olin-electric-motorsports/oem-monorepo/vehicle/mkviii/hardware/hv/power_thermistor/report.txt

Info: Processing symbol 'JP12:Jumper:SolderJumper-2_P1.3mm_Bridged2Bar_Pad1.0x1.5mm'.
Info: Processing symbol 'TH8:Resistor_SMD:R_0603_1608Metric'.
Info: Processing symbol 'TH7:Resistor_SMD:R_0603_1608Metric'.
Info: Processing symbol 'TH6:Resistor_SMD:R_0603_1608Metric'.
Info: Processing symbol 'TH5:Resistor_SMD:R_0603_1608Metric'.
Info: Processing symbol 'TH4:Resistor_SMD:R_0603_1608Metric'.
Info: Processing symbol 'TH3:Resistor_SMD:R_0603_1608Metric'.
Info: Processing symbol 'TH2:Resistor_SMD:R_0603_1608Metric'.
Info: Processing symbol 'TH1:Resistor_SMD:R_0603_1608Metric'.
Info: Processing symbol 'JP18:Jumper:SolderJumper-2_P1.3mm_Bridged2Bar_Pad1.0x1.5mm'.
Info: Processing symbol 'JP16:Jumper:SolderJumper-2_P1.3mm_Bridged2Bar_Pad1.0x1.5mm'.
Info: Processing symbol 'JP15:Jumper:SolderJumper-2_P1.3mm_Bridged2Bar_Pad1.0x1.5mm'.
Info: Processing symbol 'JP14:Jumper:SolderJumper-2_P1.3mm_Bridged2Bar_Pad1.0x1.5mm'.
Info: Processing symbol 'JP13:Jumper:SolderJumper-2_P1.3mm_Bridged2Bar_Pad1.0x1.5mm'.
Info: Processing symbol 'TH9:Resistor_SMD:R_0603_1608Metric'.
Info: Processing symbol 'JP11:Jumper:SolderJumper-2_P1.3mm_Bridged2Bar_Pad1.0x1.5mm'.
Info: Processing symbol 'JP10:Jumper:SolderJumper-2_P1.3mm_Bridged2Bar_Pad1.0x1.5mm'.
Info: Processing symbol 'JP9:Jumper:SolderJumper-2_P1.3mm_Bridged2Bar_Pad1.0x1.5mm'.
Info: Processing symbol 'JP8:Jumper:SolderJumper-2_P1.3mm_Bridged2Bar_Pad1.0x1.5mm'.
Info: Processing symbol 'F1:Fuse:Fuse_0805_2012Metric'.
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
Info: Processing symbol 'J22:OEM:J_Bond_Pad_4p'.
Info: Processing symbol 'J20:OEM:J_Bond_Pad_4p'.
Info: Processing symbol 'J13:OEM:J_Bond_Pad_4p'.
Connect U1 pin 3 to unconnected-(U1-NC-Pad3).
Reconnect U1 pin 1 from unconnected-(J2-Pad18) to Net-(U1-DQ).
Reconnect U1 pin 8 from unconnected-(J2-Pad19) to Net-(U1-GND).
Update U1 fields.
Update U1 symbol association from  to /2b54b1a4-bebb-4afd-9384-270c4761a90f.
Change U1 value from 21-0036K_MXM to DS18B20U.
Update J51 sheetname to '/Cells[1:16]/'.
Connect U1 pin 7 to unconnected-(U1-NC-Pad7).
Update J51 symbol association from  to /527cbe40-fc1c-43ac-87b7-ccac5898a8e8/6e1ec8d3-67b2-4bda-ad9c-3a10cf44766a.
Reconnect U1 pin 4 from unconnected-(J2-Pad19) to Net-(U1-GND).
Connect U1 pin 5 to unconnected-(U1-NC-Pad5).
Connect U1 pin 6 to unconnected-(U1-NC-Pad6).
Connect U1 pin 2 to unconnected-(U1-NC-Pad2).
Reconnect via from unconnected-(J2-Pad19) to Net-(U1-GND).
Reconnect via from unconnected-(J2-Pad19) to Net-(U1-GND).
Reconnect via from unconnected-(J2-Pad18) to Net-(U1-DQ).
Reconnect via from unconnected-(J2-Pad18) to Net-(U1-DQ).

Update J51 footprint filters to 'Pin* Test*'.
Reconnect J7 pin 1 from CELL3 to CELL1.
Update J7 symbol association from /527cbe40-fc1c-43ac-87b7-ccac5898a8e8/93836322-b0e0-494e-abc4-ad7344204299 to /527cbe40-fc1c-43ac-87b7-ccac5898a8e8/d73f3ac7-a89c-432d-8ecd-a9ae640d3e5f.
Add J5 (footprint 'OEM:J_Bond_Pad_4p').
Reconnect J2 pin 1 from CELL16 to Net-(U1-GND).
Update J2 fields.
Update J2 symbol association from  to /7a9c40b1-4f64-439e-81af-f6b9d247b68d.
Change J2 value from  to J_Molex_Header_01x02_VT.
Change J2 footprint from 'OEM:J_Bond_Pad_4p' to 'OEM:J_Molex_Header_01x02_VT - 43045-02YY_121314'.
Reconnect JP9 pin 2 from Net-(JP1-B) to Net-(JP9-B).
Update JP9 symbol association from  to /527cbe40-fc1c-43ac-87b7-ccac5898a8e8/3d94e6c2-b330-4346-9b97-44dc0a67585e.
Reconnect F5 pin 1 from Net-(JP1-B) to Net-(JP9-B).
Update F5 symbol association from  to /527cbe40-fc1c-43ac-87b7-ccac5898a8e8/400e0c96-6297-4099-a81d-c84855c89f24.
Update J51 sheetfile to 'cells.kicad_sch'.
Error: Multiple footprints found for JP9.
Error: Multiple footprints found for U1.
Error: Multiple footprints found for J51.
Error: Multiple footprints found for F5.
Error: Multiple footprints found for J2.
Error: Multiple footprints found for J7.

Info: Total warnings: 0, errors: 6.
