olin-electric-motorsports/oem-monorepo/vehicle/mkviii/hardware/hv/power_thermistor/PowerThermistorOutlineSketch.DXF

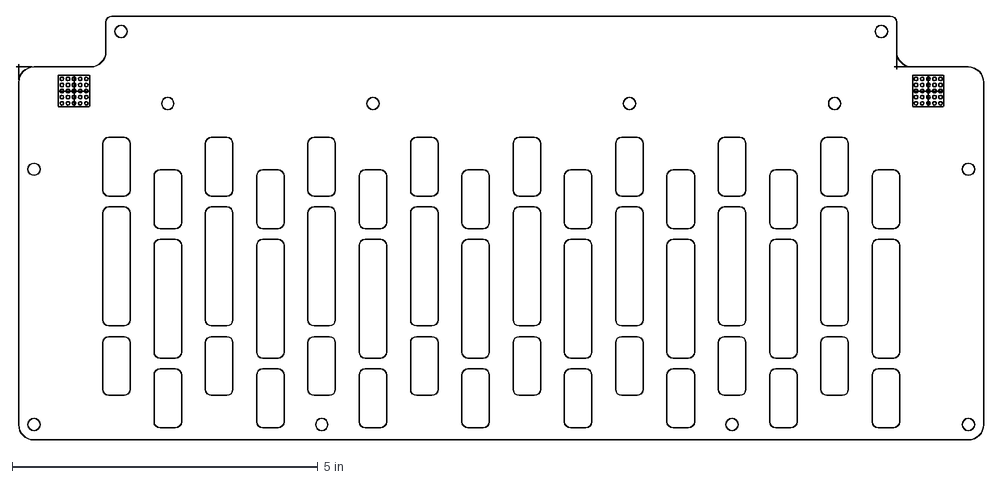
[picture p1: CAD file, 2026-04-11]
vehicle/mkviii/hardware/hv/power_thermistor/PowerThermistorOutlineSketch.DXF
15.8 x 6.93 in
