olin-electric-motorsports/oem-monorepo/parts/3d models/TP_Hook_SMD - 5019--3DModel-STEP-56544.STEP

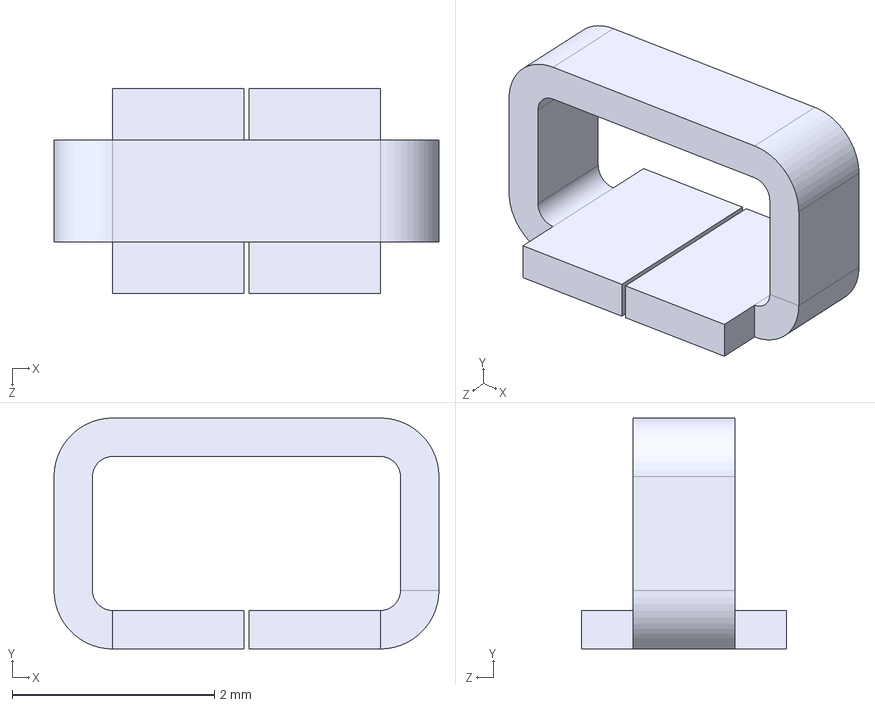
[picture p2: CAD file, 2026-09-20]
parts/3d models/TP_Hook_SMD - 5019--3DModel-STEP-56544.STEP
3.81 x 2.29 x 2.03 mm
