olin-electric-motorsports/oem-monorepo/(list of files, cad)

Other CAD files:
parts/3d models/J_EHT-110-01-F-D - EHT-110-01-F-D.stp
parts/v2.0/3d models/C_100uF_50V_Radial - ESK107M050AG3EA.stp
parts/3d models/J_DE-9_RA - 5745781-4.step
parts/v2.0/3d models/J_Ampseal_23_VT.step
parts/3d models/D_Zener_18V_5W_DO214AA - SMBJ5355B-TP.stp
parts/v2.0/3d models/L_2.2uH_3A_46m_SMD - IHLP1212BZER2R2M11.stp
parts/3d models/J_Molex_Header_02x03_VT - 43045-0614.stp
parts/v2.0/3d models/J_Ampseal_23_RA - 776087-1.step
parts/3d models/J_PCIe_x4 - 2-1761465-2.step
parts/v2.0/3d models/U_1.222V-Buck-Conv_RT6285GSP_ SOP-8.stp
parts/3d models/J_Wurth_7461115 - 7461115.stp
parts/v2.0/3d models/X_12MHz_20pF_SMD - ECS-120-20-33-CKM-TR.stp
parts/3d models/J_PCIe_x1 - 2-1761465-1.step
parts/v2.0/3d models/J_Programming_Pin_Header_Keyed.step
parts/3d models/K_Relay_DPST_NO_10A_12V_TH - G2RG-2A-X_DC12.stp
parts/v2.0/3d models/X_16MHz_18pF_SMD - FA-238_16.0000MB-C0.stp
parts/3d models/J_Molex_Header_01x02_VT - 43045-0212.stp
parts/v2.0/3d models/K_SPST-NO_10A_5V_TH - G5Q-1A4-DC5.stp
parts/3d models/TO247.step
parts/v2.0/3d models/U_SPI-IO-Xpndr_MCP23S17-E_SO_SOIC-28.stp
parts/3d models/8-uSOP.step
parts/v2.0/3d models/R_Pot_50k_0.05W - PTV112-4420A-A503.stp
parts/3d models/TO247-Heatsink - RA-T2X-51E_sp001_sp.step
parts/v2.0/3d models/L_15uH_3.2A_45.5m_SMD - NR10050T150M.stp
parts/3d models/K_Relay_SPST-NC_3A_12V_TH.step
parts/v2.0/3d models/J_Ampseal_14_RA - 1-776266-1.step
parts/v2.0/3d models/C_100uF_100V_Radial - 100ZLH100MEFC12.5X16.step
parts/v2.0/3d models/SW_SPST_0.05A_12V_SMD - B3U-1000P.stp
parts/v2.0/3d models/J_Ampseal_14_VT - AmpSeal-14.step
parts/v2.0/3d models/U_5V-DC-DC_PQME1-S5-S5-M-TR_SMD.stp
parts/v2.0/3d models/L_2.2uH_8.2A_19m_SMD - SPM6530T-2R2M.stp
parts/v2.0/3d models/J_Ampseal_8_VT - 1-776276-1.step
parts/v2.0/3d models/C_10uF_450V_Radial - 450BXC10MEFC10X20.stp
parts/v2.0/3d models/K_SPST-NO_10A_12V_TH - G5Q-1A4-DC12.stp
parts/v2.0/3d models/U_Quad-NAND-RS-Latch_CD4044BDR_16-SOIC - CD4044BDR.stp
parts/v2.0/3d models/SW_SPST_0.05A_12V_SMD - PTS645SM43SMTR92_LFS.stp
parts/v2.0/3d models/L_3.3uH_5A_21m_SMD - SRN6045TA-3R3Y.stp
parts/v2.0/3d models/L_BMS-isoSPI-Transformer_SM91501AL-E_SMD - SM91501ALE.stp
parts/v2.0/3d models/U_Current-Sensor_ACS37010LLZATR-030B5_SOIC-6.stp
parts/v2.0/3d models/J_Ampseal_8_RA - 1-776279-1.step
parts/v2.0/3d models/L_3.9uH_2A_55m_SMD - IND_BOURNS_SRR5018.step
parts/v2.0/3d models/C_1000uF_25V_Radial - UPS1E102MHD.stp
parts/v2.0/3d models/D_Schottky_100V_1A_SOD123W - SS110LW.stp
parts/v2.0/3d models/X_8MHz_12pF_SMD - ECS-80-12-33-JGN-TR.stp
parts/v2.0/3d models/U_NAND-Gate_BU4S11G2-TR_5SSOP - BU4S11G2-TR.stp
parts/archive-v2.0/3d models/X_12MHz_20pF_SMD - ECS-120-20-33-CKM-TR.stp
