olin-electric-motorsports/oem-monorepo/assets/Debugger_window.png

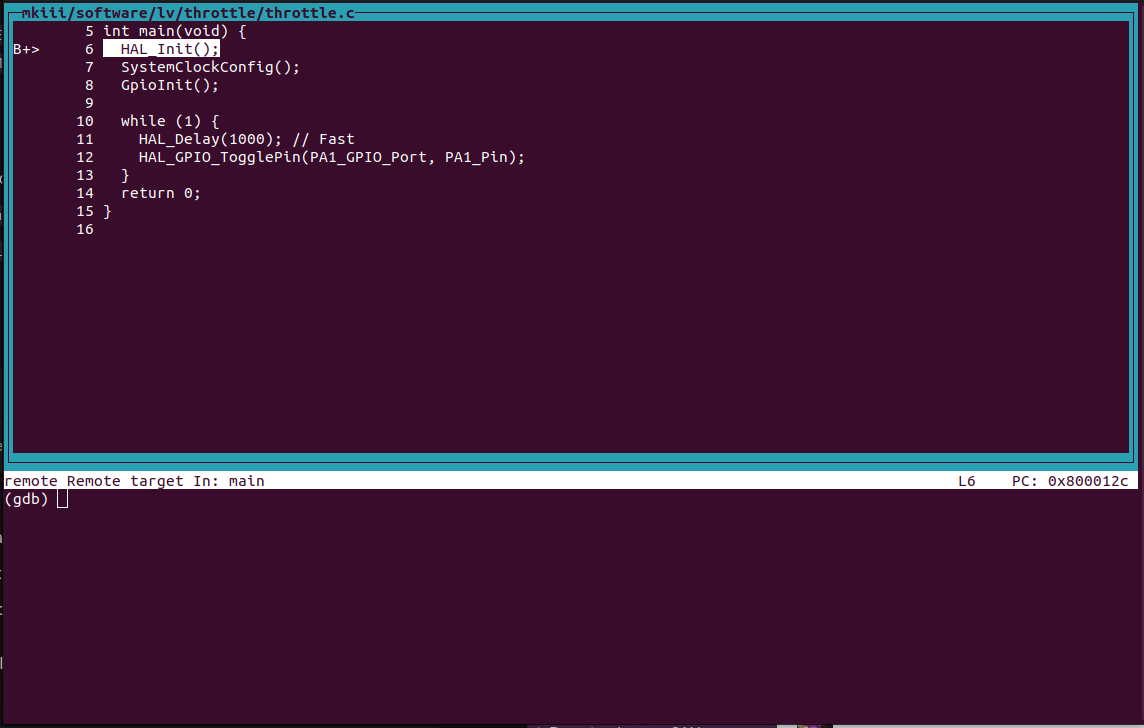
assets/Debugger_window.png
