olin-electric-motorsports/oem-monorepo/vehicle/mkviii/hardware/sensing/brake_temp_sensor/braketemperature.kicad_pcb

## KiCad design vehicle/mkviii/hardware/sensing/brake_temp_sensor/braketemperature.kicad_pcb (2026-11-13)

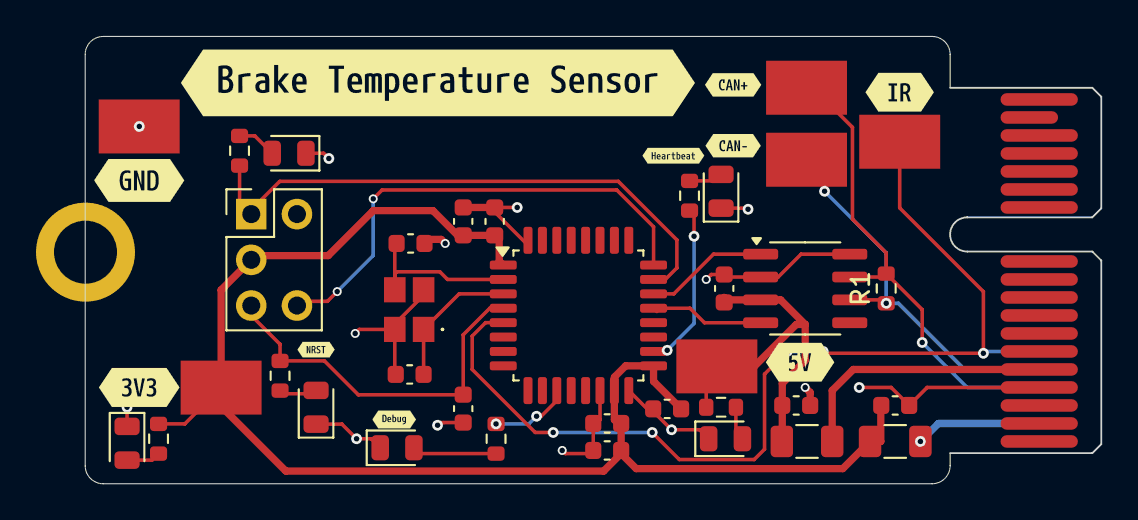
[picture p4: board braketemperature.kicad_pcb from above]

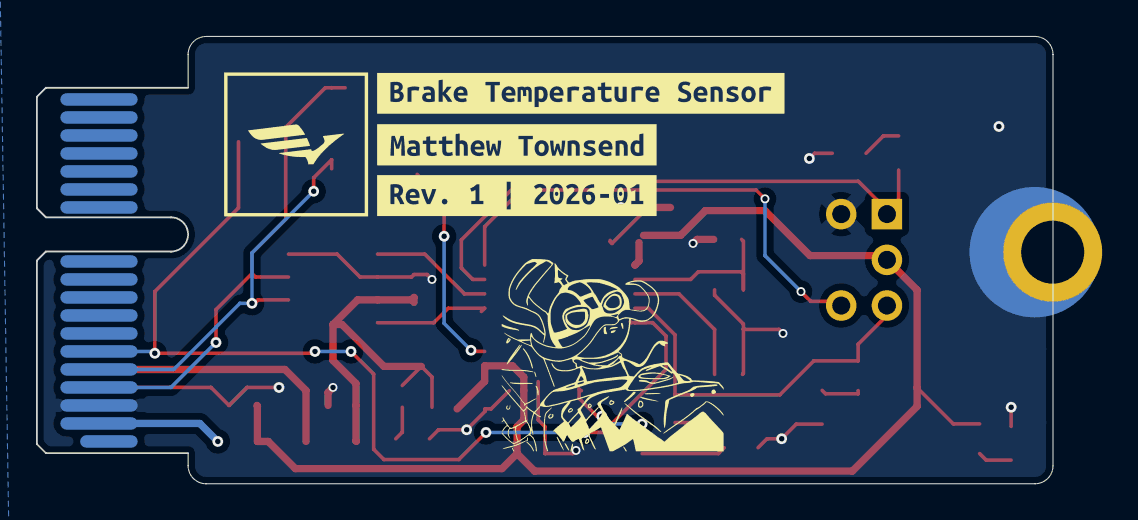
[picture p5: board braketemperature.kicad_pcb from below]

Board: 2 copper layers, 56.4 x 24.9 mm, 51 parts (3 on the bottom side), 23 nets.

Parts:
C1, C2, C4, C7: C_0.1uF; C_0603_1608Metric
C3: C_10nF; C_0603_1608Metric
C5: C_1uF; C_0603_1608Metric
C6: C_4.7uF; C_0603_1608Metric
C8, C9: C_30pF; C_0603_1608Metric
C10, C11: C_10uF_10V; C_0603_1608Metric
D1, D2, D3, D4, D5, D6: D_Red_LED; D_0805_2012Metric
F1, F2: F_500mA_8V; Fuse_1206_3216Metric
H1: H_MountingHole
J1: J_PCIe_x1; J_PCIe_x1_Key
J2: J_Programming_Pin_Header; J_Programming_Pin_Header_Keyed
R1: R_120; R_0603_1608Metric
R2, R3, R4, R5, R6, R7: R_1k; R_0603_1608Metric
TP1, TP2, TP3, TP4, TP5, TP6: TP_SMD; TP_Hook_SMD
U1: MCP2561-E_SN; SOIC-8_3.9x4.9mm_P1.27mm
U2: STM32G441KBT6; LQFP-32_7x7mm_P0.8mm
Y1: X_16MHz_18pF; FA238160000MBC0 (X_16MHz_18pF_SMD - FA-238_16.0000MB-C0)
kibuzzard-697E6E94: G***; kibuzzard-697E6E94
kibuzzard-697E6EEF: G***; kibuzzard-697E6EEF
kibuzzard-697E6F70: G***; kibuzzard-697E6F70
kibuzzard-697E6FE4: G***; kibuzzard-697E6FE4
kibuzzard-697F80A9: G***; kibuzzard-697F80A9
kibuzzard-697F80BA: G***; kibuzzard-697F80BA
kibuzzard-697F802E: G***; kibuzzard-697F802E
kibuzzard-69815F9D: G***; kibuzzard-69815F9D
kibuzzard-69815FEC: G***; kibuzzard-69815FEC
kibuzzard-69815FF8: G***; kibuzzard-69815FF8
kibuzzard-69816079: G***; kibuzzard-69816079
kibuzzard-69816083: G***; kibuzzard-69816083
kibuzzard-69816091: G***; kibuzzard-69816091

Connections:
+3V3: C2.1, C3.1, C4.1, C5.1, C6.1, C11.1, F2.1, J2.3, R3.1, TP3.1, U2.1 (VDD), U2.15 (VDDA), U2.17 (VDD)
+5V: C1.1, C10.1, F1.1, R2.1, TP2.1, U1.3 (VDD)
/CAN_RX: U1.4 (RXD), U2.21 ((FDCAN1_RX/GPIO_EXTI11)PA11)
/CAN_TX: U1.1 (TXD), U2.22 ((FDCAN1_TX/GPIO_EXTI12)PA12)
/Debug LED: R5.1, U2.11 ((TIM3_CH1/TIM16_CH1/GPIO_EXTI6/ADC2_IN3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)
/Heartbeat LED: R4.1, U2.18 ((TIM4_ETR/USART1_CK/GPIO_EXTI8)PA8)
/IR Output - PA0: J1.A6 (io_0), TP1.1, U2.5 ((TIM2_ETR/TIM2_CH1/GPIO_EXTI0/ADC2_IN1/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)
/NRST: C7.1, J2.4, R6.1, U2.4 ((GPIO_EXTI10)PG10-NRST)
/SWCLK: J2.5, U2.24 ((SYS_JTCK-SWCLK/GPIO_EXTI14)PA14)
/SWDIO: J2.1, R7.1, U2.23 ((SYS_JTMS-SWDIO/GPIO_EXTI13)PA13)
GND: C1.2, C2.2, C3.2, C4.2, C5.2, C6.2, C7.2, C8.2, C9.2, C10.2, C11.2, D1.1 (K), D2.1 (K), D3.1 (K), D4.1 (K), D5.1 (K), D6.1 (K), H1.1, J1.A3 (GND), J1.B4 (GND), J2.2, TP6.1, U1.2 (VSS), U1.8 (STBY), U2.14 (VSSA), U2.16 (VSS), U2.32 (VSS), Y1.2, Y1.4
unnamed: D1.2 (A), R2.2
unnamed: D2.2 (A), R3.2
unnamed: D3.2 (A), R4.2
unnamed: D4.2 (A), R5.2
unnamed: D5.2 (A), R6.2
unnamed: D6.2 (A), R7.2
unnamed: F2.2, J1.A2 (3.3V)
unnamed: F1.2, J1.B5 (5V)
unnamed: J1.A4 (CAN+), R1.2, TP4.1, U1.7 (CANH)
unnamed: J1.A5 (CAN-), R1.1, TP5.1, U1.6 (CANL)
unnamed: C9.1, U2.2 (PF0-OSC_IN), Y1.3
unnamed: C8.1, U2.3 (PF1-OSC_OUT), Y1.1
