olin-electric-motorsports/oem-monorepo/vehicle/mkviii/hardware/hv/precharge_discharge/prechargedischarge_mkviii.kicad_pcb

## KiCad design vehicle/mkviii/hardware/hv/precharge_discharge/prechargedischarge_mkviii.kicad_pcb (2026-04-04)

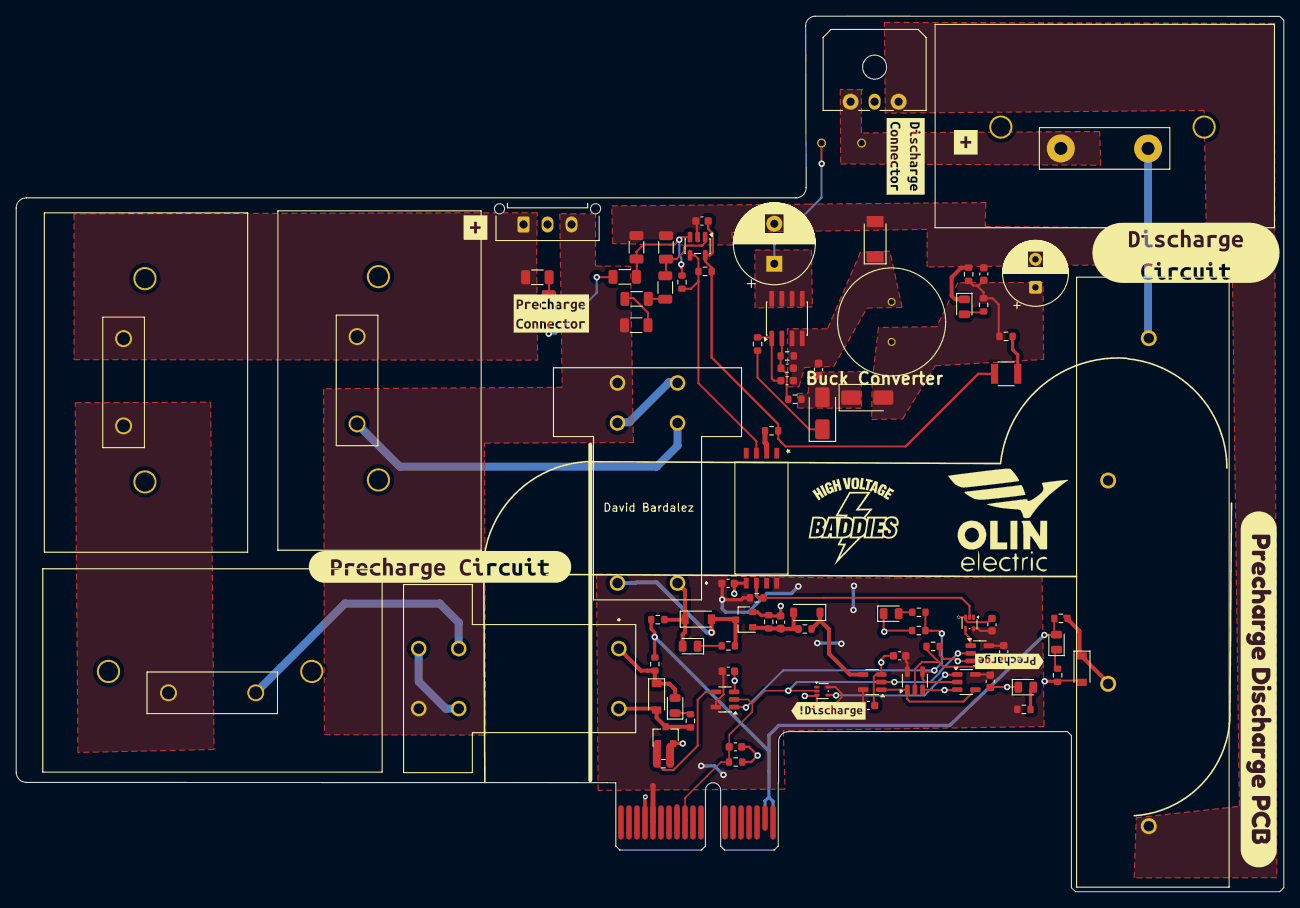
[picture p6: board prechargedischarge_mkviii.kicad_pcb from above]

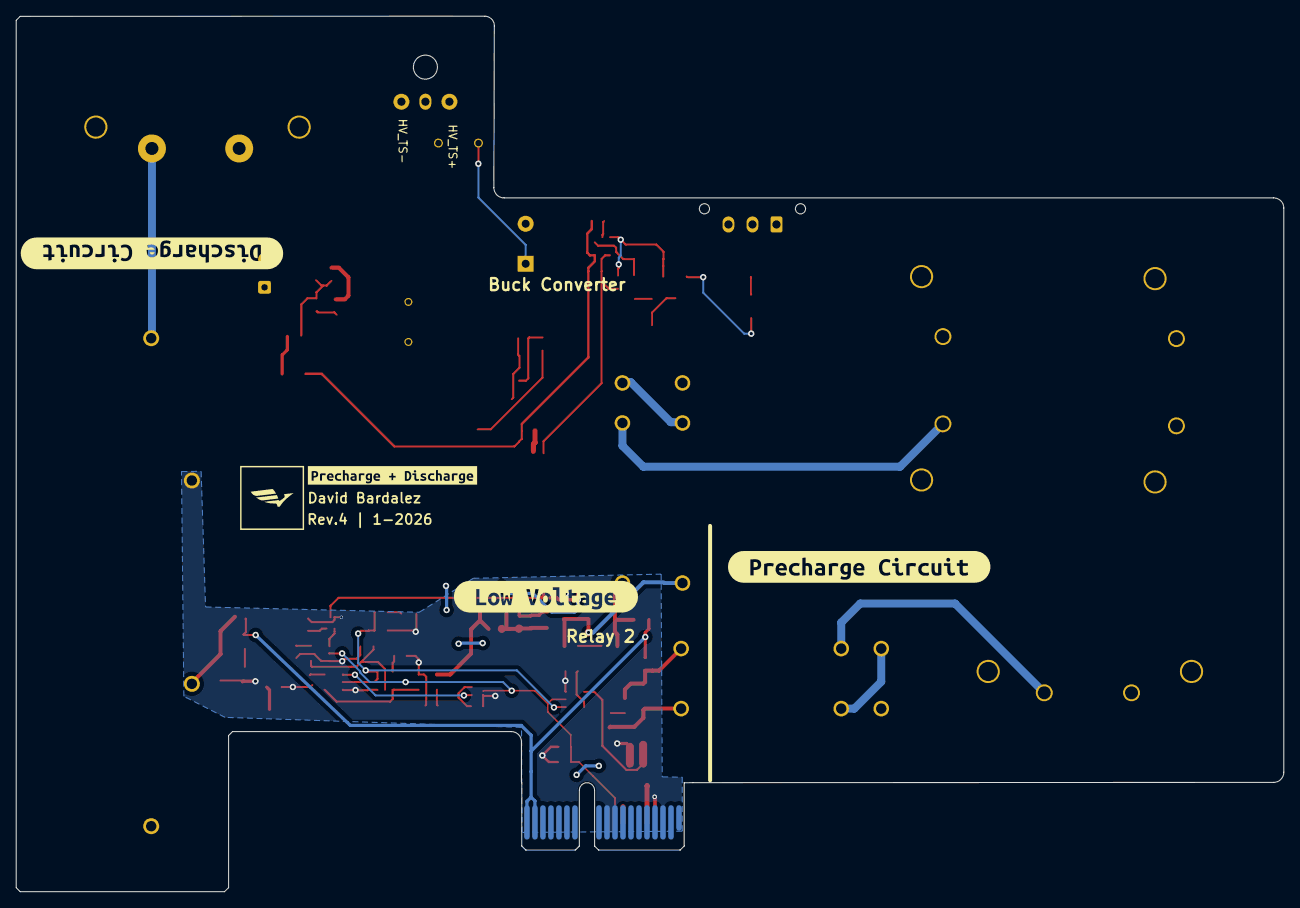
[picture p7: board prechargedischarge_mkviii.kicad_pcb from below]

Board: 2 copper layers, 158.4 x 109.4 mm, 100 parts (4 on the bottom side), 51 nets.

Parts:
C1, C5, C6, C10, C14, C15, C16: 0.1 µF; C_0603_1608Metric
C2: C_2.2uF; C_0603_1608Metric
C3: C_470pF; C_0603_1608Metric
C4: C_.22uF; C_0603_1608Metric
C7: 100uF+; CP_Radial_D8.0mm_P3.50mm
C8: C_1uF; C_0603_1608Metric
C9: 10uF+; CP_Radial_D10.0mm_P5.00mm
C11: C_2.2uF_25V; C_0603_1608Metric
C12, C13: C_0.1uF; C_0603_1608Metric
C17: C_10nF; C_0603_1608Metric
D1, D3, D6: SS110LW; D_SOD-123
D2, D4, D5: LED_WHITE; D_0805_2012Metric
D7, D9: STTH1R06AF; D_SMA
D8: STTH1R06AF; D_SOD-128
D10, D13: LED_WHITE; LED_0805_2012Metric
D11: 1N4148W; D_SOD-123
D12: BSPD_TRIP_LED; D_0805_2012Metric
F1: F_21mA_420V
F2: F_500mA_16V; Fuse_1210
J2: Conn_01x03_Pin; Molex_Micro-Fit_3.0_43650-0300_1x03_P3.00mm_Horizontal
J3: CONN_pcie_x1; pcie_x1
J4: Conn_01x03_Pin; Molex_Micro-Fit_3.0_43650-0315_1x03_P3.00mm_Vertical
K1, K3: G2RG-2A-X_DC12; K_Relay_DPST_NO_10A_12V_TH
K2: 3350-4275-126; Relay_Comus_3350
L1: L_1.2mH
Q1, Q2: SSM3K333R; SOT-23F
R1: 10KR; R_0603
R2, R10: 12R; R_0603_1608Metric
R3, R4: 560R-100W; R_TO247-Heatsink
R5: 12R; R_0603
R6: 3KR-100W; R_TO247-Heatsink
R7, R8, R11: 1KR; R_0603
R9: 120R-100W; R_TO247-Heatsink
R12: 270kR; R_0603
R13, R14, R17, R18: 2.2 MΩ; R_1206_3216Metric
R15, R19: 330 kΩ; R_1206_3216Metric
R16: 36 kΩ; R_1206_3216Metric
R20: 25 kΩ; R_1206_3216Metric
R21: R_71.5K; R_0603_1608Metric
R22: R_6.04K; R_0603_1608Metric
R23: R_3K; R_0603_1608Metric
R24, R27, R30: R_1K; R_0603_1608Metric
R25: R_0_2512; R_0603_1608Metric
R26: 330Ω; R_0603_1608Metric
R28, R32: R_10K; R_0603_1608Metric
R29: R_4.7M; R_0603_1608Metric
R31: R_71.5k; R_0603_1608Metric
R33, R36: R_10k; R_0603_1608Metric
R34, R35: 100 kΩ; R_0603_1608Metric
U1, U6: U_GATE_SN74LVC1G02DBVR; SOT-23-5
U2: LM397; SOT-23-5
U3: MP9488; SOIC-8_3.9x4.9mm_P1.27mm
U4: ACNT-H50L-500E
U5, U9: 74LVC1GU04DRL; SOT-553
U7, U8, U10: SN74LVC1G08DBVR; SOT-23-5
kibuzzard-679E7E49, kibuzzard-679E7E49#2: G***; kibuzzard-679E7E49
kibuzzard-679E7E71: G***; kibuzzard-679E7E71
kibuzzard-679E7EA1: G***; kibuzzard-679E7EA1
kibuzzard-679E816B: G***; kibuzzard-679E816B
kibuzzard-679E8163: G***; kibuzzard-679E8163
kibuzzard-679E8270: G***; kibuzzard-679E8270
kibuzzard-679EBF0B, kibuzzard-679EBF0B#2: G***; kibuzzard-679EBF0B
kibuzzard-6784D6A3: G***; kibuzzard-6784D6A3
kibuzzard-6784D6E2: G***; kibuzzard-6784D6E2
kibuzzard-6784D698: G***; kibuzzard-6784D698
kibuzzard-639639B8: G***; kibuzzard-639639B8

Connections:
+5V: C5.1, C6.1, C10.1, C12.1, C13.1, C14.1, C15.1, C16.1, J3.B5 (5V), R27.1, R36.2, U1.5 (VCC), U4.8, U5.5 (VCC), U6.5 (VCC), U7.5 (VCC), U8.5 (VCC), U9.5 (VCC), U10.5 (VCC)
/+5V_TS_FUSED: C1.1, F2.1, R26.1, R33.2, U2.5 (V+)
/DONE_ISO: R36.1, U4.6, U5.2
/DONE_ISO_N: U5.4, U10.1
/DONE_ISO_SET: R35.2, U1.2 (in), U10.4
/DONE_LATCHED: U1.1 (in), U6.4 (out), U7.1
/DONE_LATCHED_N: R30.1, R32.1, U1.4 (out), U6.2 (in), U8.1
/FB: C3.1, R21.2, R22.1, U3.2 (FB)
/FINAL_SHUTDOWN: D2.2 (A), J3.A17 (SHDN_IN/io_22), J3.A18 (SHDN_IN/io_24), R2.1, R5.1, R10.1
/HV_BAT+: J4.1, R4.1, R9.1, R13.2
/HV_TS+: F1.2, J2.1, R6.1
/HV_TS+_Fuse: J4.3, K1.5 (NO_(-)), K3.5 (NO_(-)), R17.2
/HV_TS-: C1.2, C7.2, C8.2, C9.2, D8.2 (A), D10.1 (K), J2.3, K2.1, R16.2, R20.2, R23.2, U2.2 (V-)
/PRECHARGE_DONE_N: R29.1, R33.1, U2.4, U4.3
/PRECHARGE_LSD: C17.2, J3.B9 (io_7), R34.2, U7.2, U8.2, U9.2, U10.2
/PRECHARGE_LSD_1: Q1.1 (G), R1.1, U8.4
/PRECHARGE_LSD_2: D11.1 (K), R31.2, U7.4
/PRECHARGE_LSD_N: U6.1 (in), U9.4
/SW: C2.2, C3.2, C4.2, D8.1 (K), L1.1, R22.2, U3.3 (SW), U3.4 (SW)
/TS+_FUSED: C9.1, F1.1, U3.5 (NC), U3.6 (NC), U3.7 (VIN), U3.8 (NC)
/VCC: C2.1, R28.2, U3.1 (VCC)
/V_DC_SENSE: R15.1, R16.1, R29.2, U2.3 (+)
/V_PACK_SENSE: R19.1, R20.1, U2.1 (-)
GND: C5.2, C6.2, C10.2, C11.2, C12.2, C13.2, C14.2, C15.2, C16.2, C17.1, D3.2 (A), D12.1 (K), D13.1 (K), J3.A3 (GND), J3.A9 (io_6), J3.A10 (io_8), J3.B4 (GND), K2.3 (-), Q1.2 (S), Q2.2 (S), R1.2, R7.2, R12.2, R32.2, R34.1, R35.1, U1.3 (GND), U4.5, U5.3 (GND), U6.3 (GND), U7.3 (GND), U8.3 (GND), U9.3 (GND), U10.3 (GND)
unnamed: D1.2 (A), K1.8 (COIL_2), Q1.3 (D), R8.2
unnamed: D1.1 (K), D4.2 (A), K1.1 (COIL_1), R2.2
unnamed: D2.1 (K), R7.1
unnamed: D3.1 (K), K2.2 (+), R5.2
unnamed: D4.1 (K), R8.1
unnamed: D5.2 (A), D6.1 (K), K3.1 (COIL_1), R10.2
unnamed: D5.1 (K), R11.1
unnamed: D6.2 (A), K3.8 (COIL_2), Q2.3 (D), R11.2
unnamed: C4.1, D7.2 (A), D9.1 (K), R21.1
unnamed: D7.1 (K), R28.1
unnamed: C7.1, C8.1, D9.2 (A), L1.2, R23.1, R24.1, R25.2
unnamed: D10.2 (A), R24.2
unnamed: C11.1, D11.2 (A), Q2.1 (G), R12.1, R31.1
unnamed: D12.2 (A), R30.2
unnamed: D13.2 (A), R27.2
unnamed: F2.2, R25.1
unnamed: K1.4 (NO), K1.6 (COM)
unnamed: K1.3 (COM_(+)), R3.2
unnamed: K2.4, R6.2
unnamed: K3.4 (NO), K3.6 (COM)
unnamed: K3.3 (COM_(+)), R9.2
unnamed: R3.1, R4.2
unnamed: R13.1, R14.2
unnamed: R14.1, R15.2
unnamed: R17.1, R18.2
unnamed: R18.1, R19.2
unnamed: R26.2, U4.2
