olin-electric-motorsports/oem-monorepo/vehicle/mkviii/hardware/sensing/tire_temp_sensor/tire_temp_sensor.kicad_pcb

## KiCad design vehicle/mkviii/hardware/sensing/tire_temp_sensor/tire_temp_sensor.kicad_pcb (2026-02-10)

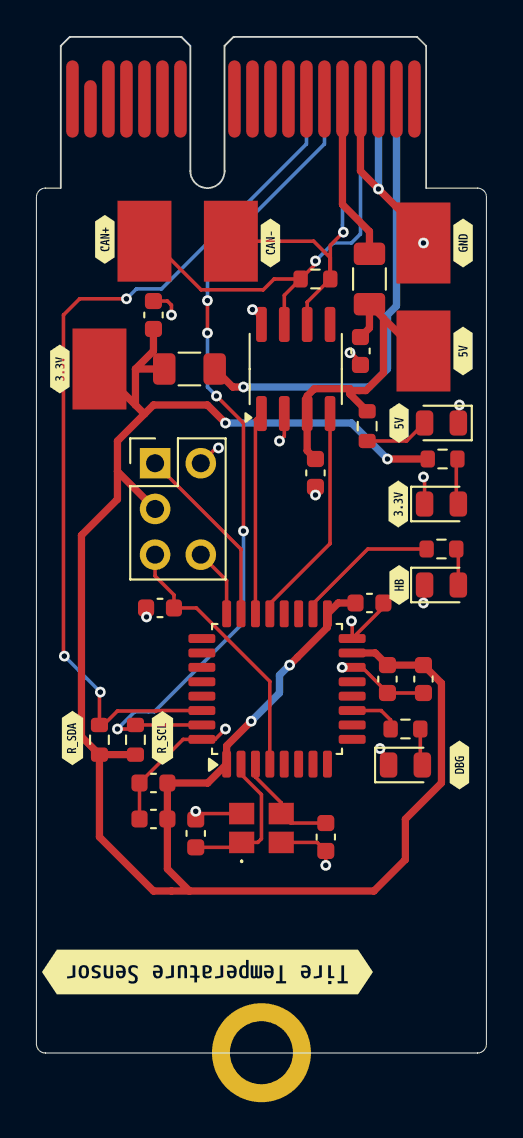
[picture p8: board tire_temp_sensor.kicad_pcb from above]

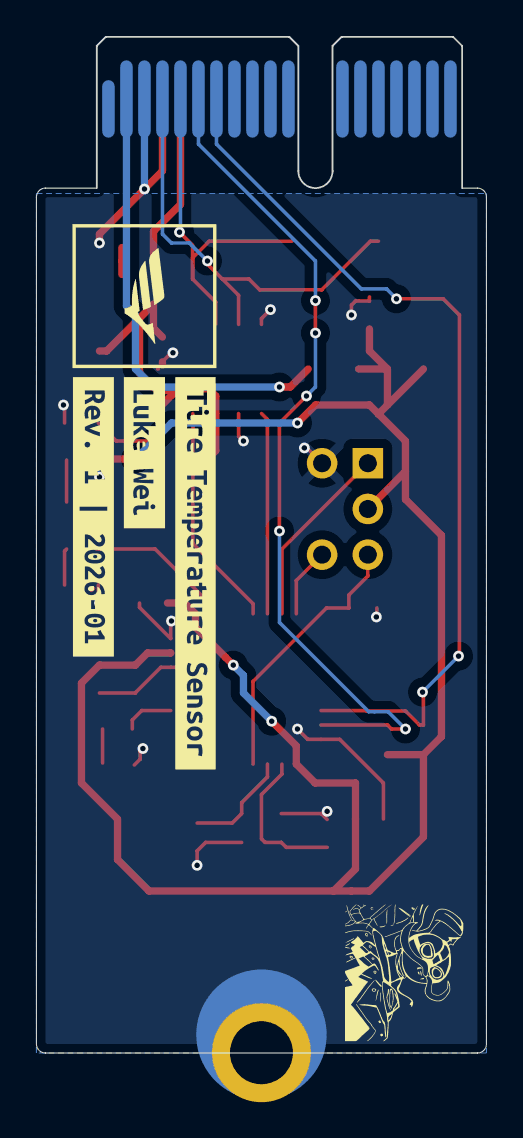
[picture p9: board tire_temp_sensor.kicad_pcb from below]

Board: 2 copper layers, 25.0 x 56.5 mm, 50 parts (3 on the bottom side), 22 nets.

Parts:
C1: C_4.7uF_25V; C_0603_1608Metric
C2, C5, C7, C11: C_0.1uF_16V; C_0603_1608Metric
C3, C6: C_30pF_50V; C_0603_1608Metric
C4: C_1uF_50V; C_0603_1608Metric
C8, C9: C_10uF_10V; C_0603_1608Metric
C10: C_10nF_50V; C_0603_1608Metric
D1, D2, D3, D4: D_Blue_LED; D_0805_2012Metric
F1, F3: F_500mA_8V; Fuse_1206_3216Metric
H2: H_MountingHole
J2: J_PCIe_x1; J_PCIe_x1_Key
J3: J_Programming_Pin_Header; J_Programming_Pin_Header_Keyed
R1, R2: R_2.2k_0.1W; R_0603_1608Metric
R3: R_120; R_0603_1608Metric
R4, R5, R6, R7: R_1k; R_0603_1608Metric
TP1, TP2, TP3, TP4, TP5: TP_SMD; TP_Hook_SMD
U1: STM32G441KBT6; LQFP-32_7x7mm_P0.8mm
U2: MCP2561-E_SN; SOIC-8_3.9x4.9mm_P1.27mm
Y1: X_16MHz_18pF; FA238160000MBC0 (X_16MHz_18pF_SMD - FA-238_16.0000MB-C0)
kibuzzard-697E5AB9: G***; kibuzzard-697E5AB9
kibuzzard-697E5B7C: G***; kibuzzard-697E5B7C
kibuzzard-697E5B13: G***; kibuzzard-697E5B13
kibuzzard-697E5B64: G***; kibuzzard-697E5B64
kibuzzard-697E5B74: G***; kibuzzard-697E5B74
kibuzzard-697E5BB9: G***; kibuzzard-697E5BB9
kibuzzard-697E5C85: G***; kibuzzard-697E5C85
kibuzzard-697E5DCC: G***; kibuzzard-697E5DCC
kibuzzard-697E5E44: G***; kibuzzard-697E5E44
kibuzzard-697E730B: G***; kibuzzard-697E730B
kibuzzard-6980A3A7: G***; kibuzzard-6980A3A7
kibuzzard-6980A425: G***; kibuzzard-6980A425
kibuzzard-6980A498: G***; kibuzzard-6980A498
kibuzzard-698147C7: G***; kibuzzard-698147C7
kibuzzard-69814769: G***; kibuzzard-69814769

Connections:
+3.3V: C1.1, C4.1, C5.1, C8.1, C10.1, C11.1, F3.1, J3.3, R1.1, R2.1, R6.1, TP1.1, U1.1 (VDD), U1.15 (VDDA), U1.17 (VDD)
+5V: C7.1, C9.1, F1.1, R7.1, TP3.1, U2.3 (VDD)
/CAN_+: J2.A4 (CAN+), R3.1, TP5.1, U2.7 (CANH)
/CAN_-: J2.A5 (CAN-), R3.2, TP4.1, U2.6 (CANL)
/CAN_RX: U1.21 ((FDCAN1_RX/GPIO_EXTI11)PA11), U2.4 (RXD)
/CAN_TX: U1.22 ((FDCAN1_TX/GPIO_EXTI12)PA12), U2.1 (TXD)
/Debug LED: R5.1, U1.11 ((TIM3_CH1/TIM16_CH1/GPIO_EXTI6/ADC2_IN3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)
/Heartbeat LED: R4.1, U1.18 ((TIM4_ETR/USART1_CK/GPIO_EXTI8)PA8)
/I2C1_SCL: J2.A6 (io_0), R1.2, U1.31 ((TIM4_CH3/TIM16_CH1/GPIO_EXTI8)PB8-BOOT0)
/I2C1_SDA: J2.A7 (io_2), R2.2, U1.30 ((TIM3_CH4/TIM4_CH2/TIM17_CH1N/GPIO_EXTI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)
/NRST: C2.1, J3.4, U1.4 ((GPIO_EXTI10)PG10-NRST)
/SWCLK: J3.5, U1.24 ((SYS_JTCK-SWCLK/GPIO_EXTI14)PA14)
/SWDIO: J3.1, U1.23 ((SYS_JTMS-SWDIO/GPIO_EXTI13)PA13)
GND: C1.2, C2.2, C3.2, C4.2, C5.2, C6.2, C7.2, C8.2, C9.2, C10.2, C11.2, D1.1 (K), D2.1 (K), D3.1 (K), D4.1 (K), H2.1, J2.A3 (GND), J2.B4 (GND), J3.2, TP2.1, U1.14 (VSSA), U1.16 (VSS), U1.32 (VSS), U2.2 (VSS), U2.8 (STBY), Y1.2, Y1.4
unnamed: D1.2 (A), R5.2
unnamed: D2.2 (A), R4.2
unnamed: D3.2 (A), R6.2
unnamed: D4.2 (A), R7.2
unnamed: F3.2, J2.A2 (3.3V)
unnamed: F1.2, J2.B5 (5V)
unnamed: C6.1, U1.2 (PF0-OSC_IN), Y1.1
unnamed: C3.1, U1.3 (PF1-OSC_OUT), Y1.3
