olin-electric-motorsports/oem-monorepo/vehicle/mkviii/hardware/sensing/angle_sensor/TorqueSensor.kicad_pcb

## KiCad design vehicle/mkviii/hardware/sensing/angle_sensor/TorqueSensor.kicad_pcb (2026-02-10)

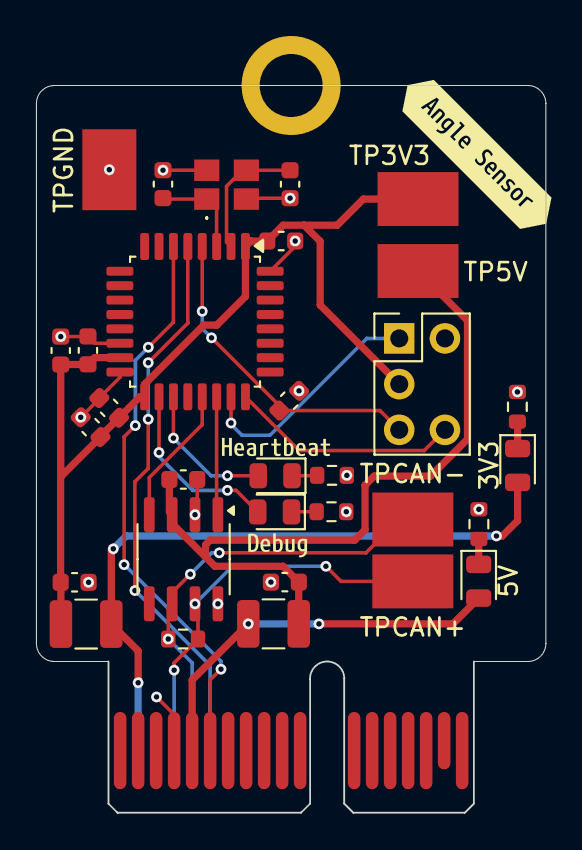
[picture p10: board TorqueSensor.kicad_pcb from above]

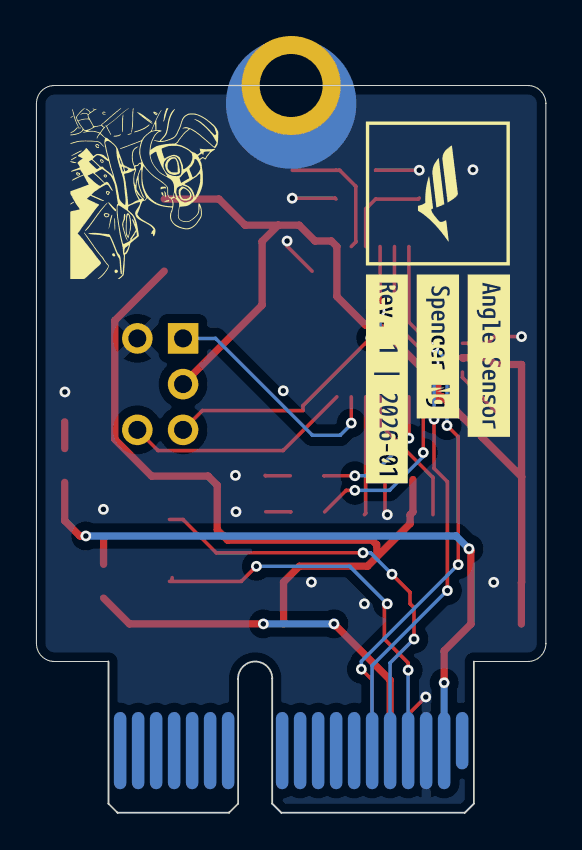
[picture p11: board TorqueSensor.kicad_pcb from below]

Board: 2 copper layers, 28.3 x 40.4 mm, 39 parts (3 on the bottom side), 22 nets.

Parts:
3V3, 5V: LED_WHITE; D_0805_2012Metric
C1: C_0.1uF_16V; C_0603_1608Metric
C2, C9: C_30pF_50V; C_0603_1608Metric
C3: C_4.7uF_25V; C_0603_1608Metric
C4, C5, C8: C_0.1uF_50V; C_0603_1608Metric
C6: C_1uF_50V; C_0603_1608Metric
C7: C_10nF_50V; C_0603_1608Metric
C10, C11: C_10uF_10V; C_0603_1608Metric
D1: LED_AMBER; D_0805_2012Metric
D2: LED_WHITE; D_0805_2012Metric
F1, F2: F_500mA_16V; Fuse_1210_3225Metric
H1: H_MountingHole
J1: J_PCIe_x1; J_PCIe_x1_Key
J2: J_Programming_Pin_Header; J_Programming_Pin_Header_Keyed
R1, R3, R4, R5: R_1k; R_0603_1608Metric
R2: R_120; R_0603_1608Metric
TP3V3, TP5V: TP_SMD; TP_Hook_SMD
TPCAN+: TP_SMD; TP_Hook_SMD
TPCAN-: TP_SMD; TP_Hook_SMD
TPGND: TP_SMD; TP_Hook_SMD
U2: STM32G441KBT6; LQFP-32_7x7mm_P0.8mm
U3: MCP2561-E_SN; SOIC-8_3.9x4.9mm_P1.27mm
Y1: X_16MHz_18pF; FA238160000MBC0 (X_16MHz_18pF_SMD - FA-238_16.0000MB-C0)
kibuzzard-697FF3E2: G***; kibuzzard-697FF3E2
kibuzzard-697FF3F7: G***; kibuzzard-697FF3F7
kibuzzard-697FF4A8: G***; kibuzzard-697FF4A8
kibuzzard-697FF7D3: G***; kibuzzard-697FF7D3
kibuzzard-697FF82D: G***; kibuzzard-697FF82D
kibuzzard-697FF937: G***; kibuzzard-697FF937

Connections:
+3V3: C3.1, C4.1, C5.1, C6.1, C7.1, C10.1, F1.1, J2.3, TP3V3.1, U2.1 (VDD), U2.15 (VDDA), U2.17 (VDD)
+5V: C1.1, C11.1, F2.1, TP5V.1, U3.3 (VDD)
/CAN_+: J1.A4 (CAN+), R2.2, TPCAN+.1, U3.7 (CANH)
/CAN_-: J1.A5 (CAN-), R2.1, TPCAN-.1, U3.6 (CANL)
/CAN_RX: U2.21 ((FDCAN1_RX/GPIO_EXTI11)PA11), U3.4 (RXD)
/CAN_TX: U2.22 ((FDCAN1_TX/GPIO_EXTI12)PA12), U3.1 (TXD)
/DEBUG_LED: D1.2 (A), U2.18 ((TIM4_ETR/USART1_CK/GPIO_EXTI8)PA8)
/HEARTBEAT_LED: D2.2 (A), U2.19 ((TIM2_CH3/TIM15_BKIN/USART1_TX/GPIO_EXT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)
/NRST: C8.1, J2.4, U2.4 ((GPIO_EXTI10)PG10-NRST)
/PWM_Input: J1.A6 (io_0), U2.5 ((TIM2_ETR/TIM2_CH1/GPIO_EXTI0/ADC2_IN1/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)
/SWCLK: J2.5, U2.24 ((SYS_JTCK-SWCLK/GPIO_EXTI14)PA14)
/SWDIO: J2.1, U2.23 ((SYS_JTMS-SWDIO/GPIO_EXTI13)PA13)
/Status_Signal_Input: J1.B6 (io_1), U2.6 ((TIM15_CH1N/TIM2_CH2/GPIO_EXTI1/ADC2_IN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)
GND: C1.2, C2.2, C3.2, C4.2, C5.2, C6.2, C7.2, C8.2, C9.2, C10.2, C11.2, H1.1, J1.A3 (GND), J1.B4 (GND), J2.2, R1.2, R3.2, R4.2, R5.2, TPGND.1, U2.14 (VSSA), U2.16 (VSS), U2.32 (VSS), U3.2 (VSS), U3.8 (STBY), Y1.2, Y1.4
unnamed: D1.1 (K), R3.1
unnamed: D2.1 (K), R4.1
unnamed: 3V3.2 (A), F1.2, J1.A2 (3.3V)
unnamed: 3V3.1 (K), R1.1
unnamed: 5V.2 (A), F2.2, J1.B5 (5V)
unnamed: 5V.1 (K), R5.1
unnamed: C9.1, U2.2 (PF0-OSC_IN), Y1.3
unnamed: C2.1, U2.3 (PF1-OSC_OUT), Y1.1
