olin-electric-motorsports/oem-monorepo/vehicle/mkviii/hardware/lv/vcu/VCU.kicad_pcb

## KiCad design vehicle/mkviii/hardware/lv/vcu/VCU.kicad_pcb (2026-02-10)

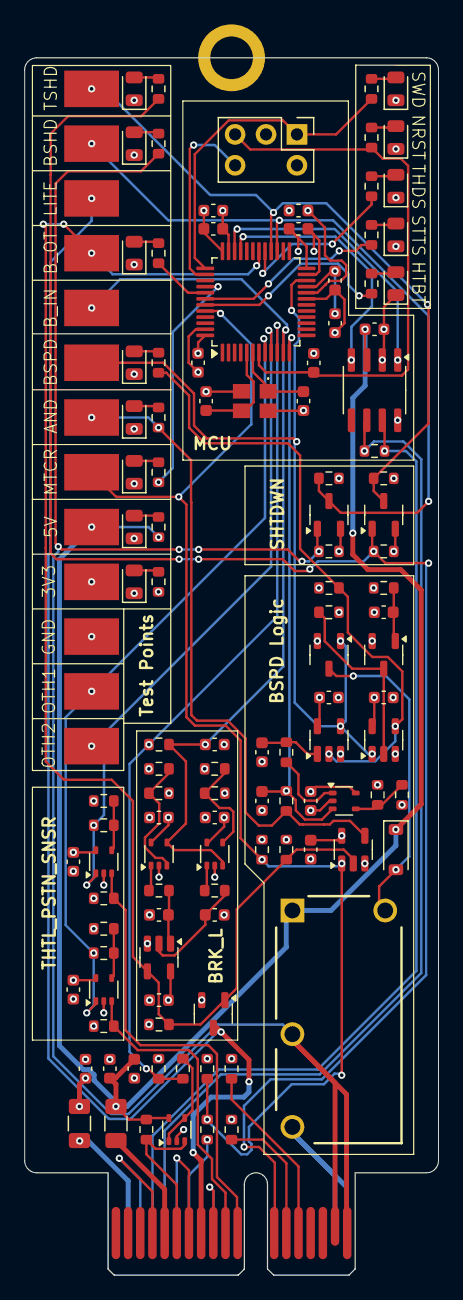
[picture p12: board VCU.kicad_pcb from above]

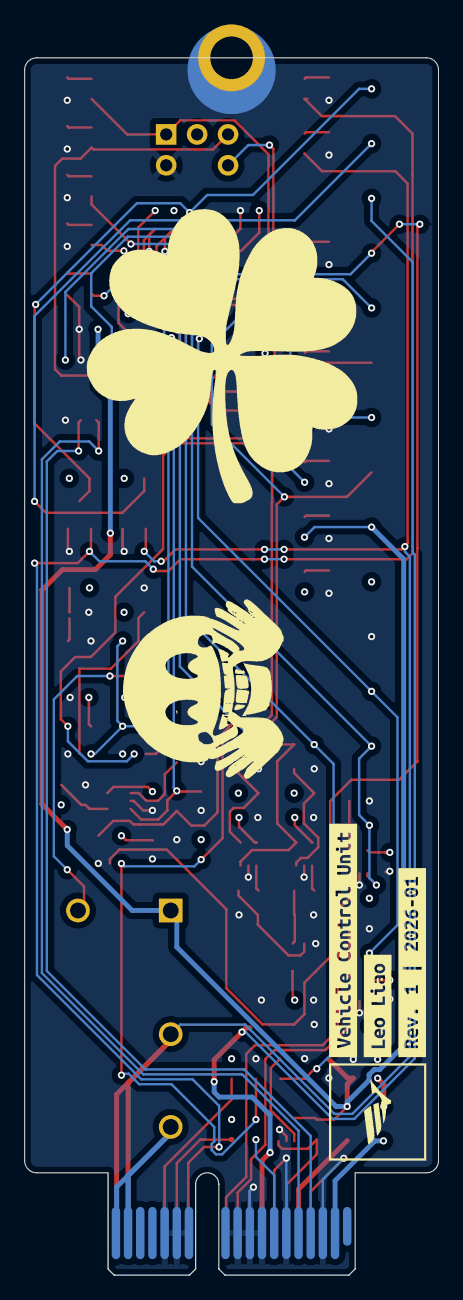
[picture p13: board VCU.kicad_pcb from below]

Board: 4 copper layers, 34.0 x 100.0 mm, 131 parts (3 on the bottom side), 69 nets.

Parts:
C1, C3, C5, C7, C9, C14, C15, C17, C19, C20, C21, C23, C24, C27, C28, C29: C_0.1uF; C_0603_1608Metric
C2: C_10nF; C_0603_1608Metric
C4, C18: C_1uF; C_0603_1608Metric
C6: C_4.7uF; C_0603_1608Metric
C8, C10: C_30pF; C_0603_1608Metric
C11, C26: C_0.1uF_16V; C_0603_1608Metric
C12, C13, C16: C_10uF_10V; C_0603_1608Metric
C22: C_0.22uF_50V; C_0603_1608Metric
C25: C_1uF_25V; C_0603_1608Metric
D1: MOTOR_ON; D_0805_2012Metric
D2: BRAKES; D_0805_2012Metric
D3: BSPD_TRIP; D_0805_2012Metric
D4: HEARTBEAT; D_0805_2012Metric
D5: THROTTLE_DISABLE; D_0805_2012Metric
D6: 5V; D_0805_2012Metric
D7: 3V3; D_0805_2012Metric
D8: NRST; D_0805_2012Metric
D9: SWDIO; D_0805_2012Metric
D10: D_Amber_LED; D_0805_2012Metric
D11: D_36V_500mW; D_SOD-123
D12: BSPD_TRIP_LED; D_0805_2012Metric
D13, D14: D_Blue_LED; D_0805_2012Metric
F1, F2: F_500mA_8V; Fuse_1206_3216Metric
H1: H_MountingHole
J1: J_Programming_Pin_Header; J_Programming_Pin_Header_Keyed
J2: J_PCIe_x1; J_PCIe_x1_Key
K1: K_10A_5V; G5Q1A4DC5 (K_SPST-NO_10A_5V_TH - G5Q-1A4-DC5)
Q1, Q2, Q3, Q4, Q5: SSM3K333R,LF; SOT-23-3
R1, R2, R3, R4, R5, R7, R8, R9, R12: R_200; R_0603_1608Metric
R6, R20, R27, R33: R_1k; R_0603_1608Metric
R10: R_120; R_0603_1608Metric
R11, R13, R15, R17, R22, R23, R24, R26, R28, R32, R34, R35, R36, R39, R42: R_10k; R_0603_1608Metric
R14, R16: R_5.1k; R_0603_1608Metric
R18, R19, R25, R38, R41: R_100k; R_0603_1608Metric
R21: R_71.5k; R_0603_1608Metric
R29: R_75k; R_0603_1608Metric
R30: R_576; R_0603_1608Metric
R31: R_100; R_0603_1608Metric
R37, R40: R_3k; R_0603_1608Metric
R43, R46: R_1M; R_0603_1608Metric
R44, R47: R_0; R_0603_1608Metric
R45, R48: R_2.2k; R_0603_1608Metric
TP1: 5V; TP_Hook_SMD
TP2: 3V3; TP_Hook_SMD
TP3: GND; TP_Hook_SMD
TP4, TP5, TP6, TP7, TP8, TP9, TP10, TP11, TP12, TP13: TP_SMD; TP_Hook_SMD
U1: STM32G441CBT6; LQFP-48_7x7mm_P0.5mm
U2: MCP2561-E_SN; SOIC-8_3.9x4.9mm_P1.27mm
U3, U5, U8, U9, U11, U12: MCP6001T-I/LT; SOT-353_SC-70-5
U4: SN74LVC1G08DBVR; SOT-23-5
U6, U7: SN74LVC1G02DBVR; SOT-23-5
U10: SN74LVC1G32DBVR; SOT-23-5
Y1: X_16MHz_18pF; FA238160000MBC0 (X_16MHz_18pF_SMD - FA-238_16.0000MB-C0)
kibuzzard-6983BE89: G***; kibuzzard-6983BE89
kibuzzard-6983C564: G***; kibuzzard-6983C564
kibuzzard-6983C636: G***; kibuzzard-6983C636

Connections:
+3V3: C1.1, C2.1, C3.1, C4.1, C5.1, C6.1, C7.1, C13.1, C15.2, C17.1, C20.1, C21.1, C23.1, C24.1, C27.1, C28.1, C29.1, F2.1, J1.3, R7.1, R11.1, R12.1, R18.1, R22.1, R25.1, R26.1, R30.1, R32.1, R39.1, R42.1, R43.1, R46.1, TP2.1, U1.20 (VREF+), U1.21 (VDDA), U1.24 (VDD), U1.36 (VDD), U1.48 (VDD), U4.5 (VCC), U5.5 (V+), U6.5 (VCC), U7.5 (VCC), U8.5 (V+), U9.5 (V+), U10.5 (VCC), U11.5 (V+), U12.5 (V+)
+5V: C11.1, C12.1, C14.1, D11.1 (K), F1.1, K1.1, R6.1, R13.1, TP1.1, U2.3 (VDD), U3.5 (V+)
/BSPD/BRAKELIGHT_LL: Q3.1 (G), R19.1, R36.1, TP8.1, U1.30 ((EVENTOUT/SAI1_SCK_A/SAI1_CK2/TIM4_ETR/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), U4.2, U10.4
/BSPD/BSPD_LL: Q2.1 (G), TP6.1, U1.22 ((EVENTOUT/SAI1_SCK_A/TIM1_BKIN/LPUART1_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), U6.4, U7.1
/BSPD/BSPD_RELAY_IN: J2.A17 (SHDN_IN/io_22), J2.A18 (SHDN_IN/io_24), K1.3
/BSPD/BSPD_RELAY_OUT: J2.B17 (SHDN_OUT/io_23), J2.B18 (SHDN_OUT/io_25), K1.2, Q4.1 (G), R37.1, R38.1
/BSPD/MOTOR_CURRENT_SENSE: R14.2, R15.1, R18.2, TP4.1, U1.44 ((EVENTOUT/LPTIM1_IN2/TIM3_CH4/COMP3_OUT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), U4.1
/BSPD/RC_TIMER_STATUS: C16.1, R21.2, U1.12 ((EVENTOUT/SAI1_FS_B/USART2_CK/SPI3_NSS/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), U5.3 (+)
/BrakeLight/BRAKELIGHT_CONN: J2.B8 (io_5), Q3.3 (D), TP9.1
/BrakeLight/BRAKE_PRESS_SENSE: R16.2, R17.1, R29.1, U1.10 ((EVENTOUT/UCPD1_FRSTX2/UCPD1_FRSTX1/LPU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)
/BrakeLight/BRAKE_PRESS_SENSE_FILTERED: C22.1, R29.2, TP7.1, U1.11 ((EVENTOUT/SAI1_MCLK_A/LPUART1_RX/TIM15_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), U8.4 (-), U9.3 (+)
/Microcontroller - STM32G441CBT6 (page 2)/5KW_LED: R1.1, U1.40 ((EVENTOUT/SAI1_SCK_B/TIM3_ETR/USART2_TX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)
/Microcontroller - STM32G441CBT6 (page 2)/BRAKE_LL_LED: R2.1, U1.41 ((EVENTOUT/SAI1_MCLK_B/TIM17_BKIN/USART2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)
/Microcontroller - STM32G441CBT6 (page 2)/BSPD_SHUTDOWN_SENSE: Q4.3 (D), R39.2, TP10.1, U1.27 ((EVENTOUT/LPUART1_CTS/USART3_NSS/USART3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)
/Microcontroller - STM32G441CBT6 (page 2)/BSPD_TRIP_LED: R3.1, U1.42 ((EVENTOUT/SAI1_SD_B/LPTIM1_IN1/TIM17_CH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)
/Microcontroller - STM32G441CBT6 (page 2)/CAN_+: J2.A4 (CAN+), R10.1, U2.7 (CANH)
/Microcontroller - STM32G441CBT6 (page 2)/CAN_-: J2.A5 (CAN-), R10.2, U2.6 (CANL)
/Microcontroller - STM32G441CBT6 (page 2)/CAN_RX: U1.33 ((EVENTOUT/TIM1_BKIN2/TIM1_CH4/TIM4_CH1/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), U2.4 (RXD)
/Microcontroller - STM32G441CBT6 (page 2)/CAN_TX: U1.34 ((EVENTOUT/TIM1_ETR/TIM4_CH2/FDCAN1_TX/C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), U2.1 (TXD)
/Microcontroller - STM32G441CBT6 (page 2)/HEARTBEAT_LED: R4.1, U1.43 ((EVENTOUT/SAI1_FS_B/LPTIM1_ETR/TIM8_BKI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)
/Microcontroller - STM32G441CBT6 (page 2)/NRST: C9.1, J1.4, R8.1, U1.7 ((EVENTOUT/RCC_MCO/GPIO_EXTI10)PG10-NRST)
/Microcontroller - STM32G441CBT6 (page 2)/OUTPUT_THROTTLE_1: R44.1, TP12.1, U1.8 ((EVENTOUT/TIM2_ETR/TIM8_ETR/TIM8_BKIN/C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), U11.1
/Microcontroller - STM32G441CBT6 (page 2)/OUTPUT_THROTTLE_2: R47.1, TP13.1, U1.9 ((EVENTOUT/TIM15_CH1N/USART2_DE/USART2_R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), U12.1
/Microcontroller - STM32G441CBT6 (page 2)/SS_INERTIA_OUTPUT: Q5.3 (D), R42.2, TP11.1, U1.28 ((EVENTOUT/COMP4_OUT/USART3_RTS/USART3_D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)
/Microcontroller - STM32G441CBT6 (page 2)/SWCLK: J1.5, U1.38 ((EVENTOUT/SAI1_FS_B/USART2_TX/TIM1_BKIN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)
/Microcontroller - STM32G441CBT6 (page 2)/SWDIO: J1.1, R9.1, U1.37 ((EVENTOUT/SAI1_SD_B/TIM4_CH3/USART3_NSS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)
/Microcontroller - STM32G441CBT6 (page 2)/THROTTLE_DISABLE: R5.1, U1.29 ((EVENTOUT/SPI2_MOSI/I2S2_SD/TIM1_CH3N/C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)
/PCIe x1 Connector/INPUT_THROTTLE_1: J2.B10 (io_9), R43.2, U11.3 (+)
/PCIe x1 Connector/INPUT_THROTTLE_2: J2.B11 (io_11), R46.2, U12.3 (+)
/PCIe x1 Connector/SS_INERTIA_SWITCH: J2.B12 (io_13), Q5.1 (G), R40.1, R41.1
/PCIe x1 Connector/THROTTLE_1+: J2.B13 (io_15), R11.2
/PCIe x1 Connector/THROTTLE_2+: J2.B14 (io_17), R12.2
GND: C1.2, C2.2, C3.2, C4.2, C5.2, C6.2, C7.2, C8.2, C9.2, C10.2, C11.2, C12.2, C13.2, C14.2, C15.1, C16.2, C17.2, C18.2, C19.1, C20.2, C21.2, C22.2, C23.2, C24.2, C25.2, C26.2, C27.2, C28.2, C29.2, D1.1 (K), D2.1 (K), D3.1 (K), D4.1 (K), D5.1 (K), D6.1 (K), D7.1 (K), D8.1 (K), D9.1 (K), D10.1 (K), D12.1 (K), D13.1 (K), D14.1 (K), H1.1, J1.2, J2.A3 (GND), J2.A6 (io_0), J2.A8 (io_4), J2.A9 (io_6), J2.A10 (io_8), J2.A11 (io_10), J2.A12 (io_12), J2.A13 (io_14), J2.A14 (io_16), J2.B4 (GND), J2.B7 (io_3), J2.B9 (io_7), Q1.2 (S), Q2.2 (S), Q3.2 (S), Q4.2 (S), Q5.2 (S), R15.2, R17.2, R19.2, R23.2, R28.1, R31.2, R33.2, R36.2, R38.2, R41.2, R45.2, R48.2, TP3.1, U1.19 (VSSA), U1.23 (VSS), U1.35 (VSS), U1.47 (VSS), U2.2 (VSS), U2.8 (STBY), U3.2 (V-), U4.3 (GND), U5.2 (V-), U6.3 (GND), U7.3 (GND), U8.2 (V-), U9.2 (V-), U10.3 (GND), U11.2 (V-), U12.2 (V-), Y1.2, Y1.4
unnamed: C18.1, R24.2, U6.1
unnamed: C25.1, R34.2, U10.1
unnamed: C26.1, R35.2, U10.2
unnamed: D1.2 (A), R1.2
unnamed: D2.2 (A), R2.2
unnamed: D3.2 (A), R3.2
unnamed: D4.2 (A), R4.2
unnamed: D5.2 (A), R5.2
unnamed: D6.2 (A), R6.2
unnamed: D7.2 (A), R7.2
unnamed: D8.2 (A), R8.2
unnamed: D9.2 (A), R9.2
unnamed: D10.2 (A), R20.2
unnamed: D11.2 (A), K1.5, Q2.3 (D)
unnamed: D12.2 (A), R27.2
unnamed: D13.2 (A), R37.2
unnamed: D14.2 (A), R40.2
unnamed: F2.2, J2.A2 (3.3V)
unnamed: F1.2, J2.B5 (5V)
unnamed: J2.B6 (io_1), R13.2, U3.3 (+)
unnamed: J2.A7 (io_2), R14.1
unnamed: Q1.3 (D), R25.2, U7.2
unnamed: C19.2, Q1.1 (G), R26.2
unnamed: R20.1, R21.1, TP5.1, U4.4
unnamed: R24.1, U5.1
unnamed: R27.1, R28.2, U6.2, U7.4
unnamed: R34.1, U8.1
unnamed: R35.1, U9.1
unnamed: C8.1, U1.6 ((EVENTOUT/SPI2_SCK/I2S2_CK/GPIO_EXTI1)P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), Y1.1
unnamed: C10.1, U1.5 ((EVENTOUT/TIM1_CH3N/SPI2_NSS/I2S2_WS/I2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), Y1.3
unnamed: R16.1, U3.1, U3.4 (-)
unnamed: R22.2, R23.1, U5.4 (-)
unnamed: R32.2, R33.1, U8.3 (+)
unnamed: R30.2, R31.1, U9.4 (-)
unnamed: R44.2, R45.1, U11.4 (-)
unnamed: R47.2, R48.1, U12.4 (-)
