olin-electric-motorsports/oem-monorepo/vehicle/mkviii/hardware/hv/bms_csc/bms_csc.kicad_pcb

## KiCad design vehicle/mkviii/hardware/hv/bms_csc/bms_csc.kicad_pcb (2026-01-27)

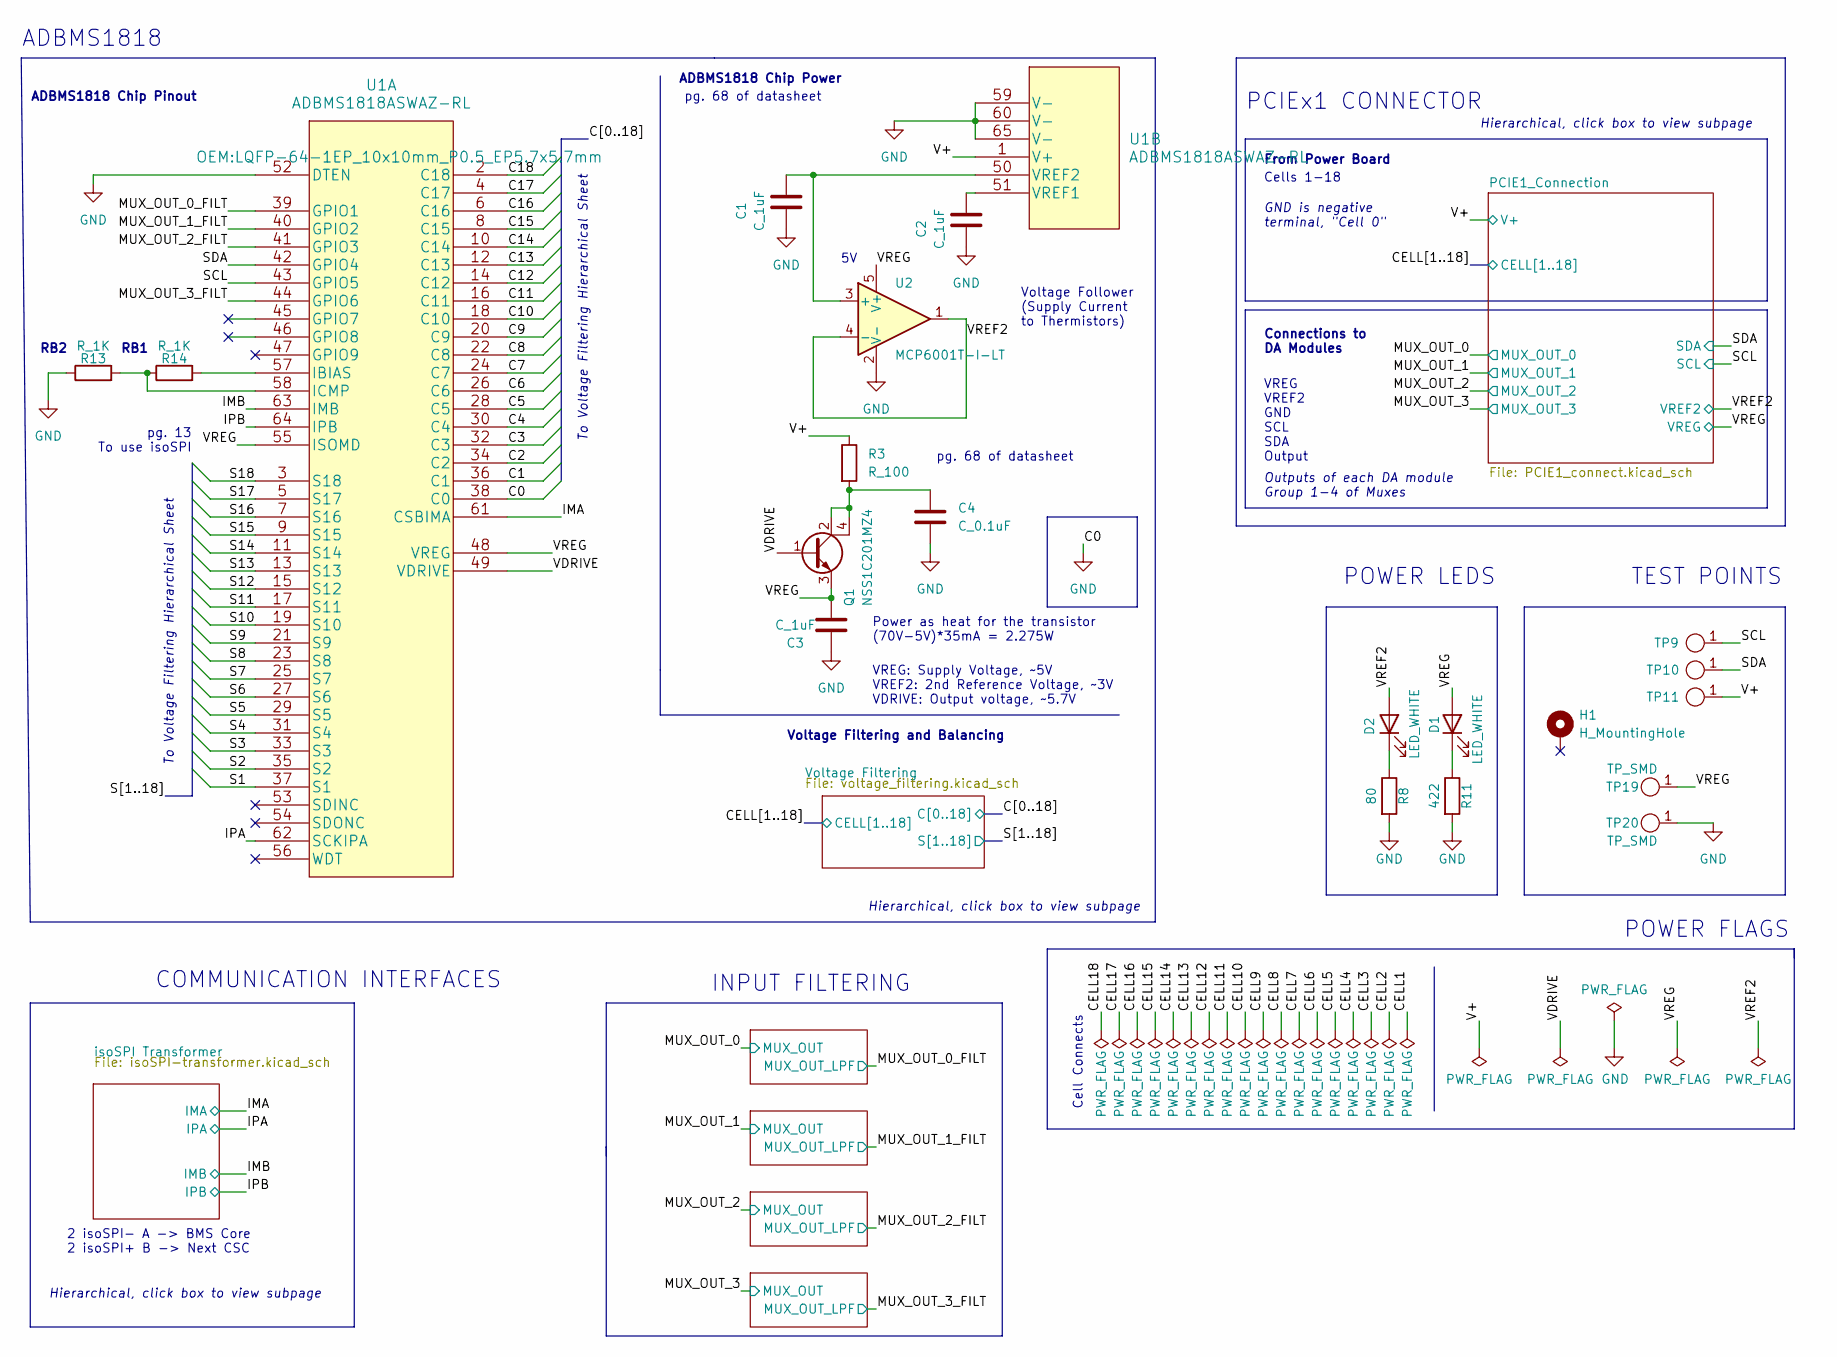
[picture p14: schematic bms_csc.kicad_sch, MkVI BMS Cell Supervisory Circuit]

Parts:
C1, C2, C3: C_1uF; C_0603; MPN CL10B105KA8NNNC
C4: C_0.1uF; C_0603; MPN CL10B104KB8NNWC
D1, D2: LED_WHITE; D_0805_2012Metric; MPN QBLP631-IW
H1: H_MountingHole
Q1: NSS1C201MZ4; SOT230P700X175-4N; MPN NSS1C201MZ4
R3: R_100; R_2512_6332Metric; MPN RMCF0603FT100R
R8: 80; R_0603; MPN RMCF0603FT1K00
R11: 422; R_0603; MPN RMCF0603FT1K00
R13, R14: R_1K; R_0603; MPN RMCF0603FT1K00
TP9, TP10, TP11: TP_1mm; Test_Point_SMD
TP19, TP20: TP_SMD; Test_Point_SMD; MPN 5019
U1: ADBMS1818ASWAZ-RL; LQFP-64-1EP_10x10mm_P0.5_EP5.7x5.7mm; MPN ADBMS1818ASWAZ-RL
U2: MCP6001T-I-LT; SOT-353_SC-70-5; MPN MCP6001T-I/OT

Connections:
/C1: U1.36 (C1); also elsewhere on the board
/C2: U1.34 (C2); also elsewhere on the board
/C3: U1.32 (C3); also elsewhere on the board
/C4: U1.30 (C4); also elsewhere on the board
/C5: U1.28 (C5); also elsewhere on the board
/C6: U1.26 (C6); also elsewhere on the board
/C7: U1.24 (C7); also elsewhere on the board
/C8: U1.22 (C8); also elsewhere on the board
/C9: U1.20 (C9); also elsewhere on the board
/C10: U1.18 (C10); also elsewhere on the board
/C11: U1.16 (C11); also elsewhere on the board
/C12: U1.14 (C12); also elsewhere on the board
/C13: U1.12 (C13); also elsewhere on the board
/C14: U1.10 (C14); also elsewhere on the board
/C15: U1.8 (C15); also elsewhere on the board
/C16: U1.6 (C16); also elsewhere on the board
/C17: U1.4 (C17); also elsewhere on the board
/C18: U1.2 (C18); also elsewhere on the board
/IMA: U1.61 (CSBIMA); also elsewhere on the board
/IMB: U1.63 (IMB); also elsewhere on the board
/IPA: U1.62 (SCKIPA); also elsewhere on the board
/IPB: U1.64 (IPB); also elsewhere on the board
/MUX_OUT_0_FILT: U1.39 (GPIO1); also elsewhere on the board
/MUX_OUT_1_FILT: U1.40 (GPIO2); also elsewhere on the board
/MUX_OUT_2_FILT: U1.41 (GPIO3); also elsewhere on the board
/MUX_OUT_3_FILT: U1.44 (GPIO6); also elsewhere on the board
/S1: U1.37 (S1); also elsewhere on the board
/S2: U1.35 (S2); also elsewhere on the board
/S3: U1.33 (S3); also elsewhere on the board
/S4: U1.31 (S4); also elsewhere on the board
/S5: U1.29 (S5); also elsewhere on the board
/S6: U1.27 (S6); also elsewhere on the board
/S7: U1.25 (S7); also elsewhere on the board
/S8: U1.23 (S8); also elsewhere on the board
/S9: U1.21 (S9); also elsewhere on the board
/S10: U1.19 (S10); also elsewhere on the board
/S11: U1.17 (S11); also elsewhere on the board
/S12: U1.15 (S12); also elsewhere on the board
/S13: U1.13 (S13); also elsewhere on the board
/S14: U1.11 (S14); also elsewhere on the board
/S15: U1.9 (S15); also elsewhere on the board
/S16: U1.7 (S16); also elsewhere on the board
/S17: U1.5 (S17); also elsewhere on the board
/S18: U1.3 (S18); also elsewhere on the board
/SCL: TP9.1, U1.43 (GPIO5); also elsewhere on the board
/SDA: TP10.1, U1.42 (GPIO4); also elsewhere on the board
/V+: R3.1, TP11.1, U1.1 (V+); also elsewhere on the board
/VDRIVE: Q1.1 (B), U1.49 (VDRIVE)
/VREF2: D2.2 (A), U2.1, U2.4 (-); also elsewhere on the board
/VREG: C3.2, D1.2 (A), Q1.3 (E), TP19.1, U1.48 (VREG), U1.55 (ISOMD), U2.5 (V+); also elsewhere on the board
unnamed: C4.1, Q1.2 (C), Q1.4 (C), R3.2
unnamed: D1.1 (K), R11.1
unnamed: D2.1 (K), R8.1
unnamed: R14.2, U1.57 (IBIAS)
unnamed: R13.2, R14.1, U1.58 (ICMP)
unnamed: C2.2, U1.51 (VREF1)
unnamed: C1.2, U1.50 (VREF2), U2.3 (+)

Notes on the sheet:
RB2
Hierarchical, click box to view subpage
INPUT FILTERING
From Power Board
Power as heat for the transistor (70V-5V)*35mA = 2.275W
pg. 68 of datasheet
Cells 1-18
ADBMS1818 Chip Pinout
Outputs of each DA module Group 1-4 of Muxes
2 isoSPI- A -> BMS Core 2 isoSPI+ B -> Next CSC
COMMUNICATION INTERFACES
pg. 13 To use isoSPI
Voltage Filtering and Balancing
Voltage Follower (Supply Current to Thermistors)
ADBMS1818 Chip Power
VREG VREF2 GND SCL SDA Output
VREG: Supply Voltage, ~5V VREF2: 2nd Reference Voltage, ~3V VDRIVE: Output voltage, ~5.7V
Connections to DA Modules
ADBMS1818
Cell Connects
POWER FLAGS
PCIEx1 CONNECTOR
RB1
POWER LEDS
GND is negative terminal, "Cell 0"
To Voltage Filtering Hierarchical Sheet
TEST POINTS

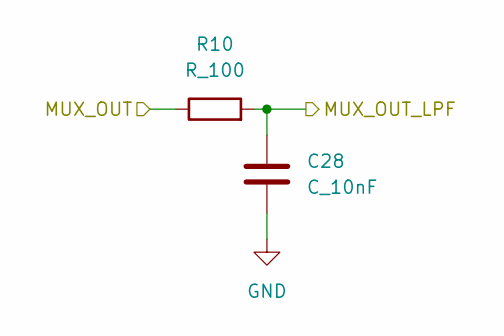
[picture p15: schematic mux_input_lpfs.kicad_sch]

Parts:
C28: C_10nF; C_0603; MPN CL10B104KB8NNWC
R10: R_100; R_0603; MPN RMCF0603FT100R

Connections:
/MUX_OUT_1: R10.1; also elsewhere on the board
/MUX_OUT_1_FILT: C28.1, R10.2; also elsewhere on the board

Parts of its further copies:
C27, C29, C30: C_10nF; C_0603; MPN CL10B104KB8NNWC
R9, R12, R51: R_100; R_0603; MPN RMCF0603FT100R

Connections of its further copies:
/MUX_OUT_0: R9.1; also elsewhere on the board
/MUX_OUT_0_FILT: C27.1, R9.2; also elsewhere on the board
/MUX_OUT_2: R12.1; also elsewhere on the board
/MUX_OUT_2_FILT: C29.1, R12.2; also elsewhere on the board
/MUX_OUT_3: R51.1; also elsewhere on the board
/MUX_OUT_3_FILT: C30.1, R51.2; also elsewhere on the board

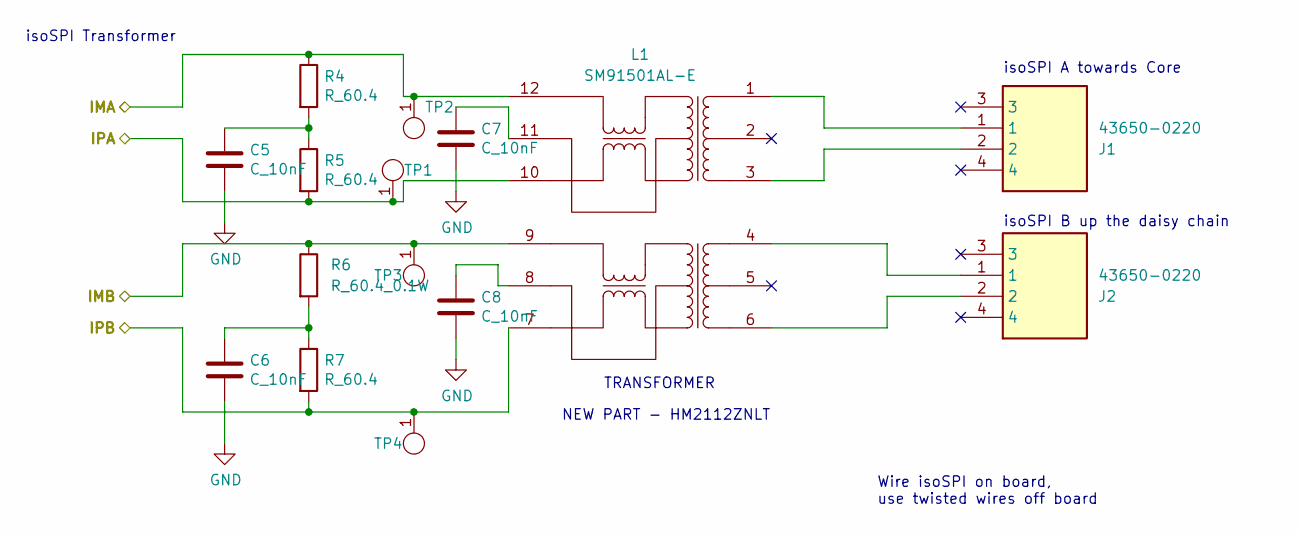
[picture p16: schematic isoSPI-transformer.kicad_sch, MkVI BMS Cell Supervisory Circuit]

Parts:
C5, C6, C7, C8: C_10nF; C_0603; MPN CL10B103KB8NNNC
J1, J2: 43650-0220; 43650-02YY_18192063; Manufacturer_Part_Number 43650-0220; Mouser Part Number 538-43650-0220
L1: SM91501AL-E; SOP200P1473X500-12N (L_BMS-isoSPI-Transformer_SM91501AL-E_S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; MPN SM91501AL-E
R4, R5, R7: R_60.4; R_0603; MPN RMCF0603FT60R4
R6: R_60.4_0.1W; R_0603_1608Metric; MPN RMCF0603FT60R4
TP1, TP2, TP3, TP4: TP_SMD; Test_Point_SMD; MPN 5019

Connections:
/IMA: L1.12, R4.1, TP2.1; also elsewhere on the board
/IMB: L1.9, R6.1, TP3.1; also elsewhere on the board
/IPA: L1.10, R5.2, TP1.1; also elsewhere on the board
/IPB: L1.7, R7.2, TP4.1; also elsewhere on the board
unnamed: C5.1, R4.2, R5.1
unnamed: C6.1, R6.2, R7.1
unnamed: C7.1, L1.11
unnamed: C8.1, L1.8
unnamed: J1.1, L1.1
unnamed: J1.2, L1.3
unnamed: J2.1, L1.4
unnamed: J2.2, L1.6

Notes on the sheet:
isoSPI B up the daisy chain
TRANSFORMER
isoSPI Transformer
NEW PART - HM2112ZNLT
isoSPI A towards Core
Wire isoSPI on board, use twisted wires off board

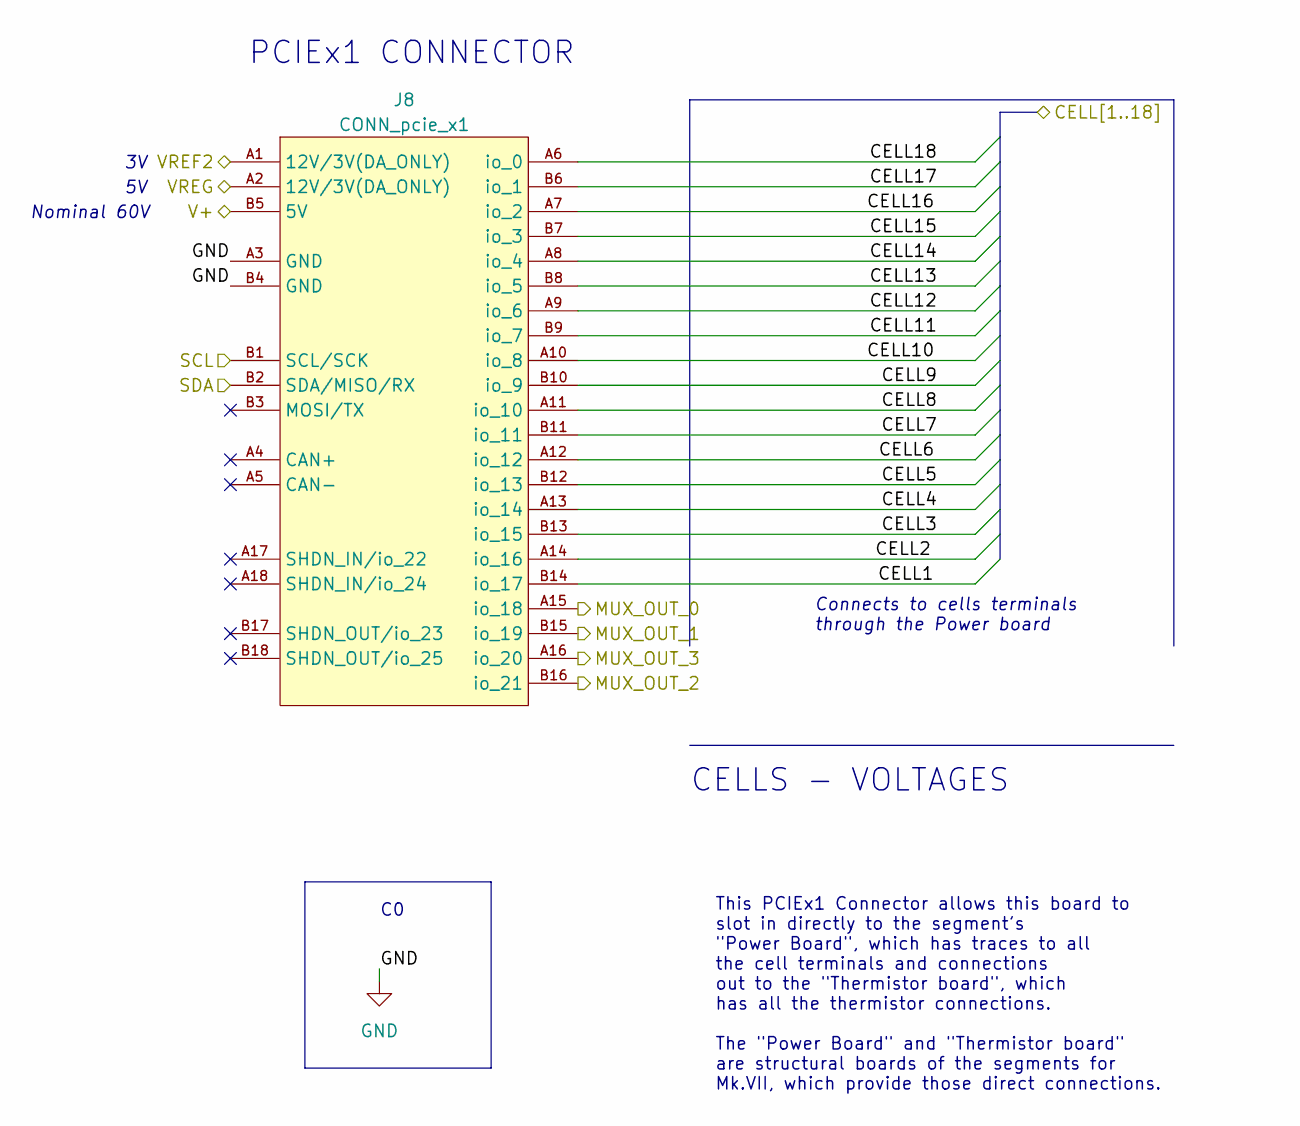
[picture p17: schematic PCIE1_connect.kicad_sch]

Parts:
J8: CONN_pcie_x1; pcie_x1

Connections:
/CELL1: J8.B14 (io_17); also elsewhere on the board
/CELL2: J8.A14 (io_16); also elsewhere on the board
/CELL3: J8.B13 (io_15); also elsewhere on the board
/CELL4: J8.A13 (io_14); also elsewhere on the board
/CELL5: J8.B12 (io_13); also elsewhere on the board
/CELL6: J8.A12 (io_12); also elsewhere on the board
/CELL7: J8.B11 (io_11); also elsewhere on the board
/CELL8: J8.A11 (io_10); also elsewhere on the board
/CELL9: J8.B10 (io_9); also elsewhere on the board
/CELL10: J8.A10 (io_8); also elsewhere on the board
/CELL11: J8.B9 (io_7); also elsewhere on the board
/CELL12: J8.A9 (io_6); also elsewhere on the board
/CELL13: J8.B8 (io_5); also elsewhere on the board
/CELL14: J8.A8 (io_4); also elsewhere on the board
/CELL15: J8.B7 (io_3); also elsewhere on the board
/CELL16: J8.A7 (io_2); also elsewhere on the board
/CELL17: J8.B6 (io_1); also elsewhere on the board
/CELL18: J8.A6 (io_0); also elsewhere on the board
/MUX_OUT_0: J8.A15 (io_18); also elsewhere on the board
/MUX_OUT_1: J8.B15 (io_19); also elsewhere on the board
/MUX_OUT_2: J8.B16 (io_21); also elsewhere on the board
/MUX_OUT_3: J8.A16 (io_20); also elsewhere on the board
/SCL: J8.B1 (SCL/SCK); also elsewhere on the board
/SDA: J8.B2 (SDA/MISO/RX); also elsewhere on the board
/V+: J8.B5 (5V); also elsewhere on the board
/VREF2: J8.A1 (12V/3V(DA_ONLY)); also elsewhere on the board
/VREG: J8.A2 (12V/3V(DA_ONLY)); also elsewhere on the board

Notes on the sheet:
This PCIEx1 Connector allows this board to slot in directly to the segment's "Power Board", which has traces to all the cell terminals and connections out to the "Thermistor board", which has all the thermistor connections. The "Power Board" and "Thermistor board" are structural boards of the segme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
CELLS - VOLTAGES
PCIEx1 CONNECTOR
Connects to cells terminals through the Power board
Nominal 60V

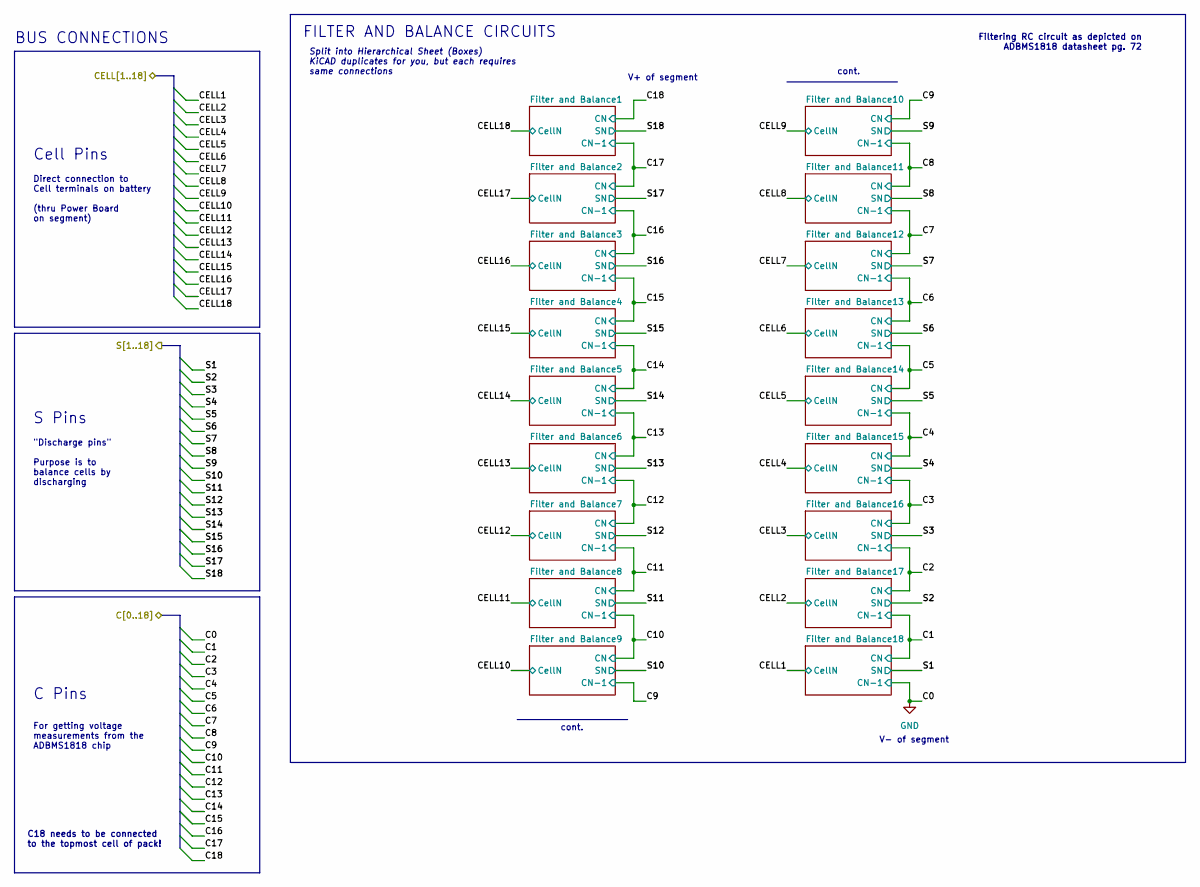
[picture p18: schematic voltage_filtering.kicad_sch, MkVI BMS Cell Supervisory Circuit]

Notes on the sheet:
BUS CONNECTIONS
C18 needs to be connected to the topmost cell of pack!
For getting voltage measurements from the ADBMS1818 chip
cont.
Cell Pins
Direct connection to Cell terminals on battery (thru Power Board on segment)
C Pins
V+ of segment
Filtering RC circuit as depicted on ADBMS1818 datasheet pg. 72
V- of segment
FILTER AND BALANCE CIRCUITS
S Pins
"Discharge pins" Purpose is to balance cells by discharging
Split into Hierarchical Sheet (Boxes) KiCAD duplicates for you, but each requires same connections

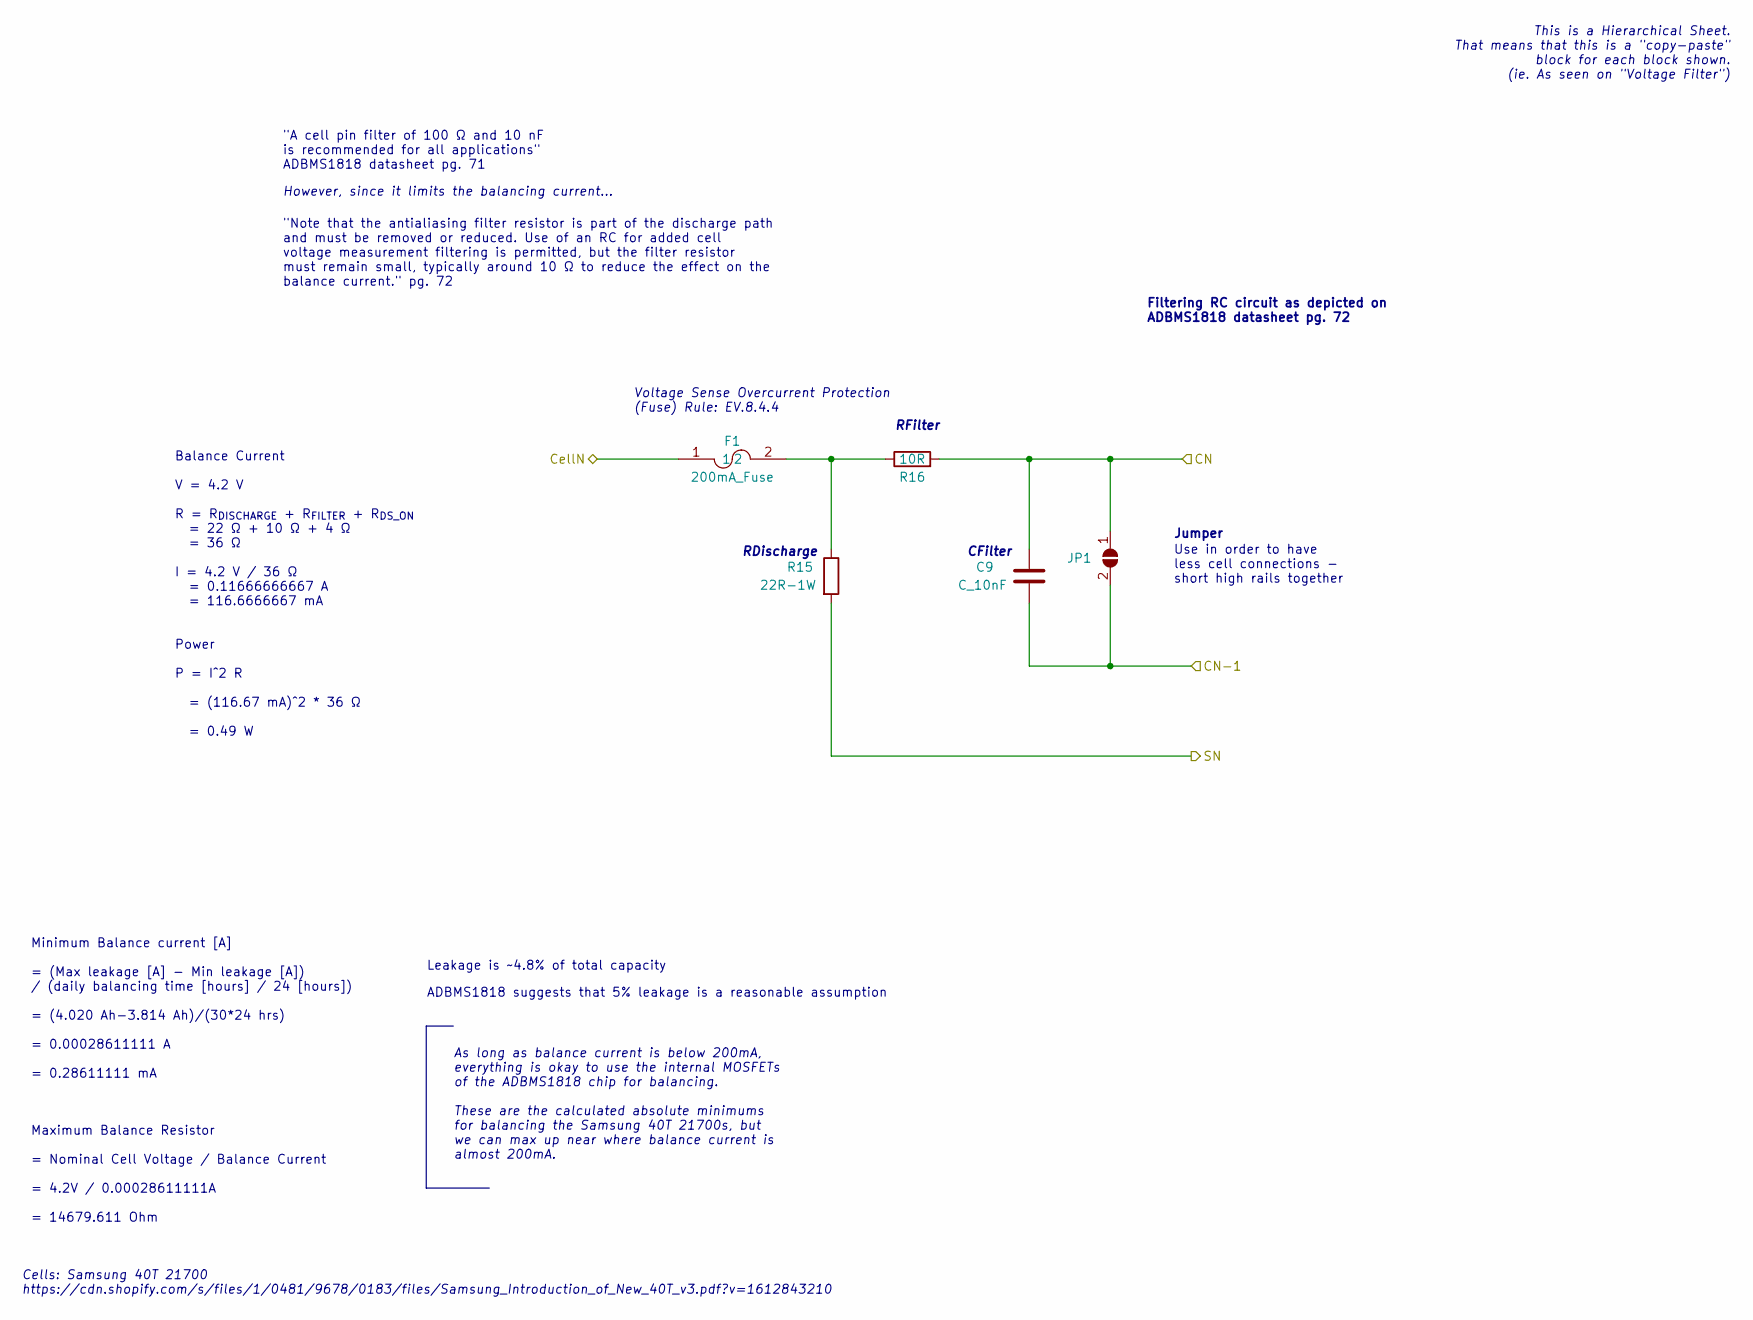
[picture p19: schematic filter-balance.kicad_sch, MkVI BMS Cell Supervisory Circuit]

Parts:
C9: C_10nF; C_0603; MPN CL10B103KB8NNNC
F1: 200mA_Fuse; Fuse_1206_3216Metric; MPN 0466.200NRHF
JP1: SolderJumper_2_Open; SolderJumper-2_P1.3mm_Open_TrianglePad1.0x1.5mm
R15: 22R-1W; R_2512_6332Metric; MPN 352022RJT
R16: 10R; R_0603; MPN SG73P1JTTD100J

Connections:
/C15: C9.2, JP1.2 (B); also elsewhere on the board
/C16: C9.1, JP1.1 (A), R16.2; also elsewhere on the board
/CELL16: F1.1; also elsewhere on the board
/S16: R15.2; also elsewhere on the board
unnamed: F1.2, R15.1, R16.1

Parts of its further copies:
C10, C11, C12, C13, C14, C15, C16, C17, C18, C19, C20, C21, C22, C23, C24, C25, C26: C_10nF; C_0603; MPN CL10B103KB8NNNC
F2, F3, F4, F5, F6, F7, F8, F9, F10, F11, F12, F13, F14, F15, F16, F17, F18: 200mA_Fuse; Fuse_1206_3216Metric; MPN 0466.200NRHF
JP2, JP3, JP4, JP5, JP6, JP7, JP8, JP9, JP10, JP11, JP12, JP13, JP14, JP15, JP16, JP17, JP18: SolderJumper_2_Open; SolderJumper-2_P1.3mm_Open_TrianglePad1.0x1.5mm
R17, R19, R21, R23, R25, R27, R29, R31, R33, R35, R37, R39, R41, R43, R45, R47, R49: 22R-1W; R_2512_6332Metric; MPN 352022RJT
R18, R20, R22, R24, R26, R28, R30, R32, R34, R36, R38, R40, R42, R44, R46, R48, R50: 10R; R_0603; MPN SG73P1JTTD100J

Connections of its further copies:
/C1: C25.2, C26.1, JP17.2 (B), JP18.1 (A), R50.2; also elsewhere on the board
/C2: C24.2, C25.1, JP16.2 (B), JP17.1 (A), R48.2; also elsewhere on the board
/C3: C23.2, C24.1, JP15.2 (B), JP16.1 (A), R46.2; also elsewhere on the board
/C4: C22.2, C23.1, JP14.2 (B), JP15.1 (A), R44.2; also elsewhere on the board
/C5: C21.2, C22.1, JP13.2 (B), JP14.1 (A), R42.2; also elsewhere on the board
/C6: C20.2, C21.1, JP12.2 (B), JP13.1 (A), R40.2; also elsewhere on the board
/C7: C19.2, C20.1, JP11.2 (B), JP12.1 (A), R38.2; also elsewhere on the board
/C8: C18.2, C19.1, JP10.2 (B), JP11.1 (A), R36.2; also elsewhere on the board
/C9: C17.2, C18.1, JP9.2 (B), JP10.1 (A), R34.2; also elsewhere on the board
/C10: C16.2, C17.1, JP8.2 (B), JP9.1 (A), R32.2; also elsewhere on the board
/C11: C15.2, C16.1, JP7.2 (B), JP8.1 (A), R30.2; also elsewhere on the board
/C12: C14.2, C15.1, JP6.2 (B), JP7.1 (A), R28.2; also elsewhere on the board
/C13: C13.2, C14.1, JP5.2 (B), JP6.1 (A), R26.2; also elsewhere on the board
/C14: C12.2, C13.1, JP4.2 (B), JP5.1 (A), R24.2; also elsewhere on the board
/C15: C12.1, JP4.1 (A), R22.2; also elsewhere on the board
/C16: C11.2, JP3.2 (B); also elsewhere on the board
/C17: C10.2, C11.1, JP2.2 (B), JP3.1 (A), R20.2; also elsewhere on the board
/C18: C10.1, JP2.1 (A), R18.2; also elsewhere on the board
/CELL1: F18.1; also elsewhere on the board
/CELL2: F17.1; also elsewhere on the board
/CELL3: F16.1; also elsewhere on the board
/CELL4: F15.1; also elsewhere on the board
/CELL5: F14.1; also elsewhere on the board
/CELL6: F13.1; also elsewhere on the board
/CELL7: F12.1; also elsewhere on the board
/CELL8: F11.1; also elsewhere on the board
/CELL9: F10.1; also elsewhere on the board
/CELL10: F9.1; also elsewhere on the board
/CELL11: F8.1; also elsewhere on the board
/CELL12: F7.1; also elsewhere on the board
/CELL13: F6.1; also elsewhere on the board
/CELL14: F5.1; also elsewhere on the board
/CELL15: F4.1; also elsewhere on the board
/CELL17: F3.1; also elsewhere on the board
/CELL18: F2.1; also elsewhere on the board
/S1: R49.2; also elsewhere on the board
/S2: R47.2; also elsewhere on the board
/S3: R45.2; also elsewhere on the board
/S4: R43.2; also elsewhere on the board
/S5: R41.2; also elsewhere on the board
/S6: R39.2; also elsewhere on the board
/S7: R37.2; also elsewhere on the board
/S8: R35.2; also elsewhere on the board
/S9: R33.2; also elsewhere on the board
/S10: R31.2; also elsewhere on the board
/S11: R29.2; also elsewhere on the board
/S12: R27.2; also elsewhere on the board
/S13: R25.2; also elsewhere on the board
/S14: R23.2; also elsewhere on the board
/S15: R21.2; also elsewhere on the board
/S17: R19.2; also elsewhere on the board
/S18: R17.2; also elsewhere on the board
unnamed: F2.2, R17.1, R18.1
unnamed: F3.2, R19.1, R20.1
unnamed: F4.2, R21.1, R22.1
unnamed: F5.2, R23.1, R24.1
unnamed: F6.2, R25.1, R26.1
unnamed: F7.2, R27.1, R28.1
unnamed: F8.2, R29.1, R30.1
unnamed: F9.2, R31.1, R32.1
unnamed: F10.2, R33.1, R34.1
unnamed: F11.2, R35.1, R36.1
unnamed: F12.2, R37.1, R38.1
unnamed: F13.2, R39.1, R40.1
unnamed: F14.2, R41.1, R42.1
unnamed: F15.2, R43.1, R44.1
unnamed: F16.2, R45.1, R46.1
unnamed: F17.2, R47.1, R48.1
unnamed: F18.2, R49.1, R50.1

Notes on the sheet:
RDischarge
Leakage is ~4.8% of total capacity
Use in order to have less cell connections - short high rails together
"A cell pin filter of 100 Ω and 10 nF is recommended for all applications" ADBMS1818 datasheet pg. 71
This is a Hierarchical Sheet. That means that this is a "copy-paste" block for each block shown. (ie. As seen on "Voltage Filter")
CFilter
"Note that the antialiasing filter resistor is part of the discharge path and must be removed or reduced. Use of an RC for added cell voltage measurement filtering is permitted, but the filter resistor must remain small, typically around 10 Ω to reduce the effect on the balance current." pg. 72
Maximum Balance Resistor = Nominal Cell Voltage / Balance Current = 4.2V / 0.00028611111A = 14679.611 Ohm
However, since it limits the balancing current...
Minimum Balance current [A] = (Max leakage [A] - Min leakage [A]) / (daily balancing time [hours] / 24 [hours]) = (4.020 Ah-3.814 Ah)/(30*24 hrs) = 0.00028611111 A = 0.28611111 mA
ADBMS1818 suggests that 5% leakage is a reasonable assumption
Jumper
Voltage Sense Overcurrent Protection (Fuse) Rule: EV.8.4.4
As long as balance current is below 200mA, everything is okay to use the internal MOSFETs of the ADBMS1818 chip for balancing. These are the calculated absolute minimums for balancing the Samsung 40T 21700s, but we can max up near where balance current is almost 200mA.
Filtering RC circuit as depicted on ADBMS1818 datasheet pg. 72
RFilter
Balance Current V = 4.2 V R = R_{DISCHARGE} + R_{FILTER} + R_{DS_ON} = 22 Ω + 10 Ω + 4 Ω = 36 Ω I = 4.2 V / 36 Ω = 0.11666666667 A = 116.6666667 mA Power P = I^2 R = (116.67 mA)^2 * 36 Ω = 0.49 W
Cells: Samsung 40T 21700 https://cdn.shopify.com/s/files/1/0481/9678/0183/files/Samsung_Introduction_of_New_40T_v3.pdf?v=1612843210

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
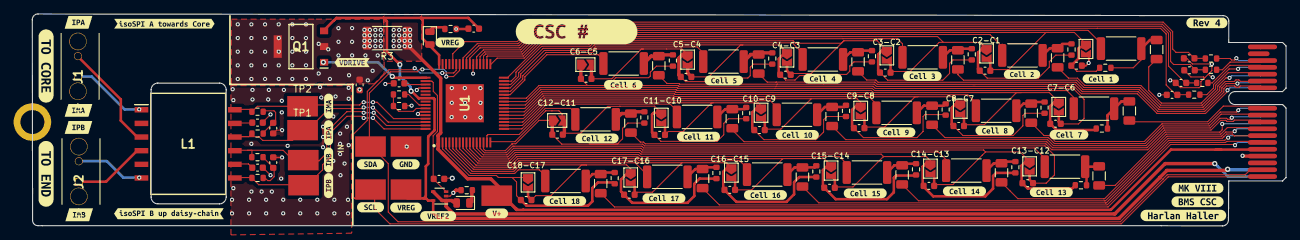
[picture p20: board bms_csc.kicad_pcb from above]

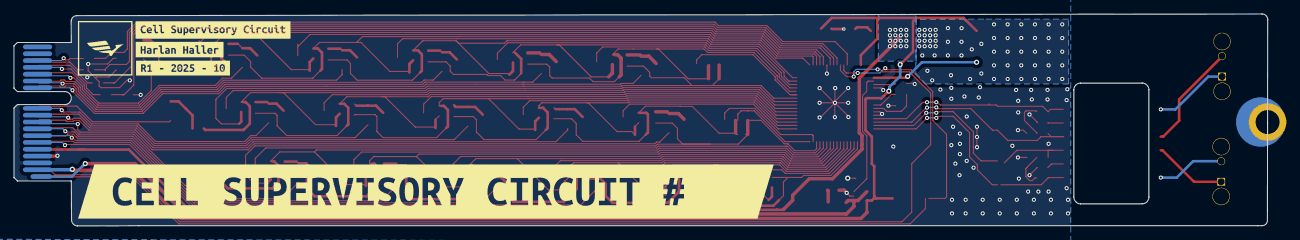
[picture p21: board bms_csc.kicad_pcb from below]

Board: 2 copper layers, 183.7 x 31.1 mm, 181 parts (4 on the bottom side), 106 nets.

Other parts of the board:
kibuzzard-63B4D82F: G***; kibuzzard-63B4D82F
kibuzzard-63B4D834: G***; kibuzzard-63B4D834
kibuzzard-63B4E58E: G***; kibuzzard-63B4E58E
kibuzzard-63B4E59A: G***; kibuzzard-63B4E59A
kibuzzard-63B4E581: G***; kibuzzard-63B4E581
kibuzzard-63B4E593: G***; kibuzzard-63B4E593
kibuzzard-63B4EB9B: G***; kibuzzard-63B4EB9B
kibuzzard-63B4EBA9: G***; kibuzzard-63B4EBA9
kibuzzard-63B4EBAD: G***; kibuzzard-63B4EBAD
kibuzzard-63B4EBB3: G***; kibuzzard-63B4EBB3
kibuzzard-63B4EBB8: G***; kibuzzard-63B4EBB8
kibuzzard-63B4EBF9: G***; kibuzzard-63B4EBF9
kibuzzard-63B4EC1B: G***; kibuzzard-63B4EC1B
kibuzzard-63B4EC4E: G***; kibuzzard-63B4EC4E
kibuzzard-63B4EC5B: G***; kibuzzard-63B4EC5B
kibuzzard-63B4EC6B: G***; kibuzzard-63B4EC6B
kibuzzard-63B4EC7A: G***; kibuzzard-63B4EC7A
kibuzzard-63B4EC20: G***; kibuzzard-63B4EC20
kibuzzard-63B4EC53: G***; kibuzzard-63B4EC53
kibuzzard-63B4EC66: G***; kibuzzard-63B4EC66
kibuzzard-63B4EC74: G***; kibuzzard-63B4EC74
kibuzzard-63B4EC80: G***; kibuzzard-63B4EC80
kibuzzard-63B4ED2A: G***; kibuzzard-63B4ED2A
kibuzzard-63B4ED25: G***; kibuzzard-63B4ED25
kibuzzard-63B4ED94: G***; kibuzzard-63B4ED94
kibuzzard-673A717E: G***; kibuzzard-673A717E
kibuzzard-673A718C: G***; kibuzzard-673A718C
kibuzzard-673A725C: G***; kibuzzard-673A725C
kibuzzard-673A7176: G***; kibuzzard-673A7176
kibuzzard-673A7184: G***; kibuzzard-673A7184
kibuzzard-673AA1F5: G***; kibuzzard-673AA1F5
kibuzzard-673AA1FB: G***; kibuzzard-673AA1FB
kibuzzard-673AA20C: G***; kibuzzard-673AA20C
kibuzzard-673AA233: G***; kibuzzard-673AA233
kibuzzard-691FAACE: G***; kibuzzard-691FAACE
kibuzzard-6736A7FC: G***; kibuzzard-6736A7FC
kibuzzard-6736A805: G***; kibuzzard-6736A805
kibuzzard-6736A828: G***; kibuzzard-6736A828
kibuzzard-6736A857: G***; kibuzzard-6736A857
kibuzzard-6736A863: G***; kibuzzard-6736A863
kibuzzard-6902CBBF: G***; kibuzzard-6902CBBF
kibuzzard-6902E3D6: G***; kibuzzard-6902E3D6
kibuzzard-673993C6: G***; kibuzzard-673993C6
kibuzzard-673998AC: G***; kibuzzard-673998AC
kibuzzard-69001352: G***; kibuzzard-69001352
kibuzzard-69001366: G***; kibuzzard-69001366
kibuzzard-69001374: G***; kibuzzard-69001374
