olin-electric-motorsports/oem-monorepo/vehicle/examples/hardware/stm32_g4_dev_board/stm32g441kbt6 development.kicad_pcb

## KiCad design vehicle/examples/hardware/stm32_g4_dev_board/stm32g441kbt6 development.kicad_pcb (2026-01-25)

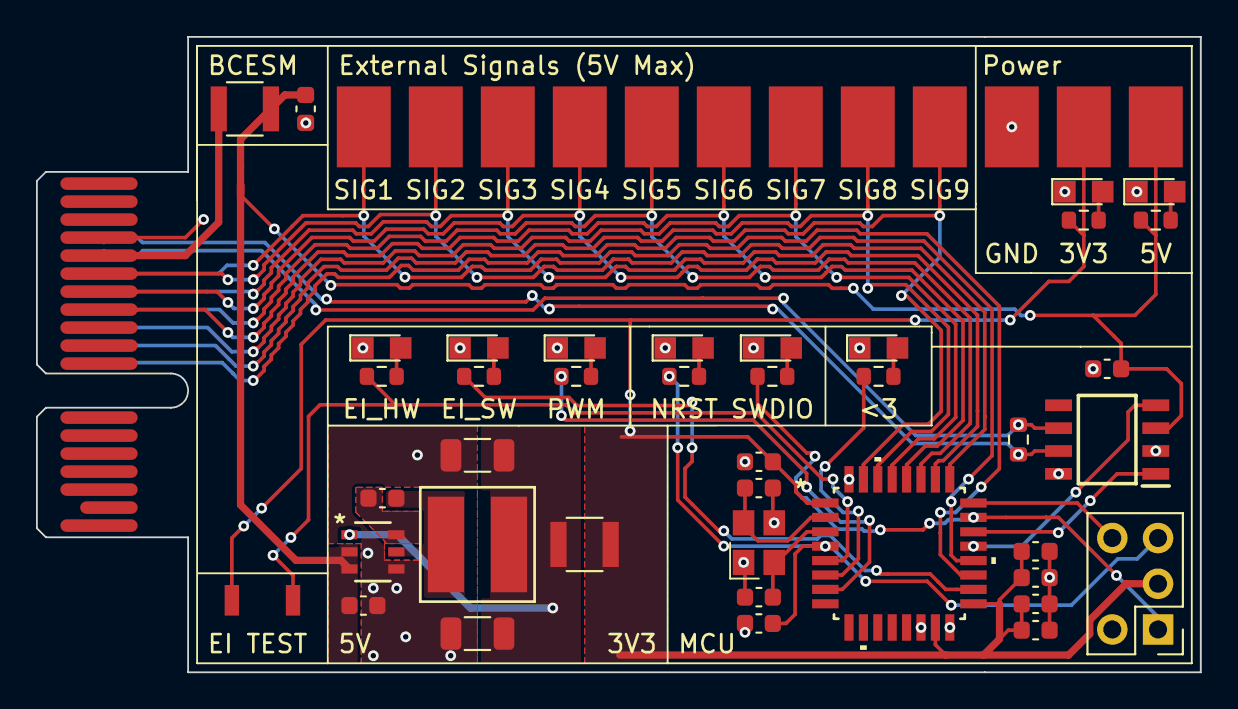
[picture p22: board stm32g441kbt6 development.kicad_pcb from above]

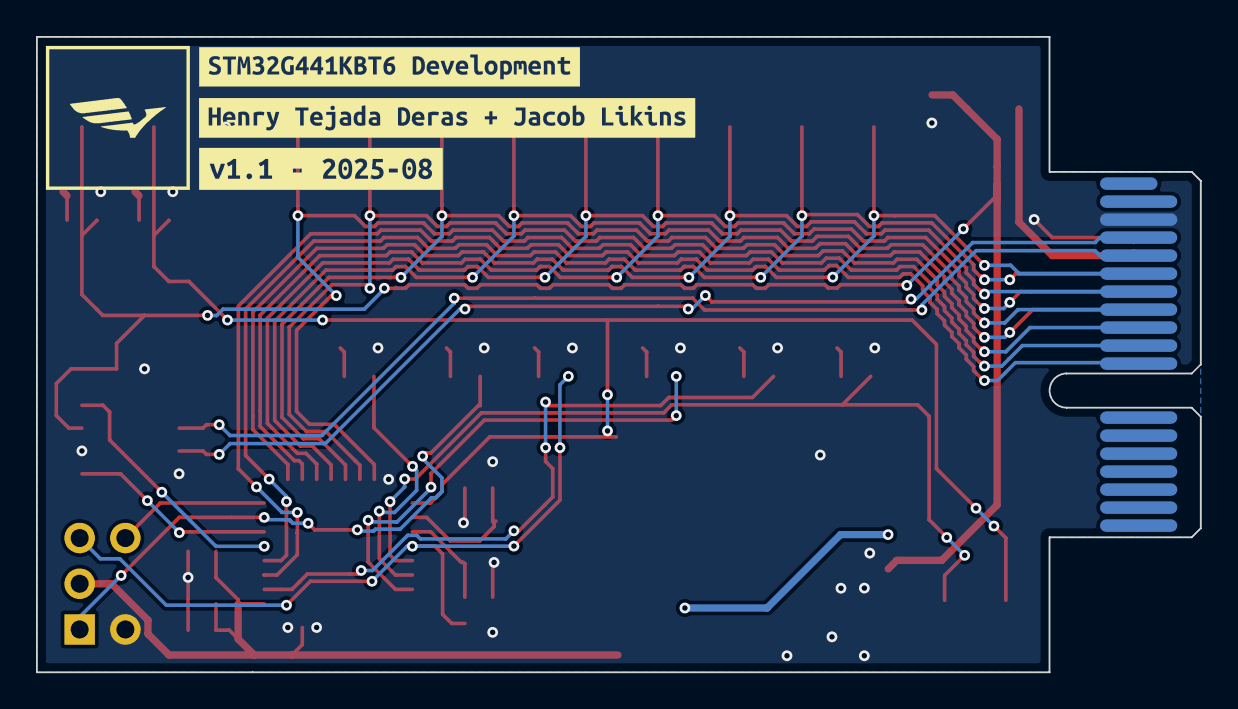
[picture p23: board stm32g441kbt6 development.kicad_pcb from below]

Board: 2 copper layers, 64.7 x 35.3 mm, 56 parts (3 on the bottom side), 37 nets.

Parts:
C1, C2, C5, C6, C11: C_0.1uF; C_0603
C3: C_10nF; C_0603
C4: C_1uF; C_0603
C7: C_4.7uF; C_0603
C8, C12: C_10uF; C_0603
C9, C10: C_22uF; C_1206_3216Metric
C13, C14: C_30pF; C_0603
D1: 3V3 POWER; CHIPLED_0805
D2: 5V POWER; CHIPLED_0805
D3: HEARTBEAT; CHIPLED_0805
D4: NRST; CHIPLED_0805
D5: SWDIO; CHIPLED_0805
D6: INTERRUPT_TEST_HW; CHIPLED_0805
D7: INTERRUPT_TEST_SW; CHIPLED_0805
D8: PWM_TEST; CHIPLED_0805
F1, F2: F_500mA_16V; Fuse_1210
J1: CONN_pcie_x1; pcie_x1
J2: Programming_Pin_Header; Programming_Pin_Header_Keyed
L1: L_3.9uH; IND_BOURNS_SRR5018
R1: R_120; R_0603
R2, R3, R4, R5, R6, R7, R8, R9: R_1K; R_0603
SW1: INTERRUPT TEST SWITCH; SW_B3U-1000P_4.2x1.7mm
TP1: 3V3; Test_Point_SMD
TP2: 5V; Test_Point_SMD
TP3: EXT_SIG_1; Test_Point_SMD
TP4: EXT_SIG_2; Test_Point_SMD
TP5: EXT_SIG_3; Test_Point_SMD
TP6: EXT_SIG_4; Test_Point_SMD
TP7: EXT_SIG_5; Test_Point_SMD
TP8: EXT_SIG_6; Test_Point_SMD
TP9: EXT_SIG_7; Test_Point_SMD
TP10: EXT_SIG_8; Test_Point_SMD
TP11: EXT_SIG_9; Test_Point_SMD
TP12: GND; Test_Point_SMD
U1: STM32G441KBT6
U2: MCP2561-E_SN; SOIC127P600X175-8N
U3: AP63203WU-7; AP63203WU-7_DIO
Y1: X_Crystal_16MHz_18pF; Crystal_TXC7M
kibuzzard-68A62DAB: G***; kibuzzard-68A62DAB
kibuzzard-68A62DD1: G***; kibuzzard-68A62DD1
kibuzzard-68A78CB4: G***; kibuzzard-68A78CB4

Connections:
+3V3: C3.1, C4.1, C5.1, C6.1, C7.1, F2.2, J2.3, R2.1, SW1.1, TP1.1, U1.1 (VDD), U1.15 (VDDA), U1.17 (VDD)
+5V: C1.2, C8.1, C12.1, F1.1, R3.1, TP2.1, U2.3 (VDD), U3.2 (EN), U3.3 (VIN)
/CAN_+: J1.A4 (CAN+), R1.1, U2.7 (CANH)
/CAN_-: J1.A5 (CAN-), R1.2, U2.6 (CANL)
/CAN_RX: U1.21 ((FDCAN1_RX/GPIO_EXTI11)PA11), U2.4 (RXD)
/CAN_TX: U1.22 ((FDCAN1_TX/GPIO_EXTI12)PA12), U2.1 (TXD)
/EXTERNAL_SIGNAL_1: J1.A6 (io_0), TP3.1, U1.19 ((TIM2_CH3/TIM15_BKIN/USART1_TX/GPIO_EXT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)
/EXTERNAL_SIGNAL_2: J1.B6 (io_1), TP4.1, U1.20 ((TIM2_CH4/USART1_RX/TIM17_BKIN/GPIO_EXT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)
/EXTERNAL_SIGNAL_3: J1.A7 (io_2), TP5.1, U1.25 ((TIM2_ETR/TIM2_CH1/GPIO_EXTI15)PA15)
/EXTERNAL_SIGNAL_4: J1.B7 (io_3), TP6.1, U1.26 ((TIM3_ETR/SPI1_SCK/TIM4_ETR/TIM2_CH2/GP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)
/EXTERNAL_SIGNAL_5: J1.A8 (io_4), TP7.1, U1.27 ((TIM17_BKIN/SPI1_MISO/TIM3_CH1/TIM16_CH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)
/EXTERNAL_SIGNAL_6: J1.B8 (io_5), TP8.1, U1.28 ((TIM17_CH1/SPI1_MOSI/TIM3_CH2/TIM16_BKI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)
/EXTERNAL_SIGNAL_7: J1.A9 (io_6), TP9.1, U1.29 ((TIM4_CH1/TIM16_CH1N/GPIO_EXTI6)PB6)
/EXTERNAL_SIGNAL_8: J1.A10 (io_8), TP10.1, U1.30 ((TIM3_CH4/TIM4_CH2/TIM17_CH1N/GPIO_EXTI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)
/EXTERNAL_SIGNAL_9: J1.A11 (io_10), TP11.1, U1.31 ((TIM4_CH3/TIM16_CH1/GPIO_EXTI8)PB8-BOOT0)
/HEARTBEAT: R4.1, U1.6 ((TIM15_CH1N/TIM2_CH2/GPIO_EXTI1/ADC2_IN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)
/INTERRUPT_TEST_HW: R7.1, SW1.2, U1.5 ((TIM2_ETR/TIM2_CH1/GPIO_EXTI0/ADC2_IN1/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)
/INTERRUPT_TEST_SW: R8.1, U1.18 ((TIM4_ETR/USART1_CK/GPIO_EXTI8)PA8)
/NRST: C2.1, J2.4, R5.1, U1.4 ((GPIO_EXTI10)PG10-NRST)
/PWM_TEST: R9.1, U1.7 ((TIM15_CH1/USART2_TX/TIM2_CH3/GPIO_EXTI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)
/SWCLK: J2.5, U1.24 ((SYS_JTCK-SWCLK/GPIO_EXTI14)PA14)
/SWDIO: J2.1, R6.1, U1.23 ((SYS_JTMS-SWDIO/GPIO_EXTI13)PA13)
GND: C1.1, C2.2, C3.2, C4.2, C5.2, C6.2, C7.2, C8.2, C9.2, C10.2, C12.2, C13.2, C14.2, D1.1 (K), D2.1 (K), D3.1 (K), D4.1 (K), D5.1 (K), D6.1 (K), D7.1 (K), D8.1 (K), J1.A3 (GND), J1.B4 (GND), J2.2, TP12.1, U1.14 (VSSA), U1.16 (VSS), U1.32 (VSS), U2.2 (VSS), U2.8 (STBY), U3.4 (GND), Y1.2, Y1.4
unnamed: D1.2 (A), R2.2
unnamed: D2.2 (A), R3.2
unnamed: D3.2 (A), R4.2
unnamed: D4.2 (A), R5.2
unnamed: D5.2 (A), R6.2
unnamed: D6.2 (A), R7.2
unnamed: D7.2 (A), R8.2
unnamed: D8.2 (A), R9.2
unnamed: F1.2, J1.B5 (5V)
unnamed: C13.1, U1.2 (PF0-OSC_IN), Y1.3
unnamed: C14.1, U1.3 (PF1-OSC_OUT), Y1.1
unnamed: C11.1, U3.6 (BST)
unnamed: C9.1, C10.1, F2.1, L1.2, U3.1 (FB)
unnamed: C11.2, L1.1, U3.5 (SW)
