olin-electric-motorsports/oem-monorepo/vehicle/mkviii/hardware/hv/power_thermistor/power_thermistor.kicad_pcb

## KiCad design vehicle/mkviii/hardware/hv/power_thermistor/power_thermistor.kicad_pcb (2026-04-18)

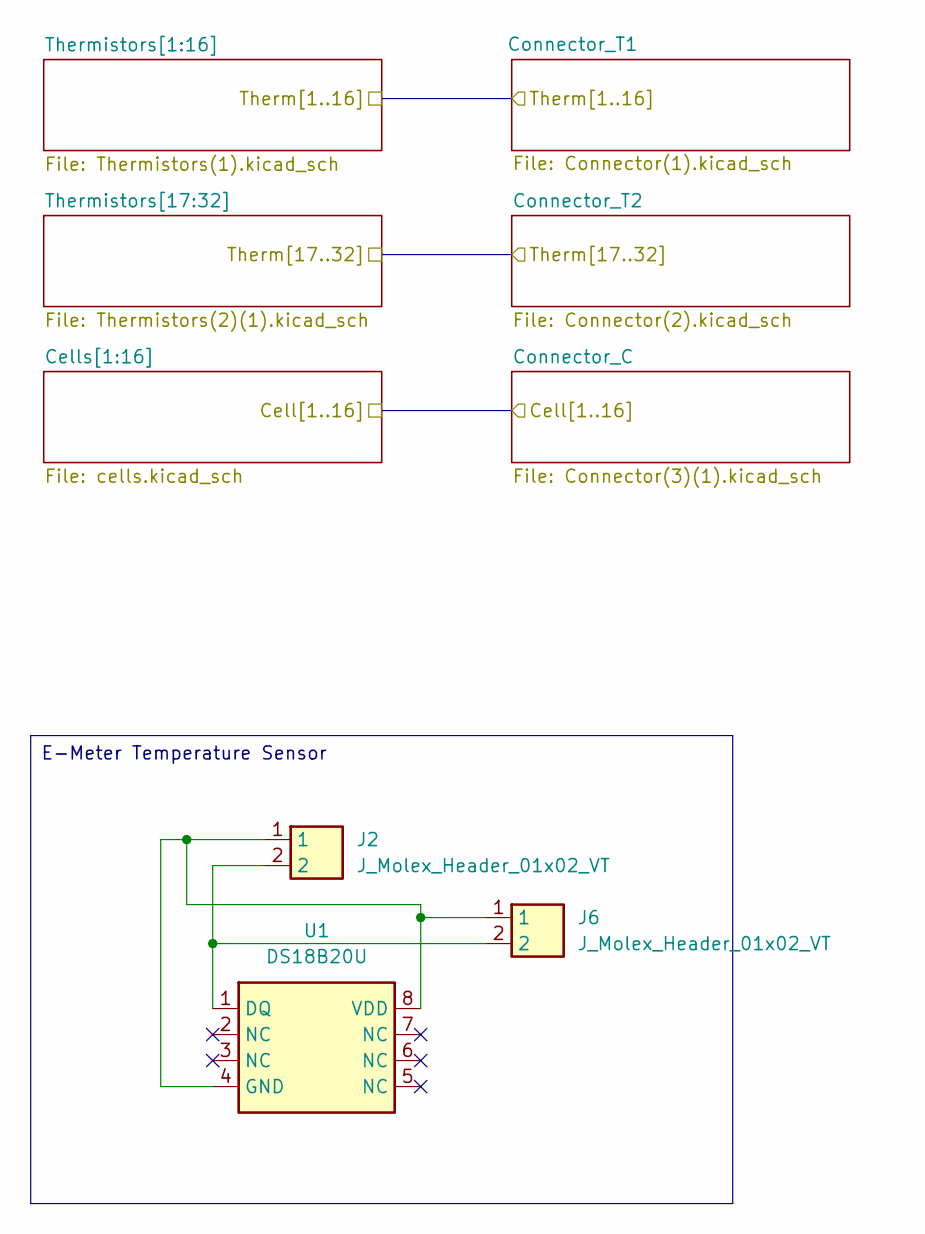
[picture p24: schematic power_thermistor.kicad_sch, Power-Thermistor]

Parts:
J2, J6: J_Molex_Header_01x02_VT; J_Molex_Header_01x02_VT - 43045-02YY_121314; MPN 43045-0212
U1: DS18B20U; 8-uSOP; MPN DS18B20U

Connections:
unnamed: J2.2, J6.2, U1.1 (DQ)
unnamed: J2.1, J6.1, U1.4 (GND), U1.8 (VDD)

Notes on the sheet:
E-Meter Temperature Sensor

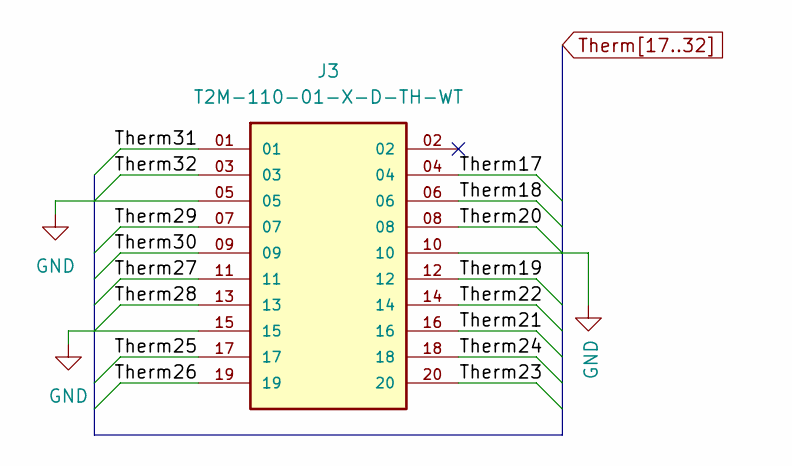
[picture p25: schematic Connector(2).kicad_sch, Power-Thermistor]

Parts:
J3: T2M-110-01-X-D-TH-WT; SAMTEC_EHT-110-01-X-D (J_EHT-110-01-F-D); PARTREV AH

Connections:
GND: J3.05, J3.10, J3.15; also elsewhere on the board
Therm17: J3.04; also elsewhere on the board
Therm18: J3.06; also elsewhere on the board
Therm19: J3.12; also elsewhere on the board
Therm20: J3.08; also elsewhere on the board
Therm21: J3.16; also elsewhere on the board
Therm22: J3.14; also elsewhere on the board
Therm23: J3.20; also elsewhere on the board
Therm24: J3.18; also elsewhere on the board
Therm25: J3.17; also elsewhere on the board
Therm26: J3.19; also elsewhere on the board
Therm27: J3.11; also elsewhere on the board
Therm28: J3.13; also elsewhere on the board
Therm29: J3.07; also elsewhere on the board
Therm30: J3.09; also elsewhere on the board
Therm31: J3.01; also elsewhere on the board
Therm32: J3.03; also elsewhere on the board

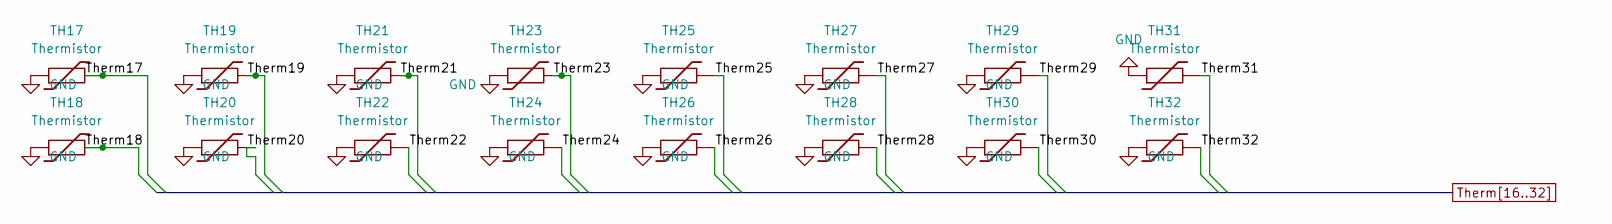
[picture p26: schematic Thermistors(2)(1).kicad_sch, Power-Thermistor]

Parts:
TH17, TH18, TH19, TH20, TH21, TH22, TH23, TH24, TH25, TH26, TH27, TH28, TH29, TH30, TH31, TH32: Thermistor; R_0603_1608Metric

Connections:
GND: TH17.1, TH18.1, TH19.1, TH20.1, TH21.1, TH22.1, TH23.1, TH24.1, TH25.1, TH26.1, TH27.1, TH28.1, TH29.1, TH30.1, TH31.1, TH32.1; also elsewhere on the board
Therm17: TH17.2; also elsewhere on the board
Therm18: TH18.2; also elsewhere on the board
Therm19: TH19.2; also elsewhere on the board
Therm20: TH20.2; also elsewhere on the board
Therm21: TH21.2; also elsewhere on the board
Therm22: TH22.2; also elsewhere on the board
Therm23: TH23.2; also elsewhere on the board
Therm24: TH24.2; also elsewhere on the board
Therm25: TH25.2; also elsewhere on the board
Therm26: TH26.2; also elsewhere on the board
Therm27: TH27.2; also elsewhere on the board
Therm28: TH28.2; also elsewhere on the board
Therm29: TH29.2; also elsewhere on the board
Therm30: TH30.2; also elsewhere on the board
Therm31: TH31.2; also elsewhere on the board
Therm32: TH32.2; also elsewhere on the board

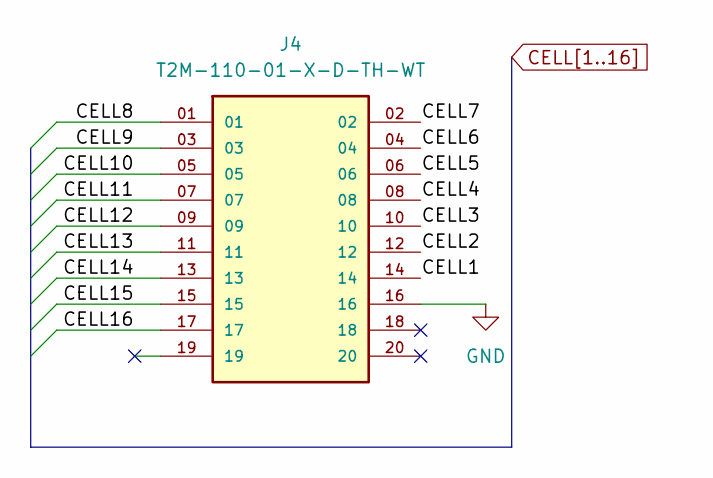
[picture p27: schematic Connector(3)(1).kicad_sch, Power-Thermistor]

Parts:
J4: T2M-110-01-X-D-TH-WT; SAMTEC_EHT-110-01-X-D (J_EHT-110-01-F-D); PARTREV AH

Connections:
CELL1: J4.14; also elsewhere on the board
CELL2: J4.12; also elsewhere on the board
CELL3: J4.10; also elsewhere on the board
CELL4: J4.08; also elsewhere on the board
CELL5: J4.06; also elsewhere on the board
CELL6: J4.04; also elsewhere on the board
CELL7: J4.02; also elsewhere on the board
CELL8: J4.01; also elsewhere on the board
CELL9: J4.03; also elsewhere on the board
CELL10: J4.05; also elsewhere on the board
CELL11: J4.07; also elsewhere on the board
CELL12: J4.09; also elsewhere on the board
CELL13: J4.11; also elsewhere on the board
CELL14: J4.13; also elsewhere on the board
CELL15: J4.15; also elsewhere on the board
CELL16: J4.17; also elsewhere on the board
GND: J4.16; also elsewhere on the board

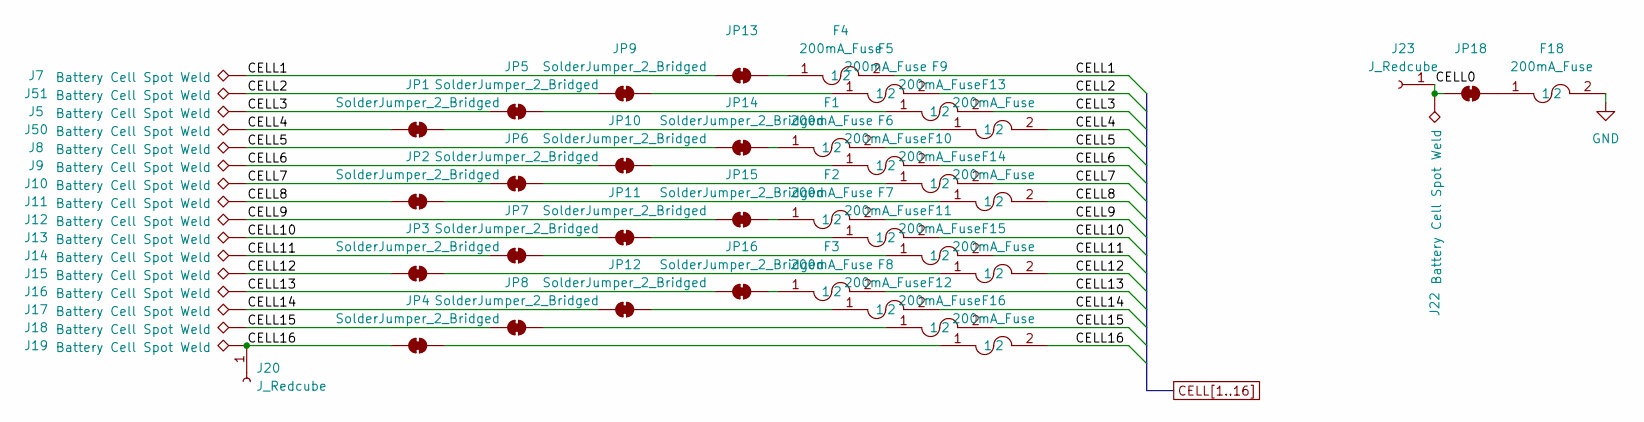
[picture p28: schematic cells.kicad_sch, Power-Thermistor]

Parts:
F1, F2, F3, F4, F5, F6, F7, F8, F9, F10, F11, F12, F13, F14, F15, F16, F18: 200mA_Fuse; Fuse_0805_2012Metric; MPN 507-1767-1-ND
J5, J7, J8, J9, J10, J11, J12, J13, J14, J15, J16, J17, J18, J19, J22, J50, J51: Battery Cell Spot Weld; J_Bond_Pad_4p
J20, J23: J_Redcube; Wurth-7461115; MPN 7461115
JP1, JP2, JP3, JP4, JP5, JP6, JP7, JP8, JP9, JP10, JP11, JP12, JP13, JP14, JP15, JP16, JP18: SolderJumper_2_Bridged; SolderJumper-2_P1.3mm_Bridged2Bar_Pad1.0x1.5mm

Connections:
/Cells[1:16]/CELL0: J22.1, J23.1, JP18.1 (A)
CELL1: F4.2, J7.1, JP13.1 (A); also elsewhere on the board
CELL2: F5.2, J51.1, JP9.1 (A); also elsewhere on the board
CELL3: F9.2, J5.1, JP5.1 (A); also elsewhere on the board
CELL4: F13.2, J50.1, JP1.1 (A); also elsewhere on the board
CELL5: F1.2, J8.1, JP14.1 (A); also elsewhere on the board
CELL6: F6.2, J9.1, JP10.1 (A); also elsewhere on the board
CELL7: F10.2, J10.1, JP6.1 (A); also elsewhere on the board
CELL8: F14.2, J11.1, JP2.1 (A); also elsewhere on the board
CELL9: F2.2, J12.1, JP15.1 (A); also elsewhere on the board
CELL10: F7.2, J13.1, JP11.1 (A); also elsewhere on the board
CELL11: F11.2, J14.1, JP7.1 (A); also elsewhere on the board
CELL12: F15.2, J15.1, JP3.1 (A); also elsewhere on the board
CELL13: F3.2, J16.1, JP16.1 (A); also elsewhere on the board
CELL14: F8.2, J17.1, JP12.1 (A); also elsewhere on the board
CELL15: F12.2, J18.1, JP8.1 (A); also elsewhere on the board
CELL16: F16.2, J19.1, J20.1, JP4.1 (A); also elsewhere on the board
GND: F18.2; also elsewhere on the board
unnamed: F13.1, JP1.2 (B)
unnamed: F14.1, JP2.2 (B)
unnamed: F15.1, JP3.2 (B)
unnamed: F16.1, JP4.2 (B)
unnamed: F9.1, JP5.2 (B)
unnamed: F10.1, JP6.2 (B)
unnamed: F11.1, JP7.2 (B)
unnamed: F12.1, JP8.2 (B)
unnamed: F5.1, JP9.2 (B)
unnamed: F6.1, JP10.2 (B)
unnamed: F7.1, JP11.2 (B)
unnamed: F8.1, JP12.2 (B)
unnamed: F4.1, JP13.2 (B)
unnamed: F1.1, JP14.2 (B)
unnamed: F2.1, JP15.2 (B)
unnamed: F3.1, JP16.2 (B)
unnamed: F18.1, JP18.2 (B)

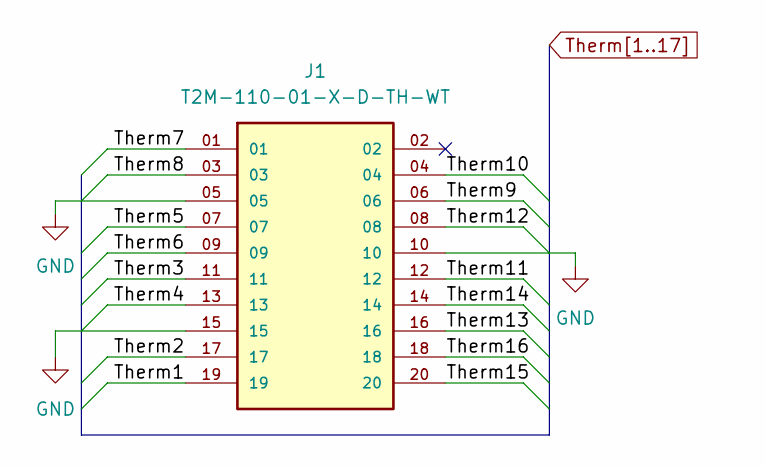
[picture p29: schematic Connector(1).kicad_sch, Power-Thermistor]

Parts:
J1: T2M-110-01-X-D-TH-WT; SAMTEC_EHT-110-01-X-D (J_EHT-110-01-F-D); PARTREV AH

Connections:
GND: J1.05, J1.10, J1.15; also elsewhere on the board
Therm1: J1.19; also elsewhere on the board
Therm2: J1.17; also elsewhere on the board
Therm3: J1.11; also elsewhere on the board
Therm4: J1.13; also elsewhere on the board
Therm5: J1.07; also elsewhere on the board
Therm6: J1.09; also elsewhere on the board
Therm7: J1.01; also elsewhere on the board
Therm8: J1.03; also elsewhere on the board
Therm9: J1.06; also elsewhere on the board
Therm10: J1.04; also elsewhere on the board
Therm11: J1.12; also elsewhere on the board
Therm12: J1.08; also elsewhere on the board
Therm13: J1.16; also elsewhere on the board
Therm14: J1.14; also elsewhere on the board
Therm15: J1.20; also elsewhere on the board
Therm16: J1.18; also elsewhere on the board

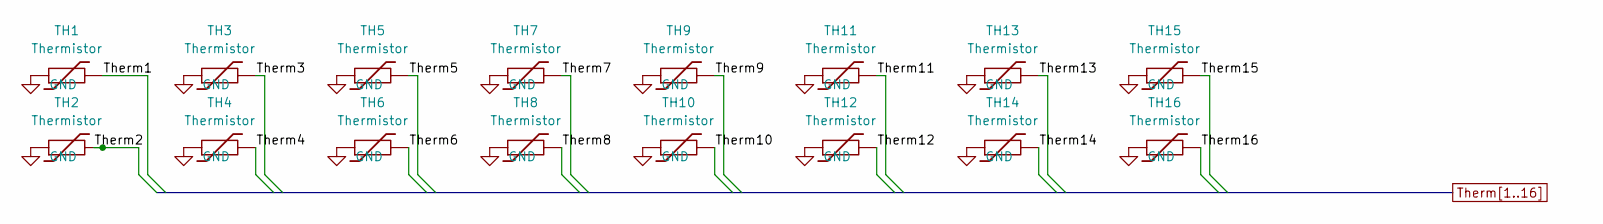
[picture p30: schematic Thermistors(1).kicad_sch, Power-Thermistor]

Parts:
TH1, TH2, TH3, TH4, TH5, TH6, TH7, TH8, TH9, TH10, TH11, TH12, TH13, TH14, TH15, TH16: Thermistor; R_0603_1608Metric

Connections:
GND: TH1.1, TH2.1, TH3.1, TH4.1, TH5.1, TH6.1, TH7.1, TH8.1, TH9.1, TH10.1, TH11.1, TH12.1, TH13.1, TH14.1, TH15.1, TH16.1; also elsewhere on the board
Therm1: TH1.2; also elsewhere on the board
Therm2: TH2.2; also elsewhere on the board
Therm3: TH3.2; also elsewhere on the board
Therm4: TH4.2; also elsewhere on the board
Therm5: TH5.2; also elsewhere on the board
Therm6: TH6.2; also elsewhere on the board
Therm7: TH7.2; also elsewhere on the board
Therm8: TH8.2; also elsewhere on the board
Therm9: TH9.2; also elsewhere on the board
Therm10: TH10.2; also elsewhere on the board
Therm11: TH11.2; also elsewhere on the board
Therm12: TH12.2; also elsewhere on the board
Therm13: TH13.2; also elsewhere on the board
Therm14: TH14.2; also elsewhere on the board
Therm15: TH15.2; also elsewhere on the board
Therm16: TH16.2; also elsewhere on the board

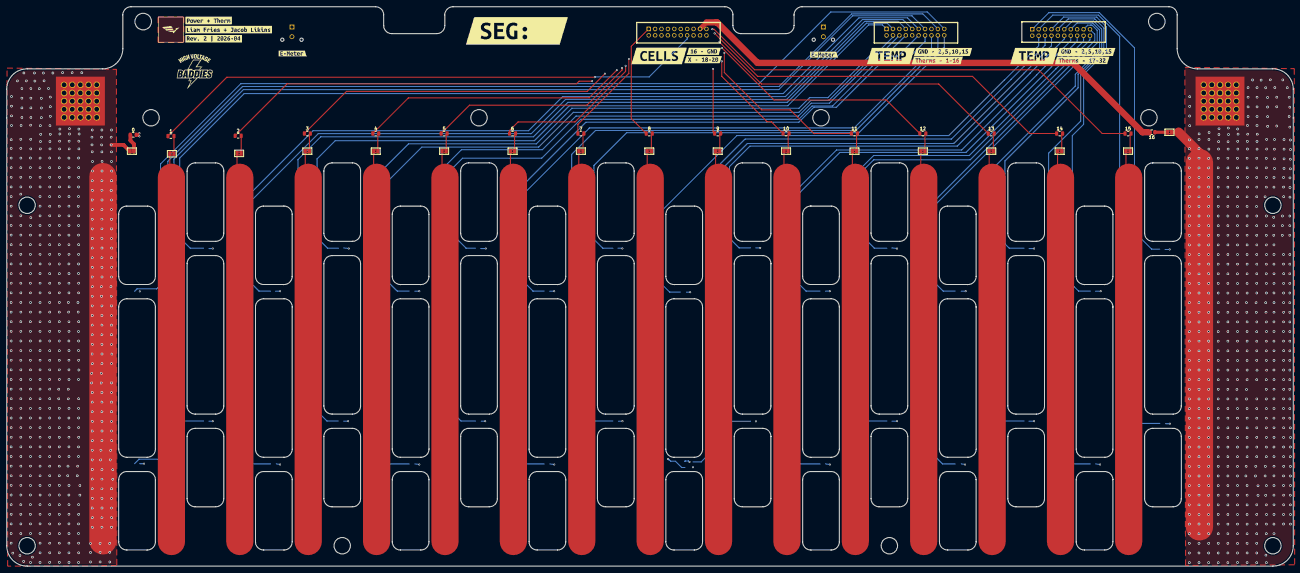
[picture p31: board power_thermistor.kicad_pcb from above]

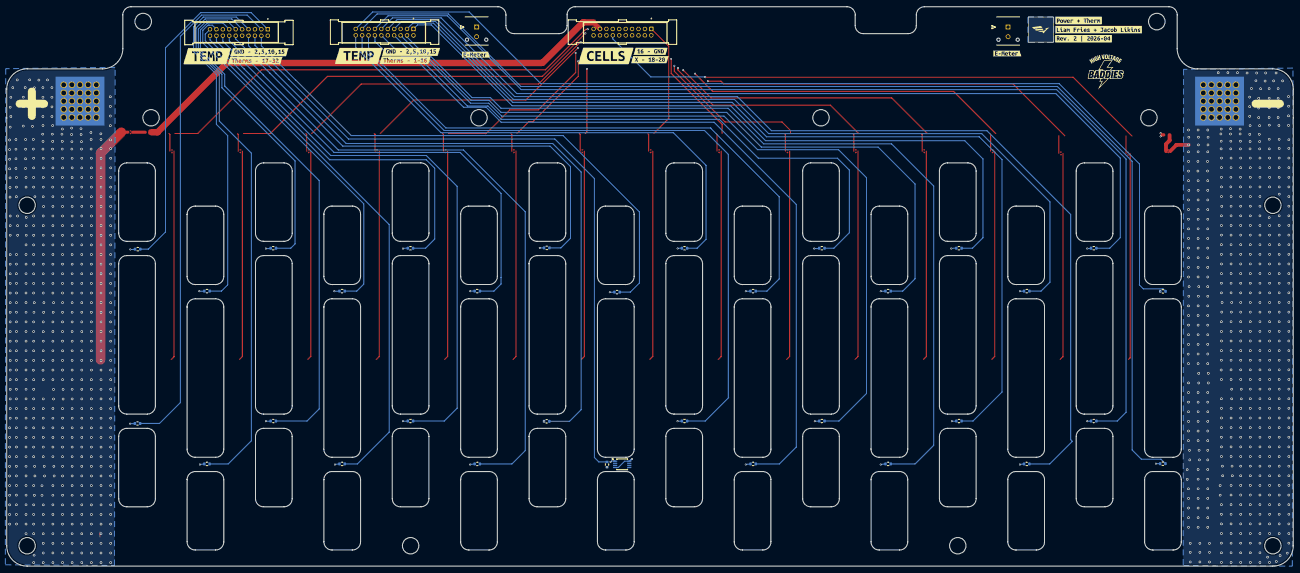
[picture p32: board power_thermistor.kicad_pcb from below]

Board: 4 copper layers, 400.9 x 174.3 mm, 120 parts (54 on the bottom side), 69 nets.

Other parts of the board:
kibuzzard-69DFA9BC, kibuzzard-69DFA9BC#2: G***; kibuzzard-69DFA9BC
kibuzzard-69E00A54, kibuzzard-69E00A54#2, kibuzzard-69E00A54#3, kibuzzard-69E00A54#4: G***; kibuzzard-69E00A54
kibuzzard-69E05987, kibuzzard-69E05987#2: G***; kibuzzard-69E05987
kibuzzard-6738FA22, kibuzzard-6738FA22#2: G***; kibuzzard-6738FA22
kibuzzard-6738FB72, kibuzzard-6738FB72#2, kibuzzard-6738FB72#3, kibuzzard-6738FB72#4: G***; kibuzzard-6738FB72
kibuzzard-69840BF2, kibuzzard-69840BF2#2: G***; kibuzzard-69840BF2
kibuzzard-69840BF7, kibuzzard-69840BF7#2: G***; kibuzzard-69840BF7
kibuzzard-69840C1E, kibuzzard-69840C1E#2: G***; kibuzzard-69840C1E
kibuzzard-69840C4F, kibuzzard-69840C4F#2: G***; kibuzzard-69840C4F
kibuzzard-69840C62, kibuzzard-69840C62#2: G***; kibuzzard-69840C62
kibuzzard-69840C71, kibuzzard-69840C71#2: G***; kibuzzard-69840C71
kibuzzard-6739182D: G***; kibuzzard-6739182D
kibuzzard-67390047, kibuzzard-67390047#2: G***; kibuzzard-67390047
