olin-electric-motorsports/oem-monorepo/vehicle/mkviii/hardware/hv/bms_da/data_aquisition_module.kicad_pcb

## KiCad design vehicle/mkviii/hardware/hv/bms_da/data_aquisition_module.kicad_pcb (2026-04-11)

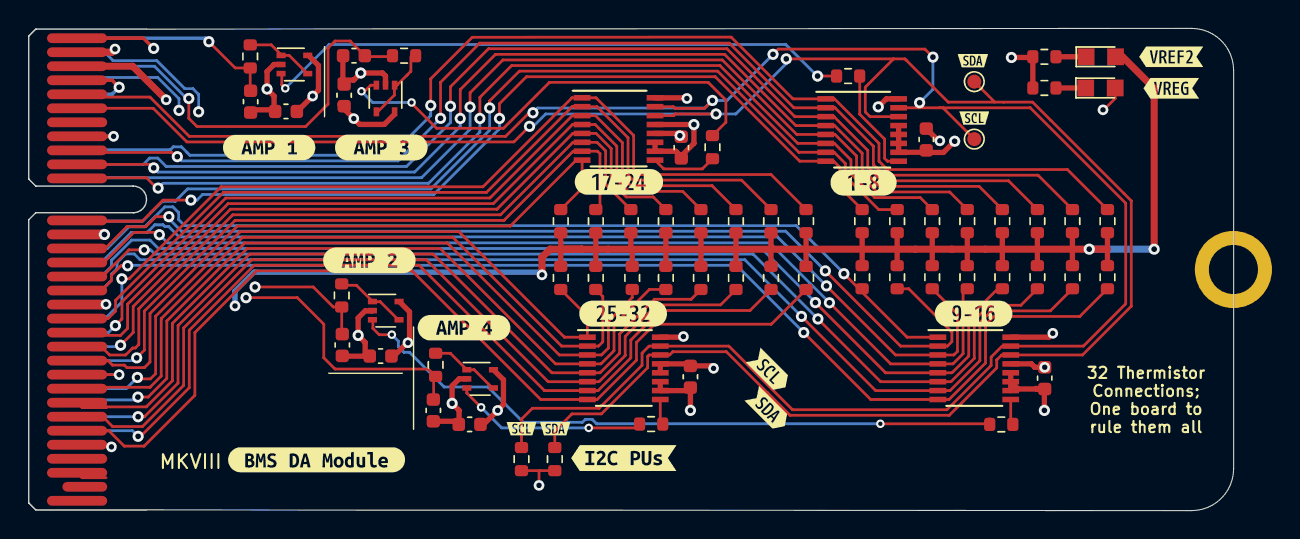
[picture p33: board data_aquisition_module.kicad_pcb from above]

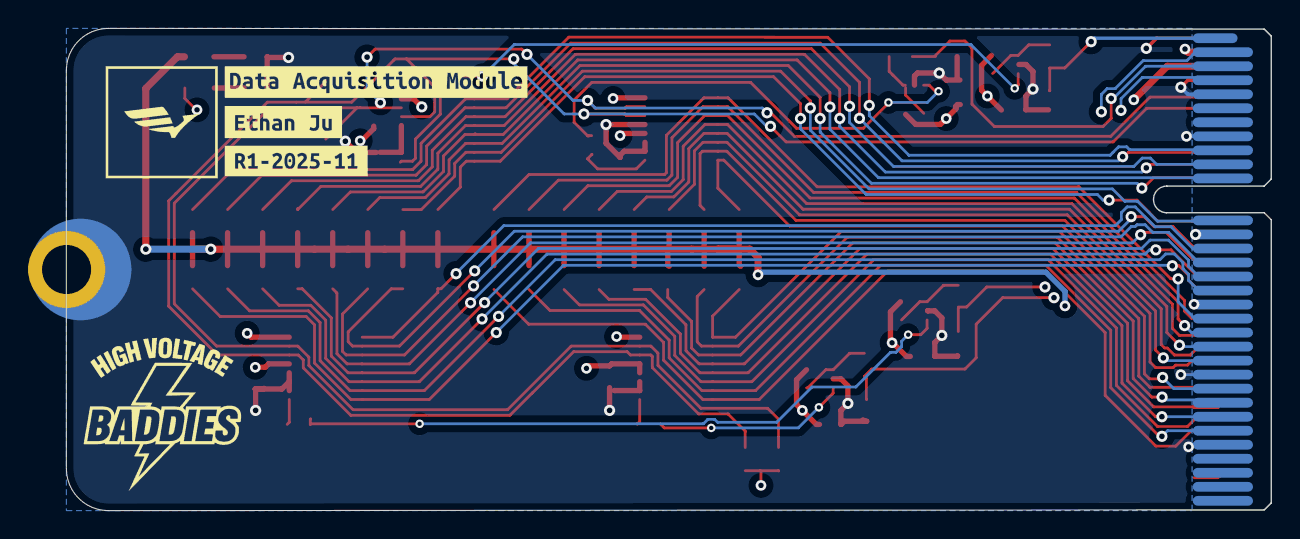
[picture p34: board data_aquisition_module.kicad_pcb from below]

Board: 4 copper layers, 86.0 x 34.4 mm, 91 parts (3 on the bottom side), 55 nets.

Parts:
C1, C2, C3, C4: C_1uF; C_0603
C5, C6, C7, C8, C9, C10, C11, C12: 1uF; C_0603
H2: CONN_MountingHole; PCIe_Mount
J1: CONN_pcie_x4; pcie_x4
PD1, PD2: WHITE; CHIPLED_0805
R1, R2, R3, R4, R5, R6, R7, R8, R9, R10, R11, R12, R13, R14, R15, R16, R17, R18, R19, R20, R21, R22, R23, R24, R25, R26, R27, R28, R29, R30, R31, R32: R_100K; R_0603
R33, R35, R37, R39: 1M; R_0603
R34, R36, R38, R40: 3.3K; R_0603
R41, R42: 1KR; R_0603
R43, R44: 4.7K; R_0603
TP1, TP2: TP_1mm; TestPoint_Pad_D1.0mm
U1, U2, U3, U4: LTC1380IGN; SSOP-16_3.9x4.9mm_P0.635mm
U5, U6, U7, U8: MCP6001T-I-LT; SOT-353_SC-70-5
kibuzzard-63A54BB0: G***; kibuzzard-63A54BB0
kibuzzard-63A54BCB: G***; kibuzzard-63A54BCB
kibuzzard-63A54BE3: G***; kibuzzard-63A54BE3
kibuzzard-63BF51CA: G***; kibuzzard-63BF51CA
kibuzzard-63BF55B8: G***; kibuzzard-63BF55B8
kibuzzard-63BF55D1: G***; kibuzzard-63BF55D1
kibuzzard-672C3C6B, kibuzzard-672C3C6B#2: G***; kibuzzard-672C3C6B
kibuzzard-672C3C52, kibuzzard-672C3C52#2: G***; kibuzzard-672C3C52
kibuzzard-672C38BF: G***; kibuzzard-672C38BF
kibuzzard-673B8AB7: G***; kibuzzard-673B8AB7
kibuzzard-673B8ABD: G***; kibuzzard-673B8ABD
kibuzzard-673B8BCC: G***; kibuzzard-673B8BCC
kibuzzard-673B8DE4: G***; kibuzzard-673B8DE4
kibuzzard-673B8DEE: G***; kibuzzard-673B8DEE
kibuzzard-6920C4AE: G***; kibuzzard-6920C4AE
kibuzzard-6920C49E: G***; kibuzzard-6920C49E
kibuzzard-66171EA1: G***; kibuzzard-66171EA1
kibuzzard-66171EC5: G***; kibuzzard-66171EC5
kibuzzard-661723CB: G***; kibuzzard-661723CB

Connections:
/MUX_1_OUT: C12.1, J1.A1 (Aout_0), R34.1
/MUX_2_OUT: C10.1, J1.A2 (Aout_1), R36.1
/MUX_3_OUT: C8.1, J1.A3 (Aout_2), R38.1
/MUX_4_OUT: C6.1, J1.A4 (Aout_3), R40.1
/SCL: J1.B5 (SCL), R43.1, TP1.1, U1.15 (SCL), U2.15 (SCL), U3.15 (SCL), U4.15 (SCL)
/SDA: J1.B6 (SDA), R44.1, TP2.1, U1.14 (SDA), U2.14 (SDA), U3.14 (SDA), U4.14 (SDA)
/THERM_1: J1.A9 (Ain_0), R1.2, U1.1 (S0)
/THERM_2: J1.B9 (Ain_1), R2.2, U1.2 (S1)
/THERM_3: J1.A10 (Ain_2), R3.2, U1.3 (S2)
/THERM_4: J1.B10 (Ain_3), R4.2, U1.4 (S3)
/THERM_5: J1.A11 (Ain_4), R5.2, U1.5 (S4)
/THERM_6: J1.B11 (Ain_5), R6.2, U1.6 (S5)
/THERM_7: J1.A12 (Ain_6), R7.2, U1.7 (S6)
/THERM_8: J1.B12 (Ain_7), R8.2, U1.8 (S7)
/THERM_9: J1.A14 (Ain_8), R9.2, U2.1 (S0)
/THERM_10: J1.B14 (Ain_9), R10.2, U2.2 (S1)
/THERM_11: J1.A15 (Ain_10), R11.2, U2.3 (S2)
/THERM_12: J1.B15 (Ain_11), R12.2, U2.4 (S3)
/THERM_13: J1.A16 (Ain_12), R13.2, U2.5 (S4)
/THERM_14: J1.B16 (Ain_13), R14.2, U2.6 (S5)
/THERM_15: J1.A17 (Ain_14), R15.2, U2.7 (S6)
/THERM_16: J1.B17 (Ain_15), R16.2, U2.8 (S7)
/THERM_17: J1.A19 (Ain_16), R17.2, U3.1 (S0)
/THERM_18: J1.B19 (Ain_17), R18.2, U3.2 (S1)
/THERM_19: J1.A20 (Ain_18), R19.2, U3.3 (S2)
/THERM_20: J1.B20 (Ain_19), R20.2, U3.4 (S3)
/THERM_21: J1.A21 (Ain_20), R21.2, U3.5 (S4)
/THERM_22: J1.B21 (Ain_21), R22.2, U3.6 (S5)
/THERM_23: J1.A22 (Ain_22), R23.2, U3.7 (S6)
/THERM_24: J1.B22 (Ain_23), R24.2, U3.8 (S7)
/THERM_25: J1.A24 (Ain_24), R25.2, U4.1 (S0)
/THERM_26: J1.B24 (Ain_25), R26.2, U4.2 (S1)
/THERM_27: J1.A25 (Ain_26), R27.2, U4.3 (S2)
/THERM_28: J1.B25 (Ain_27), R28.2, U4.4 (S3)
/THERM_29: J1.A26 (Ain_28), R29.2, U4.5 (S4)
/THERM_30: J1.B26 (Ain_29), R30.2, U4.6 (S5)
/THERM_31: J1.A27 (Ain_30), R31.2, U4.7 (S6)
/THERM_32: J1.B27 (Ain_31), R32.2, U4.8 (S7)
/VREF2: J1.B3 (3V), PD2.2 (A), R1.1, R2.1, R3.1, R4.1, R5.1, R6.1, R7.1, R8.1, R9.1, R10.1, R11.1, R12.1, R13.1, R14.1, R15.1, R16.1, R17.1, R18.1, R19.1, R20.1, R21.1, R22.1, R23.1, R24.1, R25.1, R26.1, R27.1, R28.1, R29.1, R30.1, R31.1, R32.1
/VREG: C1.1, C2.1, C3.1, C4.1, C5.1, C7.1, C9.1, C11.1, J1.B2 (5V), PD1.2 (A), R43.2, R44.2, U1.16 (VCC), U2.13 (A0), U2.16 (VCC), U3.12 (A1), U3.16 (VCC), U4.12 (A1), U4.13 (A0), U4.16 (VCC), U5.5 (V+), U6.5 (V+), U7.5 (V+), U8.5 (V+)
GND: C1.2, C2.2, C3.2, C4.2, C5.2, C6.2, C7.2, C8.2, C9.2, C10.2, C11.2, C12.2, H2.1, J1.A5 (GND), J1.A8 (GND), J1.A13 (GND), J1.A18 (GND), J1.A23 (GND), J1.A28 (GND), J1.B1 (GND), J1.B4 (GND), J1.B8 (GND), J1.B13 (GND), J1.B18 (GND), J1.B23 (GND), J1.B28 (GND), R41.2, R42.2, U1.10 (VEE), U1.11 (GND), U1.12 (A1), U1.13 (A0), U2.10 (VEE), U2.11 (GND), U2.12 (A1), U3.10 (VEE), U3.11 (GND), U3.13 (A0), U4.10 (VEE), U4.11 (GND), U5.2 (V-), U6.2 (V-), U7.2 (V-), U8.2 (V-)
unnamed: PD1.1 (K), R41.1
unnamed: PD2.1 (K), R42.1
unnamed: R33.1, U1.9 (D0)
unnamed: R35.1, U2.9 (D0)
unnamed: R37.1, U3.9 (D0)
unnamed: R39.1, U4.9 (D0)
unnamed: R39.2, U5.3 (+)
unnamed: R40.2, U5.1, U5.4 (-)
unnamed: R37.2, U6.3 (+)
unnamed: R38.2, U6.1, U6.4 (-)
unnamed: R35.2, U7.3 (+)
unnamed: R36.2, U7.1, U7.4 (-)
unnamed: R33.2, U8.3 (+)
unnamed: R34.2, U8.1, U8.4 (-)
