olin-electric-motorsports/oem-monorepo/vehicle/mkviii/hardware/hv/bms_motherboard/bms-motherboard.kicad_pcb

## KiCad design vehicle/mkviii/hardware/hv/bms_motherboard/bms-motherboard.kicad_pcb (2026-04-11)

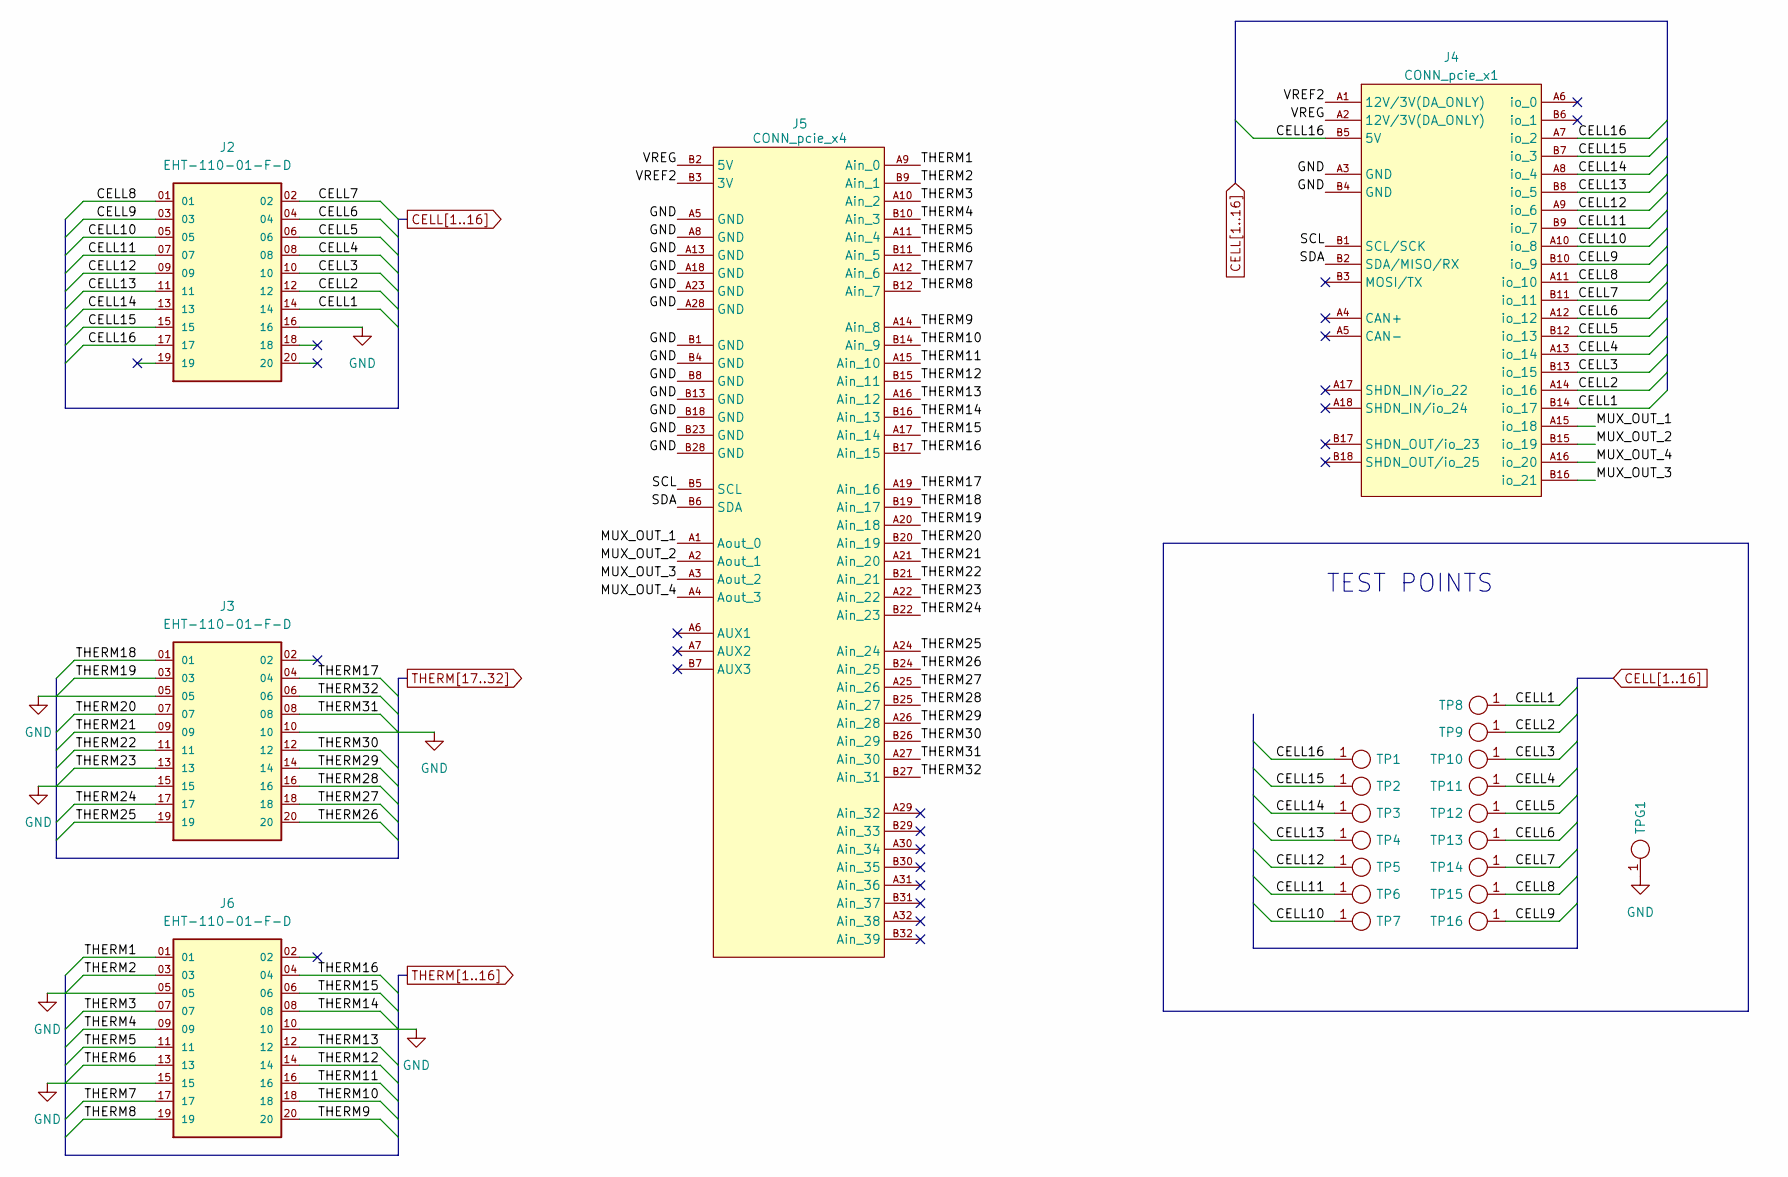
[picture p35: schematic bms-motherboard.kicad_sch, BMS Motherboard]

Parts:
J2, J3, J6: EHT-110-01-F-D; SAMTEC_EHT-110-01-X-D (J_EHT-110-01-F-D); MPN EHT-110-01-F-D
J4: CONN_pcie_x1; te_pcie_x1_connector
J5: CONN_pcie_x4; te_pcie_x4_connector
TP1, TP2, TP3, TP4, TP5, TP6, TP7, TP8, TP9, TP10, TP11, TP12, TP13, TP14, TP15, TP16: TP_SMD; Test_Point_SMD; MPN 5019
TPG1: TP_SMD; Test_Point_SMD; MPN 5019

Connections:
/MUX_OUT_1: J4.A15 (io_18), J5.A1 (Aout_0)
/MUX_OUT_2: J4.B15 (io_19), J5.A2 (Aout_1)
/MUX_OUT_3: J4.B16 (io_21), J5.A3 (Aout_2)
/MUX_OUT_4: J4.A16 (io_20), J5.A4 (Aout_3)
/SCL: J4.B1 (SCL/SCK), J5.B5 (SCL)
/SDA: J4.B2 (SDA/MISO/RX), J5.B6 (SDA)
/VREF2: J4.A1 (12V/3V(DA_ONLY)), J5.B3 (3V)
/VREG: J4.A2 (12V/3V(DA_ONLY)), J5.B2 (5V)
CELL1: J2.14, J4.B14 (io_17), TP8.1
CELL2: J2.12, J4.A14 (io_16), TP9.1
CELL3: J2.10, J4.B13 (io_15), TP10.1
CELL4: J2.08, J4.A13 (io_14), TP11.1
CELL5: J2.06, J4.B12 (io_13), TP12.1
CELL6: J2.04, J4.A12 (io_12), TP13.1
CELL7: J2.02, J4.B11 (io_11), TP14.1
CELL8: J2.01, J4.A11 (io_10), TP15.1
CELL9: J2.03, J4.B10 (io_9), TP16.1
CELL10: J2.05, J4.A10 (io_8), TP7.1
CELL11: J2.07, J4.B9 (io_7), TP6.1
CELL12: J2.09, J4.A9 (io_6), TP5.1
CELL13: J2.11, J4.B8 (io_5), TP4.1
CELL14: J2.13, J4.A8 (io_4), TP3.1
CELL15: J2.15, J4.B7 (io_3), TP2.1
CELL16: J2.17, J4.A7 (io_2), J4.B5 (5V), TP1.1
GND: J2.16, J3.05, J3.10, J3.15, J4.A3 (GND), J4.B4 (GND), J5.A5 (GND), J5.A8 (GND), J5.A13 (GND), J5.A18 (GND), J5.A23 (GND), J5.A28 (GND), J5.B1 (GND), J5.B4 (GND), J5.B8 (GND), J5.B13 (GND), J5.B18 (GND), J5.B23 (GND), J5.B28 (GND), J6.05, J6.10, J6.15, TPG1.1
THERM1: J5.A9 (Ain_0), J6.01
THERM2: J5.B9 (Ain_1), J6.03
THERM3: J5.A10 (Ain_2), J6.07
THERM4: J5.B10 (Ain_3), J6.09
THERM5: J5.A11 (Ain_4), J6.11
THERM6: J5.B11 (Ain_5), J6.13
THERM7: J5.A12 (Ain_6), J6.17
THERM8: J5.B12 (Ain_7), J6.19
THERM9: J5.A14 (Ain_8), J6.20
THERM10: J5.B14 (Ain_9), J6.18
THERM11: J5.A15 (Ain_10), J6.16
THERM12: J5.B15 (Ain_11), J6.14
THERM13: J5.A16 (Ain_12), J6.12
THERM14: J5.B16 (Ain_13), J6.08
THERM15: J5.A17 (Ain_14), J6.06
THERM16: J5.B17 (Ain_15), J6.04
THERM17: J3.04, J5.A19 (Ain_16)
THERM18: J3.01, J5.B19 (Ain_17)
THERM19: J3.03, J5.A20 (Ain_18)
THERM20: J3.07, J5.B20 (Ain_19)
THERM21: J3.09, J5.A21 (Ain_20)
THERM22: J3.11, J5.B21 (Ain_21)
THERM23: J3.13, J5.A22 (Ain_22)
THERM24: J3.17, J5.B22 (Ain_23)
THERM25: J3.19, J5.A24 (Ain_24)
THERM26: J3.20, J5.B24 (Ain_25)
THERM27: J3.18, J5.A25 (Ain_26)
THERM28: J3.16, J5.B25 (Ain_27)
THERM29: J3.14, J5.A26 (Ain_28)
THERM30: J3.12, J5.B26 (Ain_29)
THERM31: J3.08, J5.A27 (Ain_30)
THERM32: J3.06, J5.B27 (Ain_31)

Notes on the sheet:
TEST POINTS

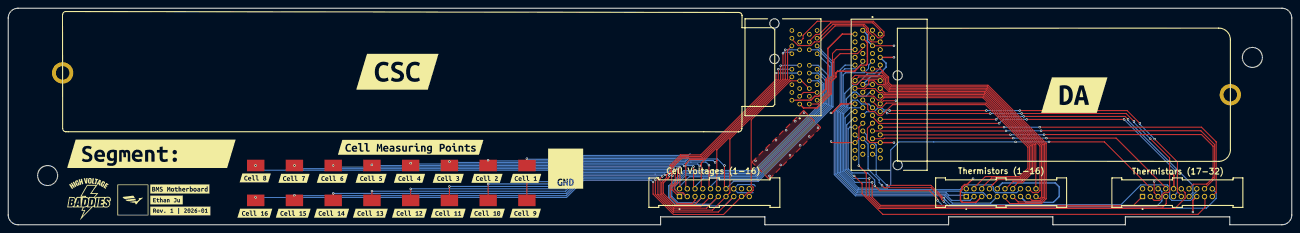
[picture p36: board bms-motherboard.kicad_pcb from above]

Board: 2 copper layers, 331.3 x 55.9 mm, 48 parts (0 on the bottom side), 57 nets.

Other parts of the board:
H1, H2: CONN_MountingHole; PCIe_Mount
kibuzzard-691BC298: G***; kibuzzard-691BC298
kibuzzard-6747A1EF: G***; kibuzzard-6747A1EF
kibuzzard-6747A1F5: G***; kibuzzard-6747A1F5
kibuzzard-6747A1FA: G***; kibuzzard-6747A1FA
kibuzzard-6747A20D: G***; kibuzzard-6747A20D
kibuzzard-6747A21A: G***; kibuzzard-6747A21A
kibuzzard-6747A21D: G***; kibuzzard-6747A21D
kibuzzard-6747A22C: G***; kibuzzard-6747A22C
kibuzzard-6747A22F: G***; kibuzzard-6747A22F
kibuzzard-6747A069: G***; kibuzzard-6747A069
kibuzzard-6747A200: G***; kibuzzard-6747A200
kibuzzard-6747A204: G***; kibuzzard-6747A204
kibuzzard-6747A209: G***; kibuzzard-6747A209
kibuzzard-6747A211: G***; kibuzzard-6747A211
kibuzzard-6747A215: G***; kibuzzard-6747A215
kibuzzard-6747A222: G***; kibuzzard-6747A222
kibuzzard-6747A229: G***; kibuzzard-6747A229
kibuzzard-6747A319: G***; kibuzzard-6747A319
kibuzzard-6747A384: G***; kibuzzard-6747A384
kibuzzard-6747F2A5: G***; kibuzzard-6747F2A5
kibuzzard-67479E66: G***; kibuzzard-67479E66
kibuzzard-67479E86: G***; kibuzzard-67479E86
kibuzzard-69836BC9: G***; kibuzzard-69836BC9
kibuzzard-69836C11: G***; kibuzzard-69836C11
