olin-electric-motorsports/oem-monorepo/vehicle/mkviii/hardware/integration/charging_board/charging_cart_controller.kicad_pcb

## KiCad design vehicle/mkviii/hardware/integration/charging_board/charging_cart_controller.kicad_pcb (2026-04-04)

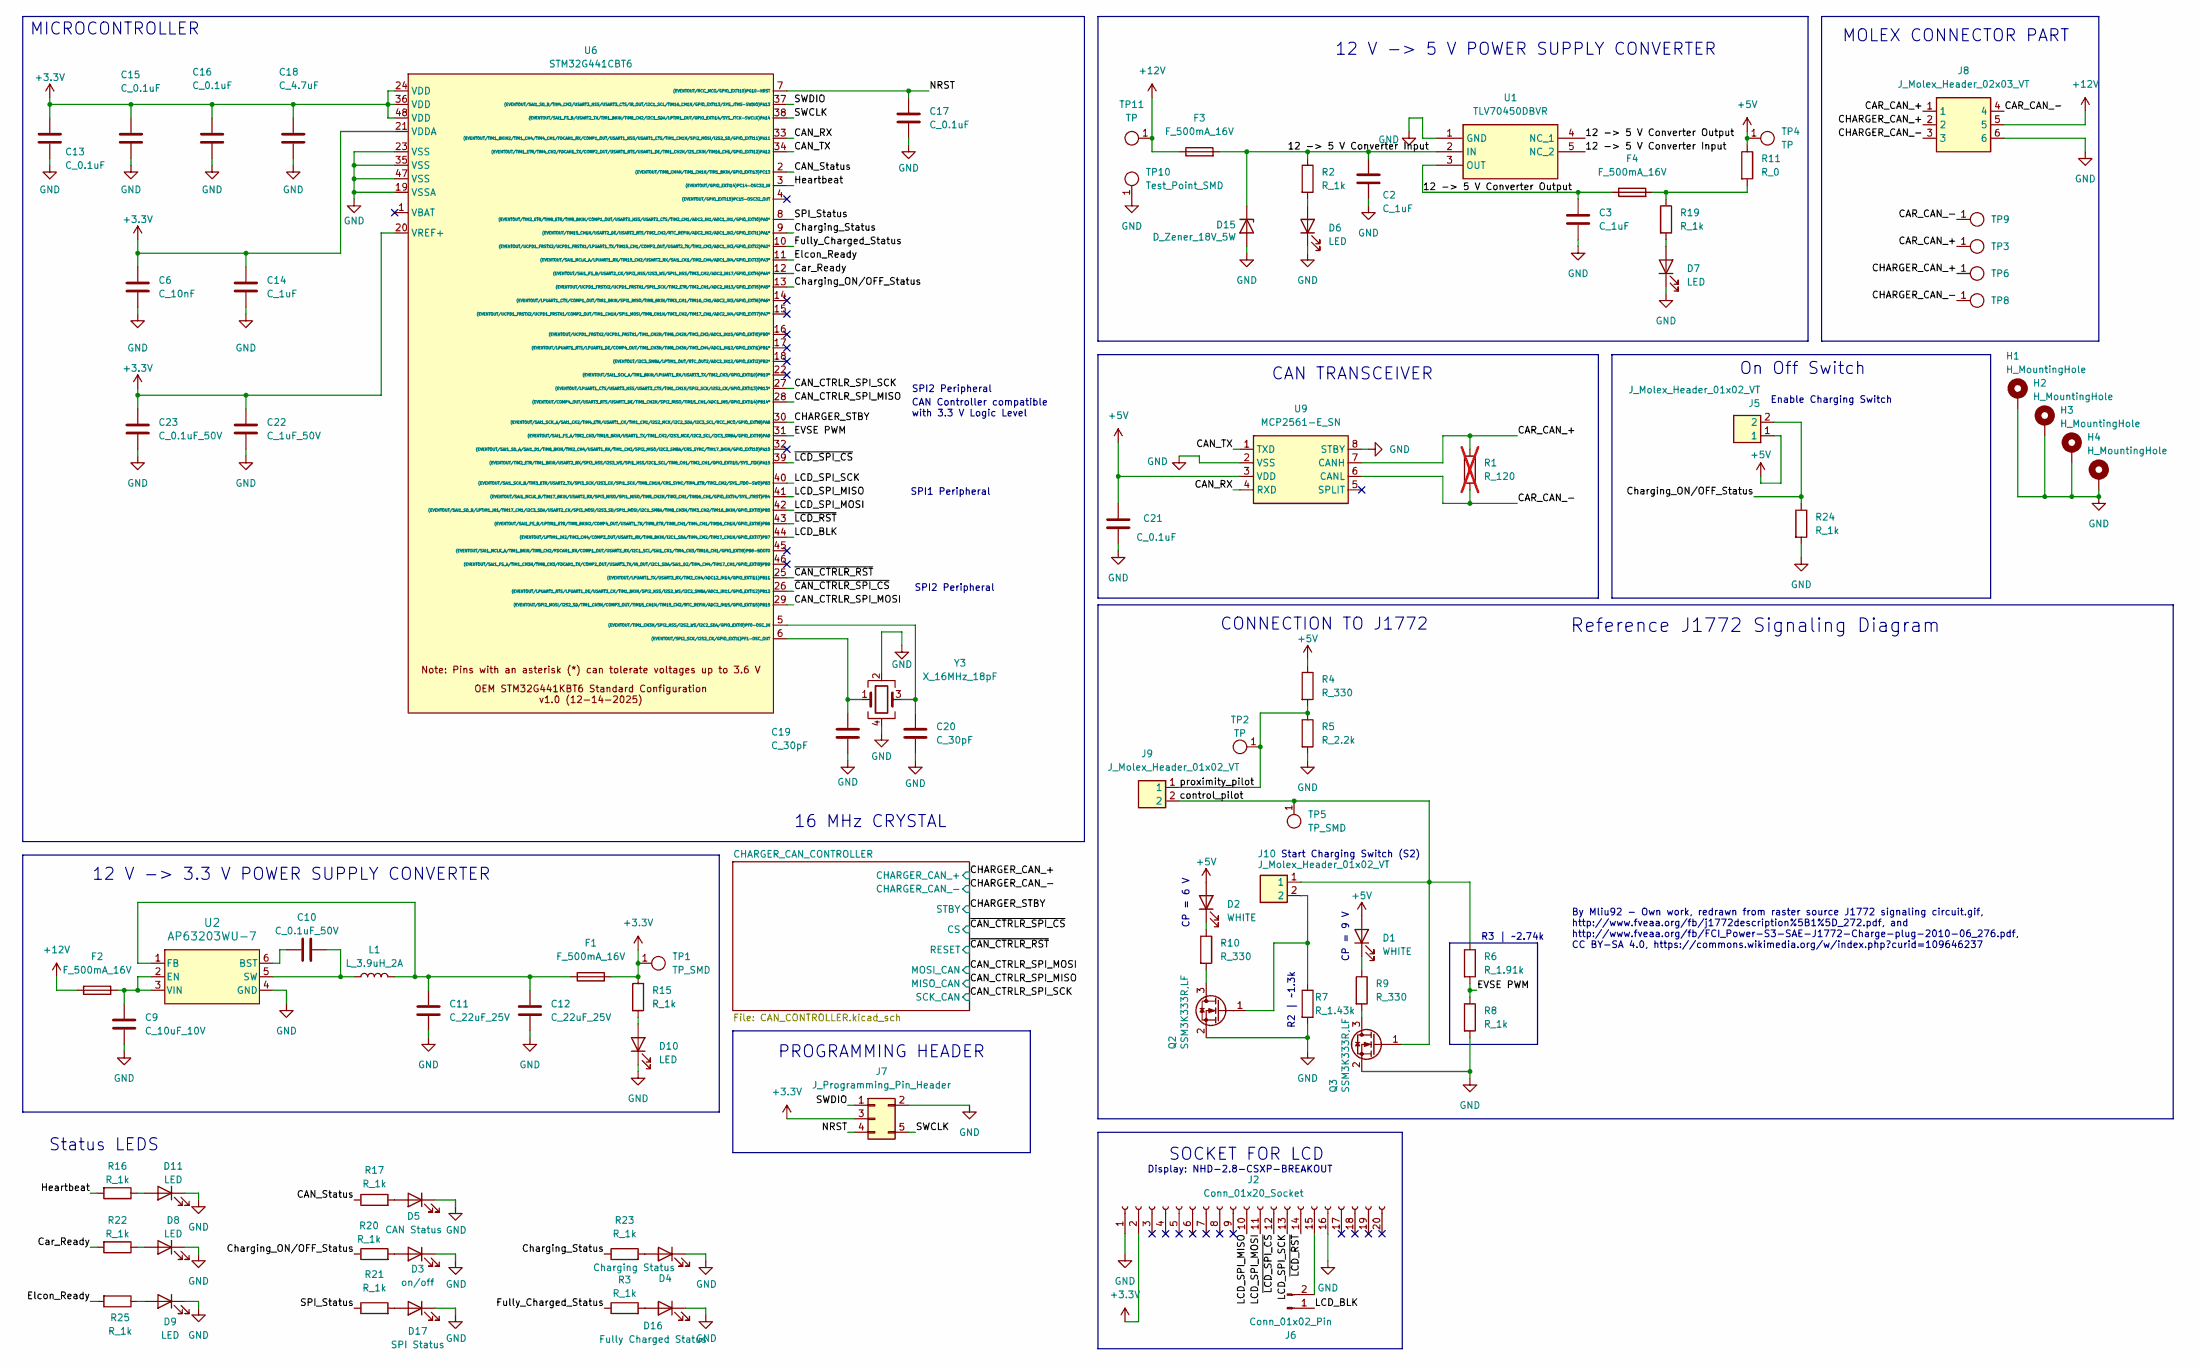
[picture p37: schematic charging_cart_controller.kicad_sch, Charging Cart Controller]

Parts:
C2, C14: C_1uF; C_0603_1608Metric; MPN UMK107BJ105KA-T
C3: C_1uF; C_0603_1608Metric; MPN CL10B105KA8NNNC
C6: C_10nF; C_0603_1608Metric; MPN CL10B103KB8NNNC
C9: C_10uF_10V; C_0603_1608Metric; MPN GRM188D71A106KA73D
C10, C23: C_0.1uF_50V; C_0603_1608Metric; MPN CL10B104KB8NNWC
C11, C12: C_22uF_25V; C_1206_3216Metric; MPN CL31A226KAHNNNE
C13, C15, C16, C17, C21: C_0.1uF; C_0603_1608Metric; MPN CL10B104KB8NNWC
C18: C_4.7uF; C_0603_1608Metric; MPN GRT188R61E475ME13D
C19, C20: C_30pF; C_0603_1608Metric; MPN CML0603C0G300JT50V
C22: C_1uF_50V; C_0603_1608Metric; MPN UMK107BJ105KA-T
D1, D2: WHITE; D_0805_2012Metric; MPN QBLP631-IW
D3: on/off; D_0805_2012Metric; MPN LTST-C171KRKT
D4: Charging Status; D_0805_2012Metric; MPN LTST-C171AKT
D5: CAN Status; D_0805_2012Metric; MPN LTST-C171TBKT
D6, D7, D8, D9, D10, D11: LED; D_0805_2012Metric; MPN QBLP631-IW
D15: D_Zener_18V_5W; D_Zener_18V_5W_DO214AA - DIOM5336X262N; MPN SMBJ5355B-TP
D16: Fully Charged Status; D_0805_2012Metric; MPN LTST-C170KGKT
D17: SPI Status; D_0805_2012Metric; MPN QBLP631-IW
F1, F2, F3, F4: F_500mA_16V; Fuse_1210_3225Metric; MPN 0ZCH0050FF2G
H1, H2, H3, H4: H_MountingHole
J2: Conn_01x20_Socket; PinSocket_1x20_P2.54mm_Vertical
J5, J9, J10: J_Molex_Header_01x02_VT; J_Molex_Header_01x02_VT - 43045-02YY_121314; MPN 43045-0212
J6: Conn_01x02_Pin; PinHeader_1x02_P2.54mm_Vertical
J7: J_Programming_Pin_Header; J_Programming_Pin_Header_Keyed
J8: J_Molex_Header_02x03_VT; J_Molex_Header_02x03_VT - 43045-06YY_121314; MPN 43045-0614
L1: L_3.9uH_2A; IND_BOURNS_SRR5018 (L_3.9uH_2A_55m_SMD); MPN SRR5018-3R9Y
Q2, Q3: SSM3K333R,LF; SOT-23-3
R1: R_120; R_0603_1608Metric; MPN RC0603FR-13120RL; not fitted
R2, R3, R8, R15, R16, R17, R19, R20, R21, R22, R23, R24, R25: R_1k; R_0603_1608Metric; MPN RMCF0603FT1K00 (or ERJ-3GEYJ102V)
R4, R9, R10: R_330; R_0603_1608Metric; MPN RMCF0603FT330R (or WR06X3300FTL)
R5: R_2.2k; R_0603_1608Metric; MPN WR06X222 JTL
R6: R_1.91k; R_0603_1608Metric; MPN RMCF0603FT1K91
R7: R_1.43k; R_0603_1608Metric; MPN RMCF0603FT1K43
R11: R_0; R_0603_1608Metric; MPN RMCF0603ZT0R00
TP1, TP3, TP5, TP6, TP8, TP9: TP_SMD; TP_Hook_SMD; MPN 5019
TP2, TP4, TP11: TP; TP_Hook_SMD; MPN 5019
TP10: Test_Point_SMD; TP_Hook_SMD; MPN 5019
U1: TLV70450DBVR; SOT-23-5; MPN TLV70450DBVR
U2: AP63203WU-7; SOT-23-6; MPN AP63203WU-7
U6: STM32G441CBT6; LQFP-48_7x7mm_P0.5mm; MPN STM32G441CBT6
U9: MCP2561-E_SN; SOIC-8_3.9x4.9mm_P1.27mm; MPN MCP2561-E/SN
Y3: X_16MHz_18pF; FA238160000MBC0 (X_16MHz_18pF_SMD - FA-238_16.0000MB-C0); MPN FA-238 16.0000MB-C0

Connections:
+3.3V: C6.1, C13.1, C14.1, C15.1, C16.1, C18.1, C22.1, C23.1, F1.2, J2.2, J7.3, R15.1, TP1.1, U6.20 (VREF+), U6.21 (VDDA), U6.24 (VDD), U6.36 (VDD), U6.48 (VDD); also elsewhere on the board
+5V: C21.1, D1.2 (A), D2.2 (A), J5.1, R4.1, R11.1, TP4.1, U9.3 (VDD); also elsewhere on the board
+12V: F2.1, F3.1, J8.5, TP11.1
/12 -> 5 V Converter Input: C2.1, D15.1 (K), F3.2, R2.1, U1.2 (IN), U1.5 (NC_2)
/12 -> 5 V Converter Output: C3.1, F4.1, U1.3 (OUT), U1.4 (NC_1)
/CAN_CTRLR_SPI_MISO: U6.28 ((EVENTOUT/COMP4_OUT/USART3_RTS/USART3_D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); also elsewhere on the board
/CAN_CTRLR_SPI_MOSI: U6.29 ((EVENTOUT/SPI2_MOSI/I2S2_SD/TIM1_CH3N/C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); also elsewhere on the board
/CAN_CTRLR_SPI_SCK: U6.27 ((EVENTOUT/LPUART1_CTS/USART3_NSS/USART3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); also elsewhere on the board
/CAN_RX: U6.33 ((EVENTOUT/TIM1_BKIN2/TIM1_CH4/TIM4_CH1/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), U9.4 (RXD)
/CAN_Status: R17.1, U6.2 ((EVENTOUT/TIM8_CH4N/TIM1_CH1N/TIM1_BKIN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)
/CAN_TX: U6.34 ((EVENTOUT/TIM1_ETR/TIM4_CH2/FDCAN1_TX/C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), U9.1 (TXD)
/CAR_CAN_+: J8.1, R1.1, TP3.1, U9.7 (CANH)
/CAR_CAN_-: J8.4, R1.2, TP9.1, U9.6 (CANL)
/CHARGER_CAN_+: J8.2, TP6.1; also elsewhere on the board
/CHARGER_CAN_-: J8.3, TP8.1; also elsewhere on the board
/CHARGER_STBY: U6.30 ((EVENTOUT/SAI1_SCK_A/SAI1_CK2/TIM4_ETR/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); also elsewhere on the board
/Car_Ready: R22.2, U6.12 ((EVENTOUT/SAI1_FS_B/USART2_CK/SPI3_NSS/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)
/Charging_ON/OFF_Status: J5.2, R20.1, R24.1, U6.13 ((EVENTOUT/UCPD1_FRSTX2/UCPD1_FRSTX1/SPI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)
/Charging_Status: R23.1, U6.9 ((EVENTOUT/TIM15_CH1N/USART2_DE/USART2_R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)
/EVSE PWM: R6.2, R8.1, U6.31 ((EVENTOUT/SAI1_FS_A/TIM2_CH3/TIM15_BKIN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)
/Elcon_Ready: R25.2, U6.11 ((EVENTOUT/SAI1_MCLK_A/LPUART1_RX/TIM15_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)
/Fully_Charged_Status: R3.1, U6.10 ((EVENTOUT/UCPD1_FRSTX2/UCPD1_FRSTX1/LPU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)
/Heartbeat: R16.2, U6.3 ((EVENTOUT/GPIO_EXTI14)PC14-OSC32_IN)
/LCD_BLK: J6.1, U6.44 ((EVENTOUT/LPTIM1_IN2/TIM3_CH4/COMP3_OUT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)
/LCD_SPI_MISO: J2.10, U6.41 ((EVENTOUT/SAI1_MCLK_B/TIM17_BKIN/USART2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)
/LCD_SPI_MOSI: J2.11, U6.42 ((EVENTOUT/SAI1_SD_B/LPTIM1_IN1/TIM17_CH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)
/LCD_SPI_SCK: J2.13, U6.40 ((EVENTOUT/SAI1_SCK_B/TIM3_ETR/USART2_TX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)
/NRST: C17.1, J7.4, U6.7 ((EVENTOUT/RCC_MCO/GPIO_EXTI10)PG10-NRST)
/SPI_Status: R21.1, U6.8 ((EVENTOUT/TIM2_ETR/TIM8_ETR/TIM8_BKIN/C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)
/SWCLK: J7.5, U6.38 ((EVENTOUT/SAI1_FS_B/USART2_TX/TIM1_BKIN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)
/SWDIO: J7.1, U6.37 ((EVENTOUT/SAI1_SD_B/TIM4_CH3/USART3_NSS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)
/control_pilot: J9.2, J10.1, Q3.1 (G), R6.1, TP5.1
/proximity_pilot: J9.1, R4.2, R5.1, TP2.1
/~CAN_CTRLR_RST: U6.25 ((EVENTOUT/LPUART1_TX/USART3_RX/TIM2_CH4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); also elsewhere on the board
/~CAN_CTRLR_SPI_CS: U6.26 ((EVENTOUT/LPUART1_RTS/LPUART1_DE/USART3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); also elsewhere on the board
/~LCD_RST: J2.14, U6.43 ((EVENTOUT/SAI1_FS_B/LPTIM1_ETR/TIM8_BKI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)
/~LCD_SPI_CS: J2.12, U6.39 ((EVENTOUT/TIM2_ETR/TIM1_BKIN/USART2_RX/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)
GND: C2.2, C3.2, C6.2, C9.2, C11.2, C12.2, C13.2, C14.2, C15.2, C16.2, C17.2, C18.2, C19.2, C20.2, C21.2, C22.2, C23.2, D3.1 (K), D4.1 (K), D5.1 (K), D6.1 (K), D7.1 (K), D8.1 (K), D9.1 (K), D10.1 (K), D11.1 (K), D15.2 (A), D16.1 (K), D17.1 (K), H1.1, H2.1, H3.1, H4.1, J2.1, J2.16, J7.2, J8.6, Q2.2 (S), Q3.2 (S), R5.2, R7.2, R8.2, R24.2, TP10.1, U1.1 (GND), U2.4 (GND), U6.19 (VSSA), U6.23 (VSS), U6.35 (VSS), U6.47 (VSS), U9.2 (VSS), U9.8 (STBY), Y3.2, Y3.4; also elsewhere on the board
unnamed: D1.1 (K), R9.1
unnamed: D2.1 (K), R10.1
unnamed: D3.2 (A), R20.2
unnamed: D4.2 (A), R23.2
unnamed: D5.2 (A), R17.2
unnamed: D6.2 (A), R2.2
unnamed: D7.2 (A), R19.2
unnamed: D8.2 (A), R22.1
unnamed: D9.2 (A), R25.1
unnamed: D10.2 (A), R15.2
unnamed: D11.2 (A), R16.1
unnamed: D16.2 (A), R3.2
unnamed: D17.2 (A), R21.2
unnamed: F4.2, R11.2, R19.1
unnamed: J2.15, J6.2
unnamed: Q2.3 (D), R10.2
unnamed: J10.2, Q2.1 (G), R7.1
unnamed: Q3.3 (D), R9.2
unnamed: C10.1, U2.6 (BST)
unnamed: C9.1, F2.2, U2.2 (EN), U2.3 (VIN)
unnamed: C11.1, C12.1, F1.1, L1.2, U2.1 (FB)
unnamed: C10.2, L1.1, U2.5 (SW)
unnamed: C19.1, U6.6 ((EVENTOUT/SPI2_SCK/I2S2_CK/GPIO_EXTI1)P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), Y3.1
unnamed: C20.1, U6.5 ((EVENTOUT/TIM1_CH3N/SPI2_NSS/I2S2_WS/I2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), Y3.3

Notes on the sheet:
Start Charging Switch (S2)
MOLEX CONNECTOR PART
PROGRAMMING HEADER
SOCKET FOR LCD
R3 | ~2.74k
SPI1 Peripheral
12 V -> 3.3 V POWER SUPPLY CONVERTER
On Off Switch
SPI2 Peripheral
CAN Controller compatible with 3.3 V Logic Level
CP = 6 V
CAN TRANSCEIVER
By Mliu92 - Own work, redrawn from raster source J1772 signaling circuit.gif, http://www.fveaa.org/fb/j1772description%5B1%5D_272.pdf, and http://www.fveaa.org/fb/FCI_Power-S3-SAE-J1772-Charge-plug-2010-06_276.pdf, CC BY-SA 4.0, https://commons.wikimedia.org/w/index.php?curid=109646237
MICROCONTROLLER
R2 | ~1.3k
CONNECTION TO J1772
16 MHz CRYSTAL
Reference J1772 Signaling Diagram
CP = 9 V
Enable Charging Switch
12 V -> 5 V POWER SUPPLY CONVERTER
Display: NHD-2.8-CSXP-BREAKOUT
Status LEDS

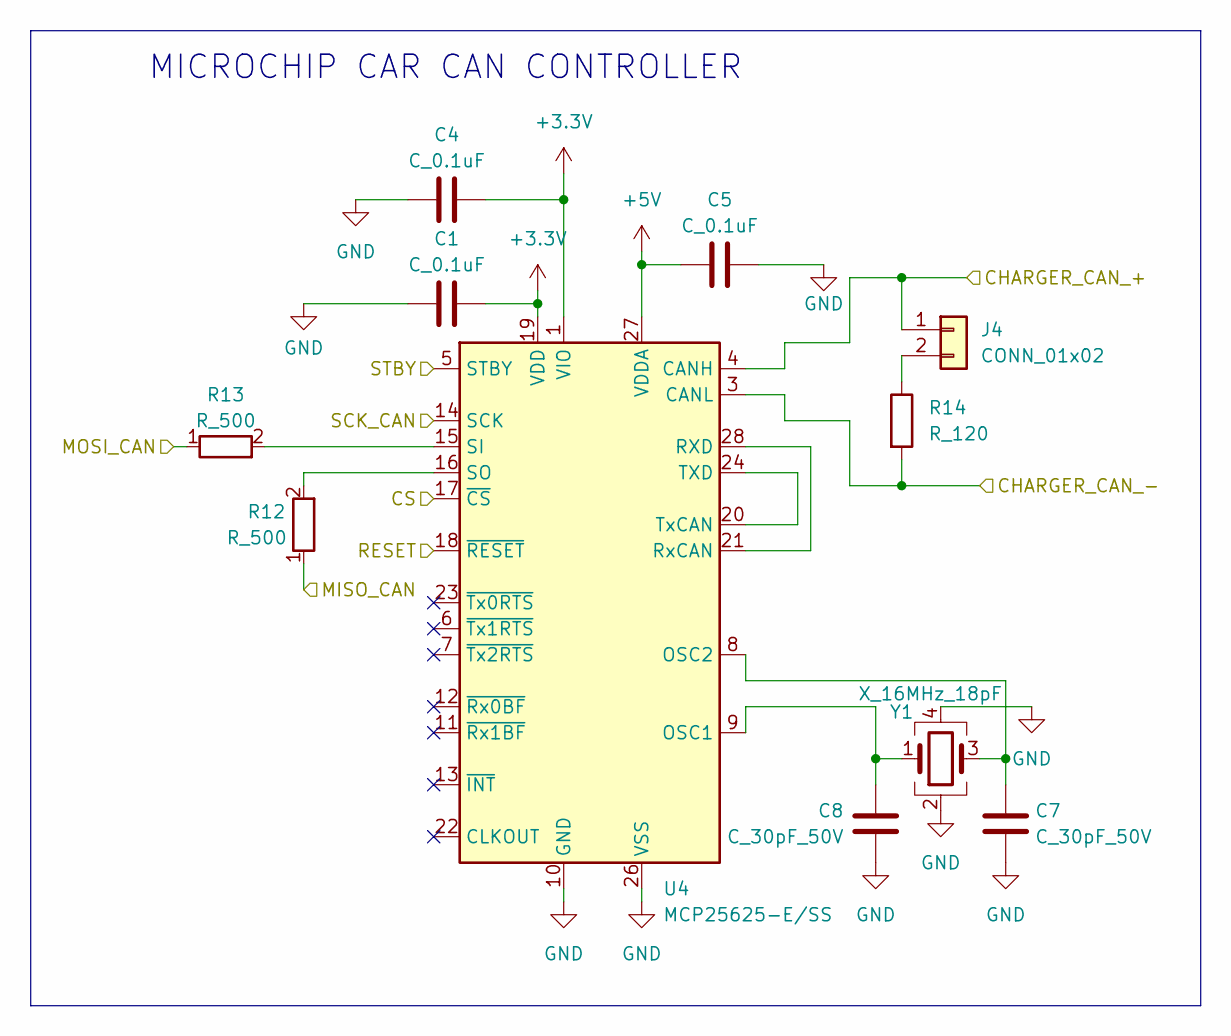
[picture p38: schematic CAN_CONTROLLER.kicad_sch, Charger CAN Controller]

Parts:
C1, C4, C5: C_0.1uF; C_0603_1608Metric; MPN CL10B104KB8NNWC
C7, C8: C_30pF_50V; C_0603_1608Metric; MPN CML0603C0G300JT50V
J4: CONN_01x02; PinHeader_1x02_P2.54mm_Vertical; MPN 732-5315-ND
R12, R13: R_500; R_0603_1608Metric; MPN 541-3305-1-ND
R14: R_120; R_0603_1608Metric; MPN 667-ERJ-6ENF1200V
U4: MCP25625-E/SS; SSOP-28_5.3x10.2mm_P0.65mm; MPN MCP25625-E/SS-ND
Y1: X_16MHz_18pF; FA238160000MBC0 (X_16MHz_18pF_SMD - FA-238_16.0000MB-C0); MPN FA-238 16.0000MB-C0

Connections:
+3.3V: C1.1, C4.1, U4.1 (VIO), U4.19 (VDD); also elsewhere on the board
+5V: C5.2, U4.27 (VDDA); also elsewhere on the board
/CAN_CTRLR_SPI_MISO: R12.1; also elsewhere on the board
/CAN_CTRLR_SPI_MOSI: R13.1; also elsewhere on the board
/CAN_CTRLR_SPI_SCK: U4.14 (SCK); also elsewhere on the board
/CHARGER_CAN_+: J4.1, U4.4 (CANH); also elsewhere on the board
/CHARGER_CAN_-: R14.2, U4.3 (CANL); also elsewhere on the board
/CHARGER_STBY: U4.5 (STBY); also elsewhere on the board
/~CAN_CTRLR_RST: U4.18 (~RESET); also elsewhere on the board
/~CAN_CTRLR_SPI_CS: U4.17 (~CS); also elsewhere on the board
GND: C1.2, C4.2, C5.1, C7.2, C8.2, U4.10 (GND), U4.26 (VSS), Y1.2, Y1.4; also elsewhere on the board
unnamed: J4.2, R14.1
unnamed: C8.1, U4.9 (OSC1), Y1.1
unnamed: C7.1, U4.8 (OSC2), Y1.3
unnamed: U4.21 (RxCAN), U4.28 (RXD)
unnamed: R13.2, U4.15 (SI)
unnamed: R12.2, U4.16 (SO)
unnamed: U4.20 (TxCAN), U4.24 (TXD)

Notes on the sheet:
MICROCHIP CAR CAN CONTROLLER

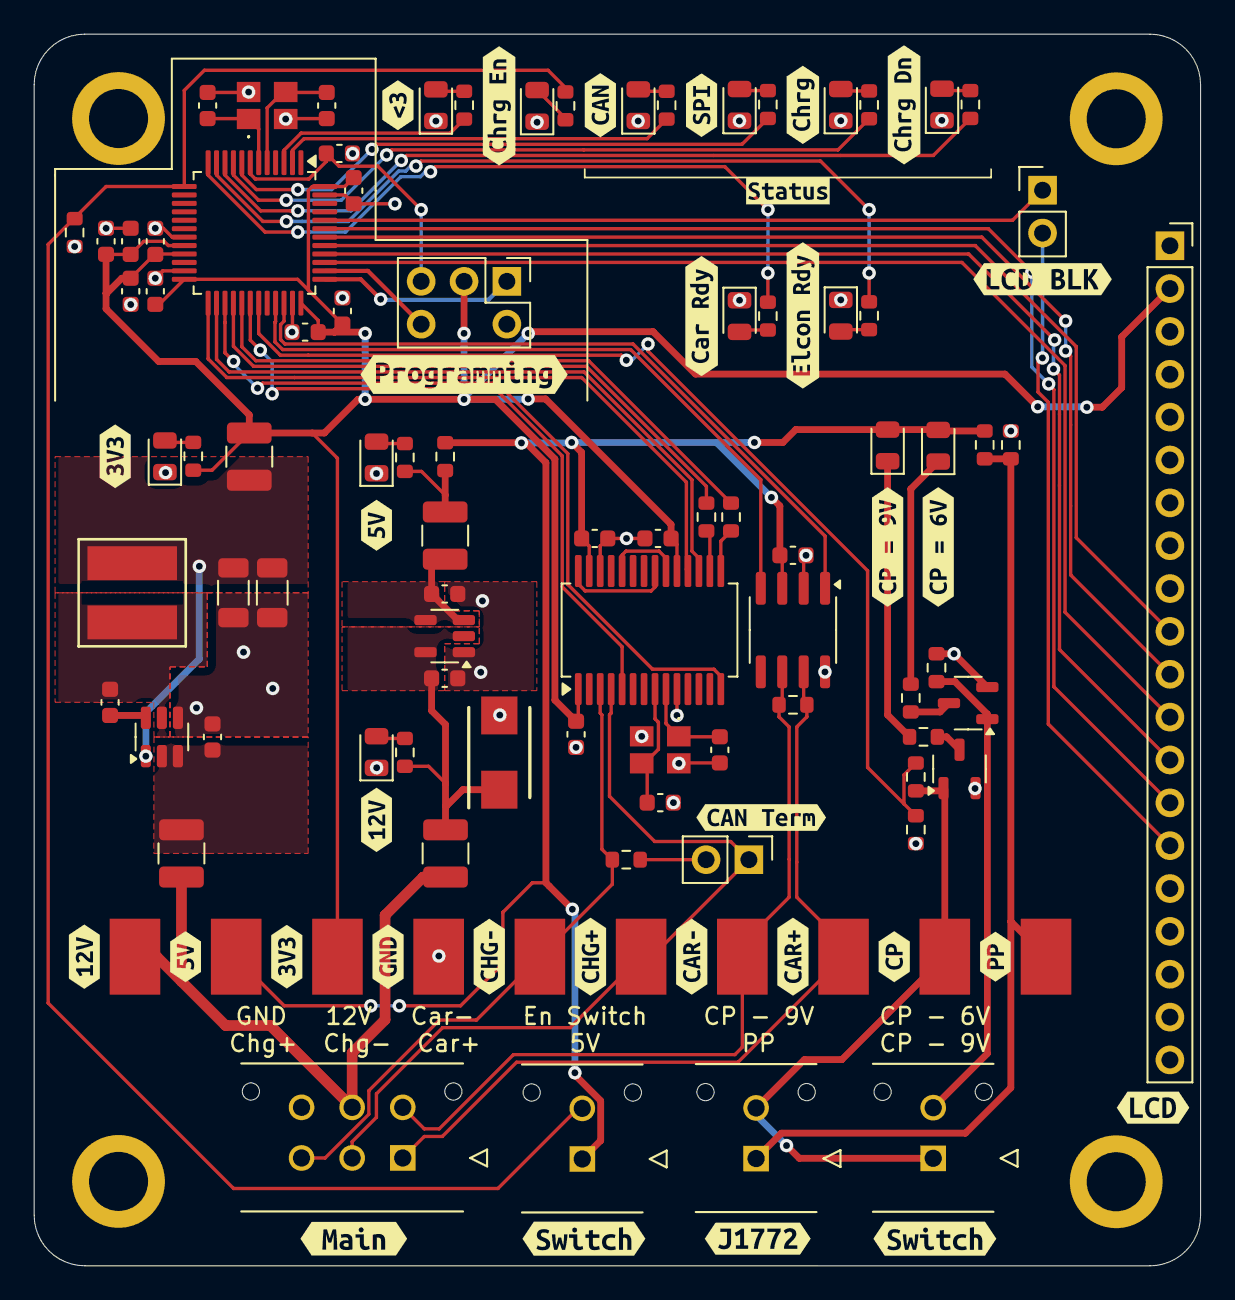
[picture p39: board charging_cart_controller.kicad_pcb from above]

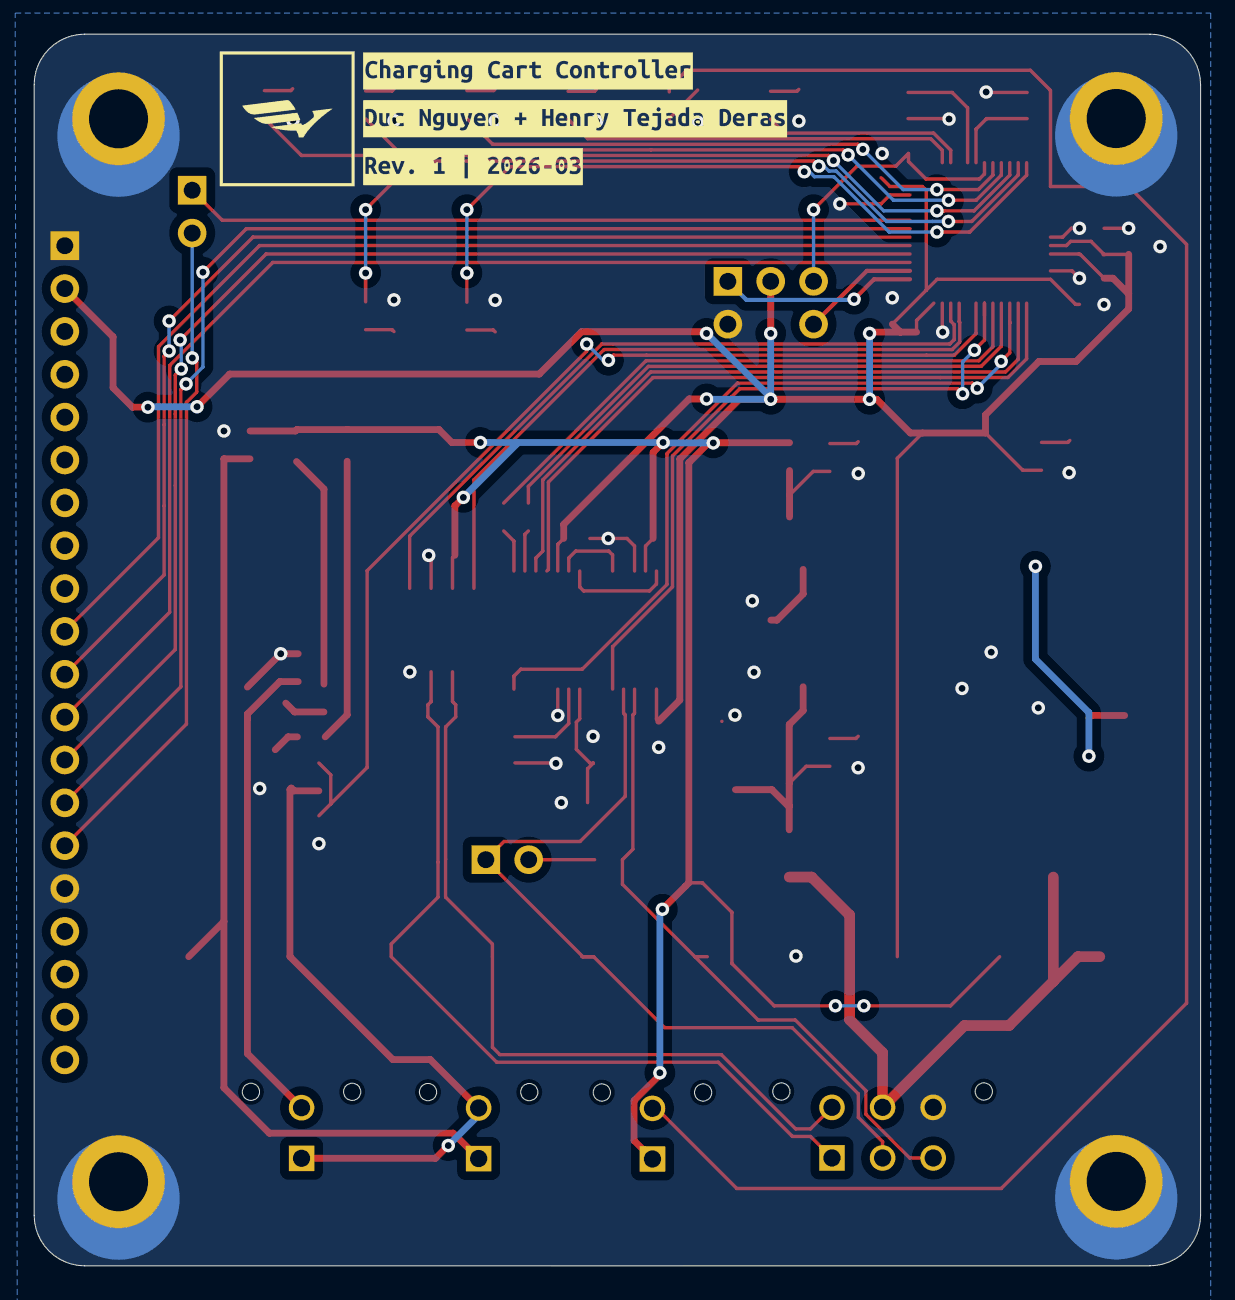
[picture p40: board charging_cart_controller.kicad_pcb from below]

Board: 2 copper layers, 69.1 x 73.0 mm, 132 parts (3 on the bottom side), 69 nets.

Other parts of the board:
kibuzzard-69B5A4A4: G***; kibuzzard-69B5A4A4
kibuzzard-69B5A49D: G***; kibuzzard-69B5A49D
kibuzzard-69B5A184: G***; kibuzzard-69B5A184
kibuzzard-69B5A189: G***; kibuzzard-69B5A189
kibuzzard-69B6B8E8: G***; kibuzzard-69B6B8E8
kibuzzard-69B6B8EC: G***; kibuzzard-69B6B8EC
kibuzzard-69B6B9E1: G***; kibuzzard-69B6B9E1
kibuzzard-69B6B40C: G***; kibuzzard-69B6B40C
kibuzzard-69B6BA0D: G***; kibuzzard-69B6BA0D
kibuzzard-69B6BA6C: G***; kibuzzard-69B6BA6C
kibuzzard-69B6BA12: G***; kibuzzard-69B6BA12
kibuzzard-69B6BC07: G***; kibuzzard-69B6BC07
kibuzzard-69B6BF6C: G***; kibuzzard-69B6BF6C
kibuzzard-69B6BF72: G***; kibuzzard-69B6BF72
kibuzzard-69B6C89F: G***; kibuzzard-69B6C89F
kibuzzard-69B6C98F: G***; kibuzzard-69B6C98F
kibuzzard-69B6CA04: G***; kibuzzard-69B6CA04
kibuzzard-69B85D85: G***; kibuzzard-69B85D85
kibuzzard-69B545AB, kibuzzard-69B545AB#2: G***; kibuzzard-69B545AB
kibuzzard-69B545D0, kibuzzard-69B545D0#2: G***; kibuzzard-69B545D0
kibuzzard-69B545E8, kibuzzard-69B545E8#2: G***; kibuzzard-69B545E8
kibuzzard-69B626F3: G***; kibuzzard-69B626F3
kibuzzard-69B856EE: G***; kibuzzard-69B856EE
kibuzzard-69B858C4: G***; kibuzzard-69B858C4
kibuzzard-69B861A4: G***; kibuzzard-69B861A4
kibuzzard-69B6277C: G***; kibuzzard-69B6277C
kibuzzard-69B62712: G***; kibuzzard-69B62712
kibuzzard-69B62739: G***; kibuzzard-69B62739
kibuzzard-69B62752: G***; kibuzzard-69B62752
kibuzzard-69B62762: G***; kibuzzard-69B62762
kibuzzard-69B62772: G***; kibuzzard-69B62772
kibuzzard-69B85855: G***; kibuzzard-69B85855
