olin-electric-motorsports/oem-monorepo/vehicle/mkviii/hardware/lv/rkh/rkh.kicad_pcb

## KiCad design vehicle/mkviii/hardware/lv/rkh/rkh.kicad_pcb (2026-04-04)

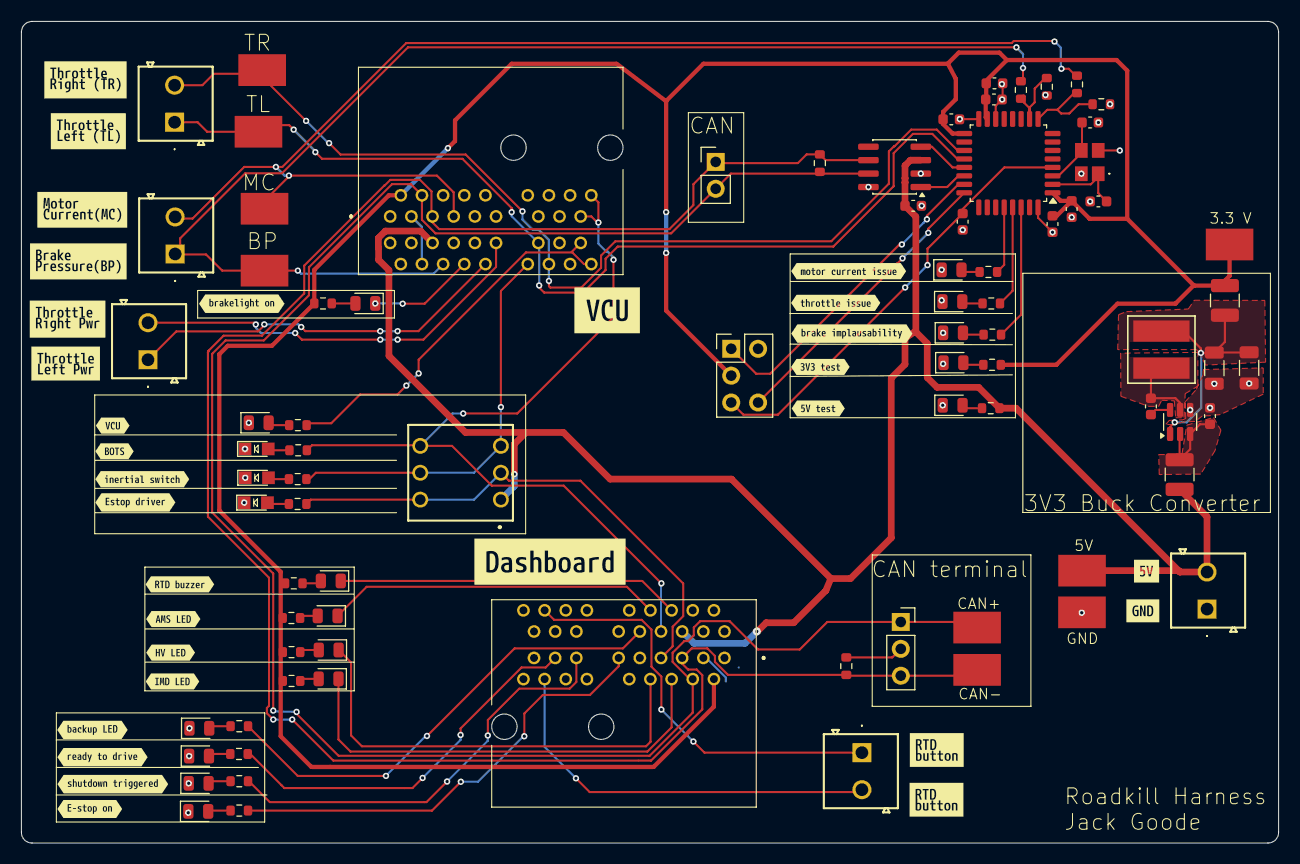
[picture p41: board rkh.kicad_pcb from above]

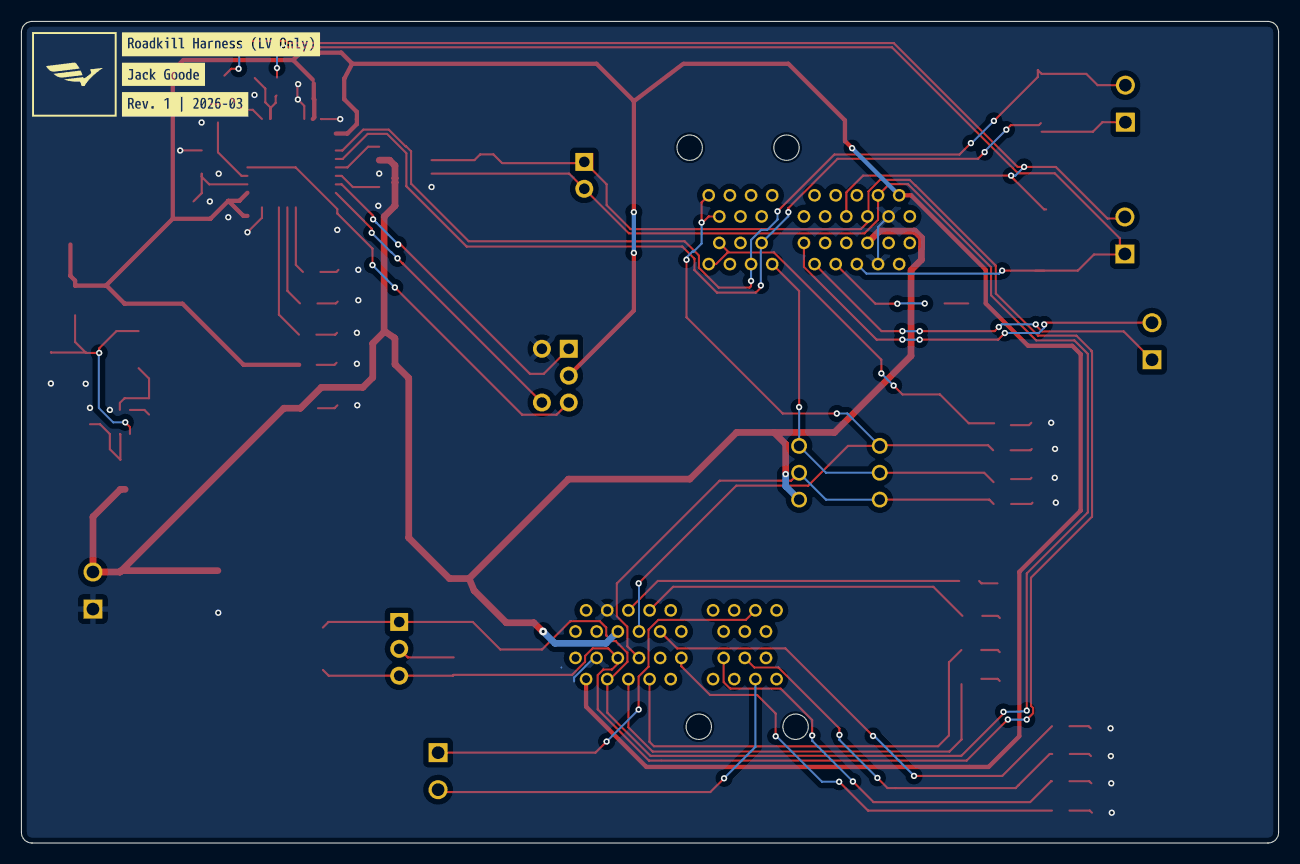
[picture p42: board rkh.kicad_pcb from below]

Board: 2 copper layers, 118.8 x 77.6 mm, 115 parts (3 on the bottom side), 61 nets.

Parts:
C1: C_10uF_10V; C_0603_1608Metric
C2, C4, C6, C10: C_0.1uF_16V; C_0603_1608Metric
C3, C12: C_22uF_25V; C_1206_3216Metric
C5: C_1uF_25V; C_0603_1608Metric
C7, C8: 30pF; C_0603_1608Metric
C9: C_4.7uF_25V; C_0603_1608Metric
C11: C_10nF_50V; C_0603_1608Metric
C13: 0u1F; C_0603
D1, D2, D3, D4, D5, D6, D7, D8, D9, D10, D12, D13, D14, D15, D16: LED; D_0805_2012Metric
D11, D19, D20: LED; LED_0805_OEM
Dashboard_PCIE1: pcie_x1; pcie_x_delete_asap
F1, F2: Fuse; Fuse_1210_3225Metric
J1, J2, J4, J6, J9: TWO_WIRE_SCREW_TERMINAL; wire_terminal_delete_asap
J3: J_PCIe_x1; pcie_x_delete_asap
J5: J_Programming_Pin_Header; J_Programming_Pin_Header_Keyed
J7: Conn_01x03_Pin; PinSocket_1x03_P2.54mm_Vertical
J8: Conn_01x02_Pin; PinHeader_1x02_P2.54mm_Vertical
L_3.9uH1: L; IND_BOURNS_SRR5018 (L_3.9uH_2A_55m_SMD)
R1, R2, R3, R4, R5, R6, R7, R8, R9, R11, R12, R15, R17, R18, R20, R21: R_1k_0.1W; R_0603_1608Metric
R10: R_120; R_0603
R16: R_120k; R_0603_1608Metric
R19: R_5k; R_0603_1608Metric
R22, R25: R__5k; R_0603_1608Metric
R23, R24: R_10k; R_0603_1608Metric
R26: R_120; R_0603_1608Metric
S1: DS01C-254-L-03BE; SW_DS01C254L03BE
TP1, TP2, TP3, TP4: TestPoint; test_point_delete_asap
TP5, TP6, TP7, TP8, TP9: TP_SMD; TP_Hook_SMD
U1: AP63203WU-7; SOT-23-6
U2: Roadkill_MCU; LQFP-32_7x7mm_P0.8mm
U4: MCP2561-E-SN; SOIC-8_3.9x4.9mm_P1.27mm
Y1: Crystal_16MHz_18pF; FA238160000MBC0 (X_16MHz_18pF_SMD - FA-238_16.0000MB-C0)
kibuzzard-69A0E4A7: G***; kibuzzard-69A0E4A7
kibuzzard-69A0E477: G***; kibuzzard-69A0E477
kibuzzard-69A764DF: G***; kibuzzard-69A764DF
kibuzzard-69A764E7: G***; kibuzzard-69A764E7
kibuzzard-69A764F6, kibuzzard-69A764F6#2: G***; kibuzzard-69A764F6
kibuzzard-69A766BA: G***; kibuzzard-69A766BA
kibuzzard-69A76600: G***; kibuzzard-69A76600
kibuzzard-69A76676: G***; kibuzzard-69A76676
kibuzzard-69A76791: G***; kibuzzard-69A76791
kibuzzard-69AA1B5D: G***; kibuzzard-69AA1B5D
kibuzzard-69AA1B51: G***; kibuzzard-69AA1B51
kibuzzard-69AA3EC3: G***; kibuzzard-69AA3EC3
kibuzzard-69AA3EDE: G***; kibuzzard-69AA3EDE
kibuzzard-69B8BF7C: G***; kibuzzard-69B8BF7C
kibuzzard-69B8BF88: G***; kibuzzard-69B8BF88
kibuzzard-69B8C0D1: G***; kibuzzard-69B8C0D1
kibuzzard-69B8C11E: G***; kibuzzard-69B8C11E
kibuzzard-69B8C173: G***; kibuzzard-69B8C173
kibuzzard-699FCAAF: G***; kibuzzard-699FCAAF
kibuzzard-699FCAF0: G***; kibuzzard-699FCAF0
kibuzzard-699FCB9F: G***; kibuzzard-699FCB9F
kibuzzard-699FCB70: G***; kibuzzard-699FCB70
kibuzzard-699FD2AF: G***; kibuzzard-699FD2AF
kibuzzard-699FD2CF: G***; kibuzzard-699FD2CF
kibuzzard-699FD2EF: G***; kibuzzard-699FD2EF
kibuzzard-699FD5DE: G***; kibuzzard-699FD5DE
kibuzzard-699FD9DF: G***; kibuzzard-699FD9DF
kibuzzard-699FD9F6: G***; kibuzzard-699FD9F6
kibuzzard-699FD92B: G***; kibuzzard-699FD92B
kibuzzard-699FD93E: G***; kibuzzard-699FD93E
kibuzzard-699FD307: G***; kibuzzard-699FD307
kibuzzard-699FD955: G***; kibuzzard-699FD955

Connections:
+3.3V: C4.2, C5.1, C9.1, C10.2, C11.1, Dashboard_PCIE1.A2 (3.3V), F2.2, J3.A2 (3.3V), J5.3, R1.1, R7.1, R11.1, R18.2, R20.1, R21.1, TP8.1, U2.1 (VDD), U2.15 (VDDA), U2.17 (VDD)
+5V: C13.1, Dashboard_PCIE1.B5 (5V), F1.1, J3.B5 (5V), J9.2, R17.2, S1.1 (COM_1), TP7.1, U4.3 (VDD)
/AMS_LED_LOW_SIDE: D16.1 (K), Dashboard_PCIE1.B8 (io_5)
/BACKUP_LED: Dashboard_PCIE1.B9 (io_7), R9.1
/BRAKE_IMPLAUSABILITY: R5.2, U2.30 ((TIM3_CH4/TIM4_CH2/TIM17_CH1N/GPIO_EXTI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)
/BRAKE_LIGHT: D1.1 (K), J3.B8 (io_5)
/BRAKE_PRESSURE: J3.B6 (io_1), J4.1, R25.2, TP1.1
/CAN_+: Dashboard_PCIE1.A4 (CAN+), J3.A4 (CAN+), J7.1, J8.2, R10.1, TP5.1, U4.7 (CANH)
/CAN_-: Dashboard_PCIE1.A5 (CAN-), J3.A5 (CAN-), J7.3, J8.1, R10.2, R16.1, TP6.1, U4.6 (CANL)
/CAN_RX: U2.21 ((FDCAN1_RX/GPIO_EXTI11)PA11), U4.4 (RXD)
/CAN_TX: U2.22 ((FDCAN1_TX/GPIO_EXTI12)PA12), U4.1 (TXD)
/E_STOP_ON: Dashboard_PCIE1.A11 (io_10), R2.1
/HV_LED_LOW_SIDE: D15.1 (K), Dashboard_PCIE1.A8 (io_4)
/IMD_LED_LOW_SIDE: D9.1 (K), Dashboard_PCIE1.A6 (io_0)
/MOTOR_CURRENT: J3.A7 (io_2), J4.2, R22.2, TP2.1
/MOTOR_CURRENT_ISSUE: R6.2, U2.28 ((TIM17_CH1/SPI1_MOSI/TIM3_CH2/TIM16_BKI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)
/NRST: C6.2, J5.4, U2.4 ((GPIO_EXTI10)PG10-NRST)
/READY_TO_DRIVE: Dashboard_PCIE1.A15 (io_18), R4.1
/RTD_BUZZER_LOW_SIDE: D12.1 (K), Dashboard_PCIE1.B6 (io_1)
/SHDN_IN_VCU: Dashboard_PCIE1.B7 (io_3), J3.A17 (SHDN_IN/io_22), J3.A18 (SHDN_IN/io_24), R26.2, S1.6 (NO_3)
/SHDN_OUT_VCU: J3.B17 (SHDN_OUT/io_23), J3.B18 (SHDN_OUT/io_25), R15.2
/SHUTDOWN_CIRCUIT_TRIGGERED: Dashboard_PCIE1.A13 (io_14), R3.1
/SS_ESTOP_DRIVER: Dashboard_PCIE1.A7 (io_2), R12.2, S1.2 (NO_1), S1.3 (COM_2)
/SS_INERTIA_SWITCH: J3.B12 (io_13), R19.2, S1.4 (NO_2), S1.5 (COM_3)
/SWCLK: J5.5, U2.24 ((SYS_JTCK-SWCLK/GPIO_EXTI14)PA14)
/SWDIO: J5.1, U2.23 ((SYS_JTMS-SWDIO/GPIO_EXTI13)PA13)
/THROTTLE_ISSUE: R8.2, U2.29 ((TIM4_CH1/TIM16_CH1N/GPIO_EXTI6)PB6)
/THROTTLE_L+: J2.1, J3.B13 (io_15), TP4.1, U2.20 ((TIM2_CH4/USART1_RX/TIM17_BKIN/GPIO_EXT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)
/THROTTLE_POWER_L: J3.B10 (io_9), J6.1
/THROTTLE_POWER_R: J3.B11 (io_11), J6.2
/THROTTLE_R+: J2.2, J3.B14 (io_17), TP3.1, U2.19 ((TIM2_CH3/TIM15_BKIN/USART1_TX/GPIO_EXT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)
GND: C1.2, C3.2, C4.1, C5.2, C6.1, C7.2, C8.2, C9.2, C10.1, C11.2, C12.2, C13.2, D2.1 (K), D3.1 (K), D4.1 (K), D5.1 (K), D6.1 (K), D7.1 (K), D8.1 (K), D10.1 (K), D11.1 (K), D13.1 (K), D14.1 (K), D19.1 (K), D20.1 (K), Dashboard_PCIE1.A3 (GND), Dashboard_PCIE1.B4 (GND), J3.A3 (GND), J3.B4 (GND), J5.2, J9.1, R23.1, R24.1, TP9.1, U1.4 (GND), U2.14 (VSSA), U2.16 (VSS), U2.32 (VSS), U4.2 (VSS), U4.8 (STBY), Y1.2, Y1.4
unnamed: D1.2 (A), R1.2
unnamed: D2.2 (A), R2.2
unnamed: D3.2 (A), R3.2
unnamed: D4.2 (A), R4.2
unnamed: D5.2 (A), R6.1
unnamed: D6.2 (A), R5.1
unnamed: D7.2 (A), R8.1
unnamed: D8.2 (A), R9.2
unnamed: D9.2 (A), R7.2
unnamed: D10.2 (A), R17.1
unnamed: D11.2 (A), R12.1
unnamed: D12.2 (A), R11.2
unnamed: D13.2 (A), R18.1
unnamed: D14.2 (A), R15.1
unnamed: D15.2 (A), R20.2
unnamed: D16.2 (A), R21.2
unnamed: D19.2 (A), R19.1
unnamed: D20.2 (A), R26.1
unnamed: Dashboard_PCIE1.A16 (io_20), J1.2
unnamed: Dashboard_PCIE1.B16 (io_21), J1.1
unnamed: J7.2, R16.2
unnamed: C2.1, U1.6 (BST)
unnamed: C1.1, F1.2, U1.2 (EN), U1.3 (VIN)
unnamed: C3.1, C12.1, F2.1, L_3.9uH1.2, U1.1 (FB)
unnamed: C2.2, L_3.9uH1.1, U1.5 (SW)
unnamed: R24.2, R25.1, U2.10 ((TIM2_ETR/TIM2_CH1/GPIO_EXTI5/ADC2_IN13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)
unnamed: R22.1, R23.2, U2.9 ((USART2_CK/TIM3_CH2/GPIO_EXTI4/ADC2_IN1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)
unnamed: C8.1, U2.2 (PF0-OSC_IN), Y1.1
unnamed: C7.1, U2.3 (PF1-OSC_OUT), Y1.3
