olin-electric-motorsports/oem-monorepo/vehicle/mkviii/hardware/hv/tsal-ail/tsal-ail.kicad_pcb

## KiCad design vehicle/mkviii/hardware/hv/tsal-ail/tsal-ail.kicad_pcb (2026-01-27)

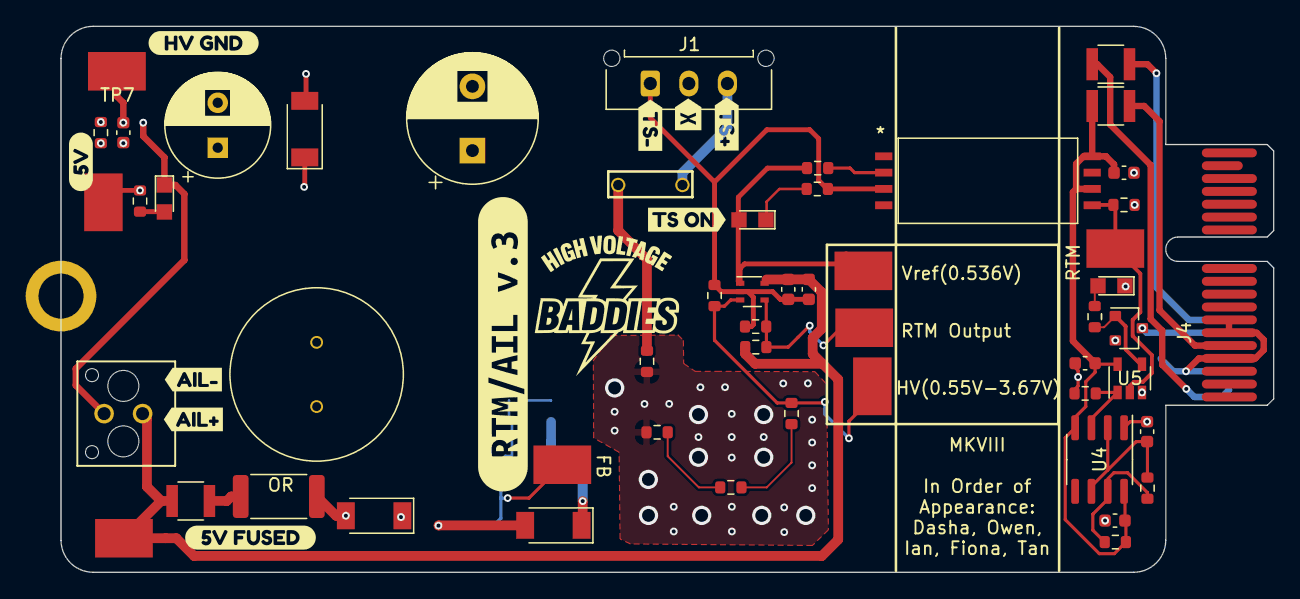
[picture p43: board tsal-ail.kicad_pcb from above]

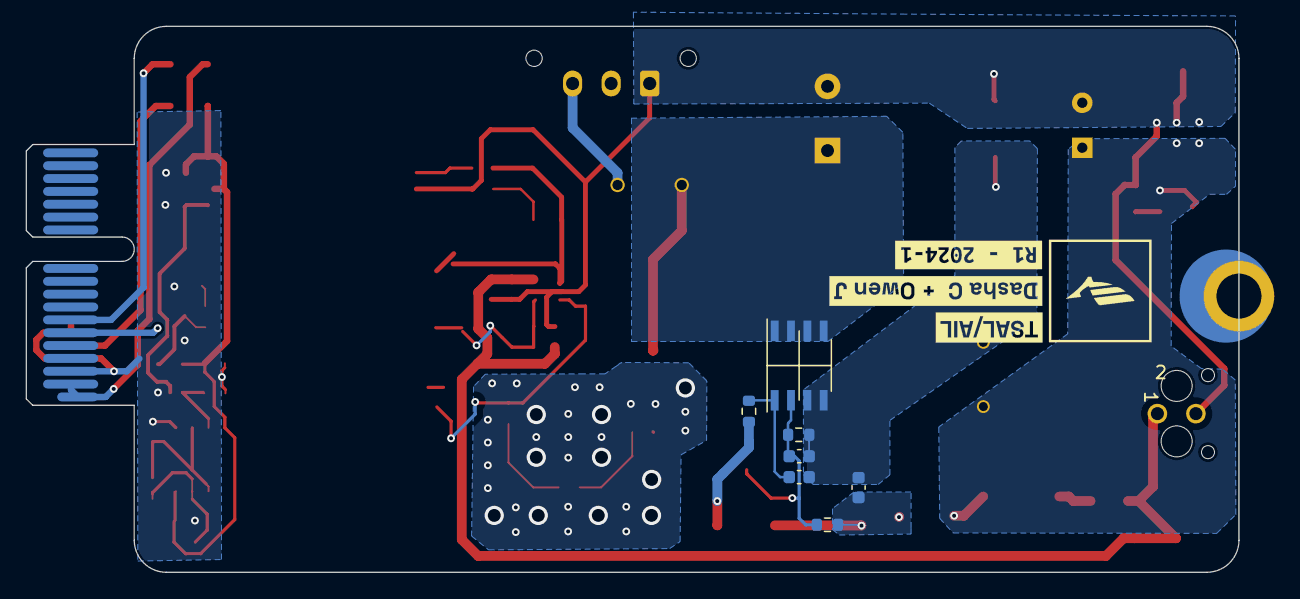
[picture p44: board tsal-ail.kicad_pcb from below]

Board: 2 copper layers, 94.4 x 42.5 mm, 74 parts (10 on the bottom side), 32 nets.

Parts:
C1: 10uF+; CP_Radial_D10.0mm_P5.00mm
C2: C_2.2uF; C_0603
C3: C_470pF; C_0603
C4: C_.22uF; C_0603
C5: C_10uF; C_0603
C6, C9, C10, C11, C12: 0.1uF; C_0603
C7: 100uF+; CP_Radial_D8.0mm_P3.50mm
C8: C_1uF; C_0603
D1, D2, D3: STTH1R06AF; D_SOD-128
D4: LED_0805; CHIPLED_0805
D5: LED_WHITE; CHIPLED_0805
D6: LED_AMBER; CHIPLED_0805
F1: F_21mA_420V
F2, F3: F_500mA_16V; Fuse_1210
F4: F_5000mA_16V; Fuse_1210
H1: M.2_MountingHole; M.2_Mount
J1: Conn_01x03; Molex_Micro-Fit_3.0_43650-0315_1x03_P3.00mm_Vertical
J2: MicroFit_V_2
J4: CONN_pcie_x1; pcie_x1
L1: L_1.2mH
Q2: SSM3K333R; SOT-23F
R1, R4, R7, R8: R_270K; R_0603
R2, R11, R12, R15: R_1K; R_0603
R3: R_120; R_0603
R5, R6, R17, R101: R_10K; R_0603
R9, R10: R_23.7K; R_0603
R13: R_3K; R_0603
R14: R_499; R_0603
R16: R_0_2512; R_2512_6332Metric
R20: R_6.04K; R_0603
R21: R_71.5K; R_0603
TP1: VREF; Test_Point_SMD
TP2: FB; Test_Point_SMD
TP3: 5V+_OUTPUT_FUSED; Test_Point_SMD
TP4: VIN; Test_Point_SMD
TP5: COMPARATOR_OUTPUT; Test_Point_SMD
TP6: 5V+_OUTPUT; Test_Point_SMD
TP7: TS-; Test_Point_SMD
TP8: TSAL_FLAG; Test_Point_SMD
U1: MP9488; Converter_DCDC_MPS_MP9488
U2: MCP6001; SOT-353_SC-70-5
U3: ACNT-H50L-500E
U4: NE555D; SOIC-8_3.9x4.9mm_P1.27mm
U5: U_GATE_SN74LVC1G08DBVR; SOT-23-5_OEM
kibuzzard-63AC91FD: G***; kibuzzard-63AC91FD
kibuzzard-63AC93EB: G***; kibuzzard-63AC93EB
kibuzzard-63AC93FC: G***; kibuzzard-63AC93FC
kibuzzard-63AC9220: G***; kibuzzard-63AC9220
kibuzzard-63AC9283: G***; kibuzzard-63AC9283
kibuzzard-63AC9446: G***; kibuzzard-63AC9446
kibuzzard-63AC9456: G***; kibuzzard-63AC9456
kibuzzard-63AD0077: G***; kibuzzard-63AD0077
kibuzzard-63D843BA: G***; kibuzzard-63D843BA
kibuzzard-63D84460: G***; kibuzzard-63D84460
kibuzzard-673C33E6: G***; kibuzzard-673C33E6
kibuzzard-6784A725: G***; kibuzzard-6784A725
kibuzzard-6784B342: G***; kibuzzard-6784B342

Connections:
+5V: C9.1, C10.1, C11.2, F3.1, R9.1, U3.6, U3.8, U4.4 (R), U4.8 (VCC), U5.5 (VCC)
+12V: F4.1, J4.A7 (io_2)
/+5V_TS_FUSED: C5.2, C6.2, F2.1, J2.1, R2.2, TP3.1, U2.5 (V+)
/FB: C3.1, R20.1, R21.2, TP2.1, U1.2 (FB)
/FLASH_2HZ: R101.1, U4.3 (Q), U5.1 (in)
/RTM_LIGHT-: J4.A6 (io_0), Q2.3 (D)
/SW: C2.2, C3.2, C4.2, D2.1 (K), L1.1, R20.2, U1.3 (SW), U1.4 (SW)
/TS+: F1.2, J1.3
/TS+_FUSED: C1.1, F1.1, R1.2, U1.5 (NC), U1.6 (NC), U1.7 (VIN), U1.8 (NC)
/TS-: C1.2, C5.1, C6.1, C7.2, C8.2, D2.2 (A), D5.1 (K), J1.1, J2.2, R3.2, R6.2, R12.2, R13.2, TP7.1, U2.2 (V-), U3.3
/TSAL_FLAG: R17.1, TP8.1, U3.5, U5.2 (in)
/VCC: C2.1, R5.2, U1.1 (VCC)
GND: C9.2, C10.2, C11.1, C12.1, D6.1 (K), J4.A3 (GND), J4.B4 (GND), J4.B6 (io_1), J4.B7 (io_3), Q2.2 (S), R17.2, R101.2, U4.1 (GND), U5.3 (GND)
unnamed: C4.1, D1.2 (A), D3.1 (K), R21.1
unnamed: D1.1 (K), R5.1
unnamed: C7.1, C8.1, D3.2 (A), L1.2, R13.1, R15.1, R16.2, TP6.1
unnamed: D4.2 (A), R14.2, TP5.1, U2.1
unnamed: D4.1 (K), R12.1
unnamed: D5.2 (A), R15.2
unnamed: D6.2 (A), R11.2
unnamed: F2.2, R16.1
unnamed: F4.2, J4.A1 (12V/3V(DA_ONLY)), J4.A2 (12V/3V(DA_ONLY))
unnamed: F3.2, J4.B5 (5V)
unnamed: Q2.1 (G), R11.1, U5.4 (out)
unnamed: R1.1, R4.2
unnamed: R4.1, R7.2
unnamed: R7.1, R8.2
unnamed: R14.1, U3.2
unnamed: R6.1, R8.1, TP4.1, U2.3 (+)
unnamed: R2.1, R3.1, TP1.1, U2.4 (-)
unnamed: R9.2, R10.1, U4.7 (DIS)
unnamed: C12.2, R10.2, U4.2 (TR), U4.6 (THR)
