olin-electric-motorsports/oem-monorepo/vehicle/mkviii/hardware/integration/bms_core/bms_core.kicad_pcb

## KiCad design vehicle/mkviii/hardware/integration/bms_core/bms_core.kicad_pcb (2026-02-10)

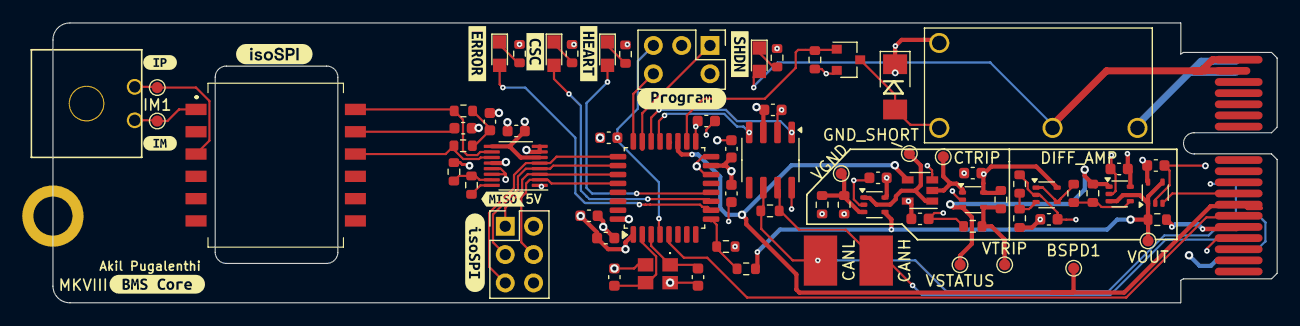
[picture p45: board bms_core.kicad_pcb from above]

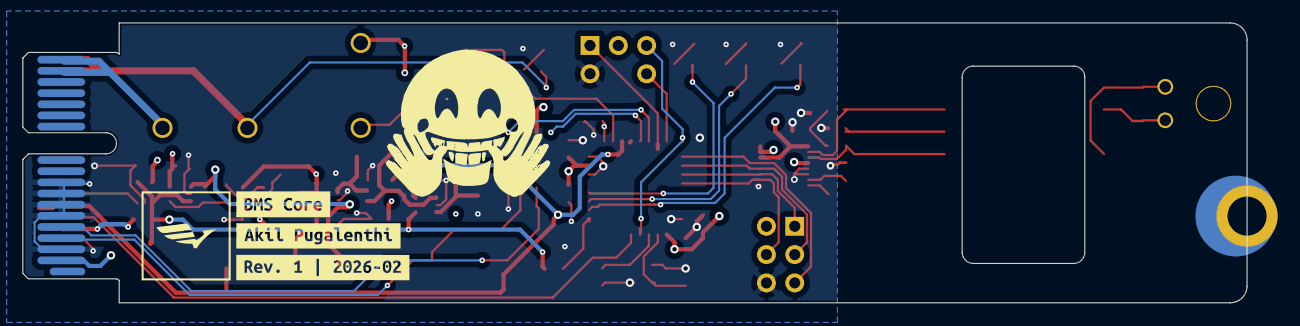
[picture p46: board bms_core.kicad_pcb from below]

Board: 4 copper layers, 109.8 x 25.1 mm, 87 parts (3 on the bottom side), 48 nets.

Parts:
BSPD1: BSPD_CURRENT_THRESH; TestPoint_Pad_D1.0mm
C1, C16, C17, C21, C22: C_0.1uF_16V; C_0603_1608Metric
C6, C9, C10, C11, C12, C13: C_0.1uF; C_0603
C7, C8: C_10nF; C_0603
C14, C15: C_30pF_50V; C_0603_1608Metric
C18: C_4.7uF_25V; C_0603_1608Metric
C19: C_10nF_50V; C_0603_1608Metric
C20: C_1uF_25V; C_0603_1608Metric
CANH: CANH1; TP_Hook_SMD
CANL: CANL1; TP_Hook_SMD
D1: LED_AMBER; CHIPLED_0805
D2: LED_GREEN; CHIPLED_0805
D3: LED_RED; CHIPLED_0805
D5: D_Zener_18V_SMBJ5355B-TP; DO-214AA
D6: LED_BLUE; CHIPLED_0805
GND_SHORT: GND_SHORT; TestPoint_Pad_D1.0mm
H2: CONN_MountingHole; PCIe_Mount
IM1: TP_1mm; TestPoint_Pad_D1.0mm
IP1: TP_1mm; TestPoint_Pad_D1.0mm
J1: isoSPI Header; PinHeader_2x03_P2.54mm_Vertical
J3: MicroFit_RA_2
J4: J_Programming_Pin_Header; J_Programming_Pin_Header_Keyed
J5: J_PCIe_x1; J_PCIe_x1_Key
K1: Relay_G5Q-1A4-DC5; Relay_SPST_OMRON-G5Q-1A4_OEM
Q1: SSM3K333R; SOT-23F
R1, R3, R21, R23: 1KR; R_0603
R2: R_5.1k; R_0603_1608Metric
R4: R_10k; R_0603_1608Metric
R5: R_120; R_0603_1608Metric
R7, R12, R15, R16, R19, R24, R25: R_10K; R_0603
R8, R9, R18: R_1K; R_0603
R10, R11: R_60.4; R_0603
R17: R_1M; R_0603
R20: R_576; R_0603
T1: HM2112ZNLT
TP4: CURRENT_TRIP; TestPoint_Pad_D1.0mm
U1, U4, U5, U6, U8: MCP6001; SOT-353_SC-70-5
U3: LTC6820HMS; MSOP-16_3x4mm_P0.5mm
U7: SN74LVC1G32DBVR; SOT-23-5_OEM
U10: STM32G441KBT6; LQFP-32_7x7mm_P0.8mm
U11: MCP2561-E_SN; SOIC-8_3.9x4.9mm_P1.27mm
VGND: V_GND_THRESHOLD; TestPoint_Pad_D1.0mm
VOUT: VOUT; TestPoint_Pad_D1.0mm
VSTATUS: VSTATUS; TestPoint_Pad_D1.0mm
VTRIP: VTRIP; TestPoint_Pad_D1.0mm
Y3: X_16MHz_18pF; FA238160000MBC0 (X_16MHz_18pF_SMD - FA-238_16.0000MB-C0)
kibuzzard-63B930AD: G***; kibuzzard-63B930AD
kibuzzard-63B9305B: G***; kibuzzard-63B9305B
kibuzzard-63B93076: G***; kibuzzard-63B93076
kibuzzard-63BB8A3F: G***; kibuzzard-63BB8A3F
kibuzzard-63BB8A53: G***; kibuzzard-63BB8A53
kibuzzard-63BF4A21: G***; kibuzzard-63BF4A21
kibuzzard-63BF57C4: G***; kibuzzard-63BF57C4
kibuzzard-673AE5D1: G***; kibuzzard-673AE5D1
kibuzzard-673AE69E: G***; kibuzzard-673AE69E
kibuzzard-673AE677: G***; kibuzzard-673AE677
kibuzzard-673AE688: G***; kibuzzard-673AE688
kibuzzard-698026CF: G***; kibuzzard-698026CF
kibuzzard-69802617: G***; kibuzzard-69802617
kibuzzard-69802858: G***; kibuzzard-69802858

Connections:
+3V3: C16.1, C17.1, C18.1, C19.1, C20.1, J4.3, J5.A2 (3.3V), U10.1 (VDD), U10.15 (VDDA), U10.17 (VDD)
+5V: C1.2, C6.1, C9.1, C10.1, C11.1, C12.1, C13.1, C22.1, D5.1 (K), J1.2, J5.B5 (5V), K1.5, R12.2, R17.1, R19.2, R24.1, U1.5 (V+), U3.6 (VDDS), U3.7 (POL), U3.8 (PHA), U3.9 (VDD), U3.12 (MSTR), U4.5 (V+), U5.5 (V+), U6.5 (V+), U7.5 (VCC), U8.5 (V+), U11.3 (VDD)
/BMS_RELAY_DRIVE: Q1.1 (G), R7.2, U10.18 ((TIM4_ETR/USART1_CK/GPIO_EXTI8)PA8)
/BSPD Current Sensor Trigger/CURRENT_TRIP: TP4.1, U6.1, U7.2 (in)
/BSPD Current Sensor Trigger/GND_SHORT: GND_SHORT.1, U5.1, U7.1 (in)
/BSPD Current Sensor Trigger/VSTATUS: R15.2, U4.1, U6.3 (+), VSTATUS.1
/BSPD Current Sensor Trigger/VTRIP: R19.1, R20.1, U6.4 (-), VTRIP.1
/BSPD Current Sensor Trigger/V_GND_THRESHOLD: R17.2, R18.1, U5.3 (+), VGND.1
/BSPD_CURRENT_THRESH: BSPD1.1, J5.B7 (io_3), U7.4 (out), U10.19 ((TIM2_CH3/TIM15_BKIN/USART1_TX/GPIO_EXT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)
/CANH: CANH.1, J5.A4 (CAN+), R5.1, U11.7 (CANH)
/CANL: CANL.1, J5.A5 (CAN-), R5.2, U11.6 (CANL)
/CAN_RX: U10.21 ((FDCAN1_RX/GPIO_EXTI11)PA11), U11.4 (RXD)
/CAN_TX: U10.22 ((FDCAN1_TX/GPIO_EXTI12)PA12), U11.1 (TXD)
/CSC_Comms: D2.2 (A), U10.11 ((TIM3_CH1/TIM16_CH1/GPIO_EXTI6/ADC2_IN3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)
/Error: D3.2 (A), U10.10 ((TIM2_ETR/TIM2_CH1/GPIO_EXTI5/ADC2_IN13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)
/FAN_PWM: J5.B6 (io_1), U10.5 ((TIM2_ETR/TIM2_CH1/GPIO_EXTI0/ADC2_IN1/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)
/Heartbeat: D1.2 (A), U10.12 ((TIM3_CH2/TIM17_CH1/GPIO_EXTI7/ADC2_IN4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)
/IM: IM1.1, J3.1, T1.1
/IP: IP1.1, J3.2, T1.3
/ISO_CS: J1.5, U3.5 (~CS), U10.25 ((TIM2_ETR/TIM2_CH1/GPIO_EXTI15)PA15)
/ISO_MISO: J1.1, U3.3 (MISO), U10.27 ((TIM17_BKIN/SPI1_MISO/TIM3_CH1/TIM16_CH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)
/ISO_MOSI: J1.4, U3.2 (MOSI), U10.28 ((TIM17_CH1/SPI1_MOSI/TIM3_CH2/TIM16_BKI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)
/ISO_SCK: J1.3, U3.4 (SCK), U10.26 ((TIM3_ETR/SPI1_SCK/TIM4_ETR/TIM2_CH2/GP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)
/NRST: C21.1, J4.4, U10.4 ((GPIO_EXTI10)PG10-NRST)
/SHDN_IN: J5.A17 (SHDN_IN/io_22), J5.A18 (SHDN_IN/io_24), K1.3
/SHDN_OUT: D6.2 (A), J5.B17 (SHDN_OUT/io_23), J5.B18 (SHDN_OUT/io_25), K1.2
/SWCLK: J4.5, U10.24 ((SYS_JTCK-SWCLK/GPIO_EXTI14)PA14)
/SWDIO: J4.1, U10.23 ((SYS_JTMS-SWDIO/GPIO_EXTI13)PA13)
/VOUT_CURRENT_SENSE: R2.1, R12.1, U1.1, U1.4 (-), U4.3 (+), U5.4 (-), VOUT.1
GND: C1.1, C6.2, C7.2, C8.2, C9.2, C10.2, C11.2, C12.2, C13.2, C14.2, C15.2, C16.2, C17.2, C18.2, C19.2, C20.2, C21.2, C22.2, J1.6, J4.2, J5.A3 (GND), J5.A6 (io_0), J5.A7 (io_2), J5.A8 (io_4), J5.A9 (io_6), J5.B4 (GND), Q1.2 (S), R1.2, R3.2, R4.2, R7.1, R9.2, R18.2, R20.2, R21.2, R23.2, R25.2, U1.2 (V-), U3.1 (EN), U3.13 (SLOW), U3.14 (GND), U4.2 (V-), U5.2 (V-), U6.2 (V-), U7.3 (GND), U8.2 (V-), U10.14 (VSSA), U10.16 (VSS), U10.32 (VSS), U11.2 (VSS), U11.8 (STBY), Y3.2, Y3.4
unnamed: C7.1, R10.2, R11.1
unnamed: C8.1, T1.11
unnamed: D1.1 (K), R1.1
unnamed: D2.1 (K), R3.1
unnamed: D3.1 (K), R21.1
unnamed: D5.2 (A), K1.1, Q1.3 (D)
unnamed: D6.1 (K), R23.1
unnamed: J5.B8 (io_5), U1.3 (+)
unnamed: R8.1, U3.16 (IBIAS)
unnamed: R8.2, R9.1, U3.15 (ICMP)
unnamed: R10.1, T1.12, U3.10 (IM)
unnamed: R11.2, T1.10, U3.11 (IP)
unnamed: R15.1, R16.2, U4.4 (-)
unnamed: R24.2, R25.1, U8.3 (+)
unnamed: R16.1, U8.1, U8.4 (-)
unnamed: R2.2, R4.1, U10.9 ((USART2_CK/TIM3_CH2/GPIO_EXTI4/ADC2_IN1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)
unnamed: C15.1, U10.2 (PF0-OSC_IN), Y3.3
unnamed: C14.1, U10.3 (PF1-OSC_OUT), Y3.1
