olin-electric-motorsports/oem-monorepo/vehicle/mkiii/hardware/lv/Shutdown_Circuit_Sensor.kicad_sch

## KiCad design vehicle/mkiii/hardware/lv/Shutdown_Circuit_Sensor.kicad_sch (2026-01-27)

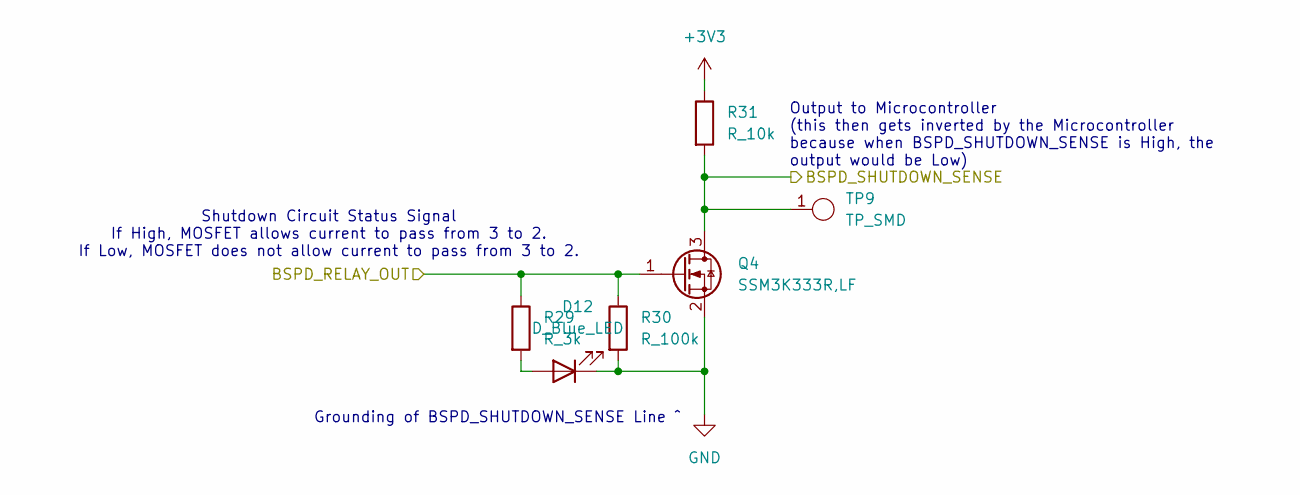
[picture p47: schematic Shutdown_Circuit_Sensor.kicad_sch]

Parts:
D12: D_Blue_LED; D_0805_2012Metric; MPN LTST-C171TBKT
Q4: SSM3K333R,LF; SOT-23-3
R29: R_3k; R_0603_1608Metric; MPN RC0603FR-103KL
R30: R_100k; R_0603_1608Metric; MPN RMCF0603FT100K
R31: R_10k; R_0603_1608Metric; MPN RMCF0603FT10K0
TP9: TP_SMD; TP_Hook_SMD; MPN 5019

Connections:
BSPD_RELAY_OUT: Q4.1 (G), R29.1, R30.1
BSPD_SHUTDOWN_SENSE: Q4.3 (D), R31.2, TP9.1
unnamed: D12.1 (K), Q4.2 (S), R30.2
unnamed: D12.2 (A), R29.2

Notes on the sheet:
Output to Microcontroller (this then gets inverted by the Microcontroller because when BSPD_SHUTDOWN_SENSE is High, the output would be Low)
Grounding of BSPD_SHUTDOWN_SENSE Line ^
Shutdown Circuit Status Signal If High, MOSFET allows current to pass from 3 to 2. If Low, MOSFET does not allow current to pass from 3 to 2.
