olin-electric-motorsports/oem-monorepo/vehicle/mkviii/software/sensing/brake_temp_sensor/brake_temp.c

#include "brake_temp.h"
#include "can_api.h"


// Initialize Variables and Functions
// Variable Declarations
float bit_voltage = 0;
float measured_voltage = 0;
uint16_t temperature = 0;
int delayval = 500;
uint16_t temperature_message = 0;
//int can_init_brake_temp(void);
//int can_send_brake_temperature(void);
// Blinky


void init_peripherals(void) {
 HAL_Init();
 SystemClockConfig();
 GpioInit();
 oem_adc_init(&brake_temp_sensor);
 //can_init_brake_temp();
 //can_send_brake_temperature(); // Send initial CAN message
 }

// Trigger Debug LED
void update_debug(void) {
 HAL_GPIO_TogglePin(GPIOA, DEBUG_LED);
 delayval = 100;
}


void get_temperature(void) {
  //bit_voltage = oem_adc_read(&brake_temp_sensor);
  bit_voltage = 500;
  HAL_Delay(10);
  measured_voltage = (bit_voltage / 4095.0) * 3.3;
  temperature = (measured_voltage - 0.5) * 200;
}


int main(void) {
 init_peripherals();
 while (1)
 {
   HAL_Delay(delayval); // Fast"
  HAL_GPIO_TogglePin(GPIOA, HEARTBEAT_LED);
  get_temperature();
  delayval = 500;
  
  brake_temperature.temperature = temperature; //Can Testing
  can_send_brake_temperature();

  if (measured_voltage >= 3.0) {
    update_debug();
  }
  

  //can_poll_receive_all();
  //temperature_message = brake_temperature.temperature;
  //temperature_message = brake_temperature.temperature;
 }
 return 0;
}
