olin-electric-motorsports/oem-monorepo/vehicle/examples/software/blinky/blinky.h

#pragma once
#include "stm32g4xx_hal.h"

#define PA1_GPIO_Port   GPIOA
#define PA1_Pin         GPIO_PIN_1

void SystemClockConfig();

// Function Prototypes
void GpioInit(void);
void SysTick_Handler(void);
void SystemClockConfig(void);
