olin-electric-motorsports/oem-monorepo/(commit log)

2026-01-25 initial release of new oem monorepo, can view earlier iterations on Jacob Likins github
    [C_1000uF_25V_Radial - UPS1E102MHD.stp, C_100uF_100V_Radial - 100ZLH100MEFC12.5X16.step, C_100uF_50V_Radial - ESK107M050AG3EA.stp, C_10uF_450V_Radial - 450BXC10MEFC10X20.stp, D_Schottky_100V_1A_SOD123W - SS110LW.stp, J_Ampseal_14_RA - 1-776266-1.step, J_Ampseal_14_VT - AmpSeal-14.step, J_Ampseal_23_RA - 776087-1.step]
2026-01-27 inital file add for CSC
    This has PCB for the CSC
    [DA_I2C_Pull_Up_Resistor.kicad_sch, PCIE1_connect.kicad_sch, bms_csc.kicad_pcb, bms_csc.kicad_sch, filter-balance.kicad_sch, i2c_add_jumper.kicad_sch, isoSPI-transformer.kicad_sch, mux_input_lpfs.kicad_sch]
2026-01-27 initial brake temp pcb
    [braketemperature.kicad_pcb, braketemperature.kicad_sch]
2026-01-27 initial VCU board
    [BSPD.kicad_sch, BrakeLight.kicad_sch, CAN_Transceiver.kicad_sch, PCIe_x1_Connector.kicad_sch, Shutdown_Circuit_Sensor-Brake.kicad_sch, Shutdown_Circuit_Sensor.kicad_sch, Shutdown_Sense_Inertial_Switch-Throttle.kicad_sch, Throttle_Position_Sensor.kicad_sch]
2026-01-27 initial charging board
    [J1772_V2.kicad_pcb, J1772_V2.kicad_sch]
2026-01-27 tsal-ail: initial board upload
    [tsal-ail.kicad_pcb, tsal-ail.kicad_sch]
2026-01-28 initial board: rkh
    Added initial PCB and electrical schematic design for the roadkill harness. The purpose of the roadkill harness is to test the other PCB boards in the low voltage system, in an off-car environment. I still need to route the VCU PCIE, and thicken the 5 volt wires.
    [rkh.kicad_pcb, rkh.kicad_sch]
2026-01-28 Fixed symbol part issues
    [J1772_V2.kicad_sch, braketemperature.kicad_sch, rkh.kicad_sch]
2026-01-29 initial tire temperature sensor kicad files
    [tiretempsensor.kicad_pcb, tiretempsensor.kicad_sch]
2026-02-10 Roadkill Harness Schematics and PCB
    authored-by: jackk36 <jgoode736@gmail.com>
    [buck.kicad_sch, rkh.kicad_pcb, rkh.kicad_sch]
2026-02-10 Tire Temperature Sensor Schematics and PCB
    [bom.csv, designators.csv, positions.csv, tire_temp_sensor.kicad_pcb, tire_temp_sensor.kicad_sch]
2026-02-10 Brake Temperature Sensor Schematics and PCB
    [bom.csv, braketemperature.kicad_pcb, braketemperature.kicad_sch, designators.csv, positions.csv]
2026-02-10 Added TorqueSensor schematic and pcb. (#12)
    [TorqueSensor.kicad_pcb, TorqueSensor.kicad_sch, bom.csv, designators.csv, positions.csv, tiretempsensor.kicad_sch]
2026-02-10 BMS Core and PCB
    [bms_core.kicad_pcb, bms_core.kicad_sch, bom.csv, bspd_current_sense.kicad_sch, designators.csv, isospi-interface.kicad_sch, m_2_connector.kicad_sch, positions.csv]
2026-02-10 VCU Schematic and PCB (#13)
    [BSPD.kicad_sch, BrakeLight.kicad_sch, CAN_Transceiver.kicad_sch, PCIe_x1_Connector.kicad_sch, Shutdown_Circuit_Sensor-Brake.kicad_sch, Shutdown_Sense_Inertial_Switch-Throttle.kicad_sch, Shutdown_Sensors.kicad_sch, Throttle_Position_Sensor.kicad_sch]
2026-02-17 corrected folder name cause I only now realized :|
    [BSPD.kicad_sch, BrakeLight.kicad_sch, DA_I2C_Pull_Up_Resistor.kicad_sch, J1772_V2.kicad_pcb, J1772_V2.kicad_sch, PCIE1_connect.kicad_sch, PCIe_x1_Connector.kicad_sch, Shutdown_Sensors.kicad_sch]
2026-04-04 ADC library & example code
    Fully working ADC library to make using ADC pin easier. Also There was a sneaky fix for the clock so timing would actually be correct for everyones boards
    [adc.c, adc.h, adc_example.c, adc_example.h, adc_example_config.c]
2026-04-04 Final version of roadkill harness
    [bom.csv, braketemperature.kicad_sch, buck.kicad_sch, designators.csv, positions.csv, rkh.kicad_pcb, rkh.kicad_sch]
2026-04-04 fixed error file
    [buck.kicad_sch]
2026-04-04 Precharge-Discharge Board Schematics and PCB
    [bom.csv, designators.csv, positions.csv, prechargedischarge_mkviii.kicad_pcb, prechargedischarge_mkviii.kicad_sch]
2026-04-04 Charging Board Schematics and PCB (#16)
    [CAN_CONTROLLER.kicad_sch, bom.csv, charging_cart_controller.kicad_pcb, charging_cart_controller.kicad_sch, designators.csv, positions.csv]
2026-04-11 Power-Thermistor Schematics and PCB (#24)
    [Connector(1).kicad_sch, Connector(2).kicad_sch, Connector(3)(1).kicad_sch, PowerThermistorOutlineSketch.DXF, Thermistors(1).kicad_sch, Thermistors(2)(1).kicad_sch, bom.csv, cells.kicad_sch]
2026-04-11 BMS Motherboard Schematics and PCB Layout (#19)
    [bms-motherboard.kicad_pcb, bms-motherboard.kicad_sch, bom.csv, braketemperature.kicad_sch, data_aquisition_module.kicad_pcb, data_aquisition_module.kicad_sch, designators.csv, positions.csv]
2026-04-11 fix file and bazel constrants
    [CAN_CONTROLLER.kicad_sch, Connector(1).kicad_sch, Connector(2).kicad_sch, Connector(3)(1).kicad_sch, Thermistors(1).kicad_sch, Thermistors(2)(1).kicad_sch, cells.kicad_sch, charging_cart_controller.kicad_sch]
2026-04-18 Power-Therm (Rev. 2) and Git Hooks Script Changes (#25)
    [Connector(1).kicad_sch, Connector(2).kicad_sch, Connector(3)(1).kicad_sch, Thermistors(1).kicad_sch, Thermistors(2)(1).kicad_sch, bom.csv, cells.kicad_sch, designators.csv]
2026-09-17 Update KiCad installation to version 10.0 (#28)
2026-09-20 2025-26 DY Repo Cleanup (#27)
    [8-uSOP.step, BSPD.kicad_sch, BrakeLight.kicad_sch, C_1000uF_25V_Radial - UPS1E102MHD.stp, C_100uF_100V_Radial - 100ZLH100MEFC12.5X16.step, C_100uF_50V_Radial - ESK107M050AG3EA.stp, C_10uF_450V_Radial - 450BXC10MEFC10X20.stp, DA_I2C_Pull_Up_Resistor.kicad_sch]
2026-11-06 cleaned up layout and fixed flashing LED (#51)
    Accepting changes. Documented notes in PR for additional future improvements
2026-11-13 Added updated pcb and firmware from last sem
